anthonyle-ql/Salinas/docs/Salinas.JPG

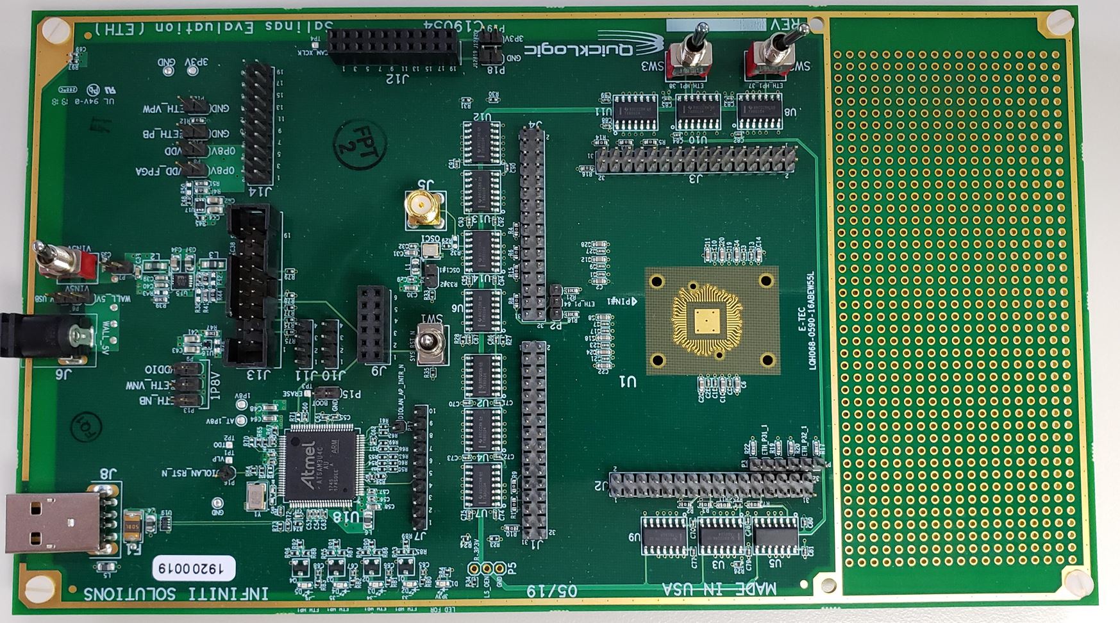
docs/Salinas.JPG
