anthonyle-ql/Salinas/docs/Update to Salinas Design.docx

Last Update: September 4, 2020

Version: 1.1

Subject: Salinas v1.1 Update

Summary of Update by page #

Page 1: no change; version # only

Page 2:

a. Change resistor value from 10KOhm to 1KOhm for R17, R20, R18, R21, R19 and R22 (BOM change)

Page 3:

a. Change R23, R24, R25, R26, R27 and R28 to 0 Ohm (BOM change)
b. Replace TXB0104DR with TXS0104EDR (BOM change)

Page 4:

a. Change R30, R31 and R34 to 0 Ohm (BOM change)
b. Change R35, R36 and R37 from 10KOhm to 1KOhm (BOM change)
c. Change TXB0104DR to TXS0104EDR (BOM change)

Page 5:

a. Add ground connection for J6 pin 2 (layout update)

Page 6:

a. Replace J8 with microUSB connector (layout update)
b. U18 is DNP (BOM change)

Page 7:

a. Add P20, a 1x2 header; connection as shown in schematic (layout update)

Page 8: No change

Page 9: No change
