anthonyle-ql/Salinas/docs/Salinasv1.1.pptx

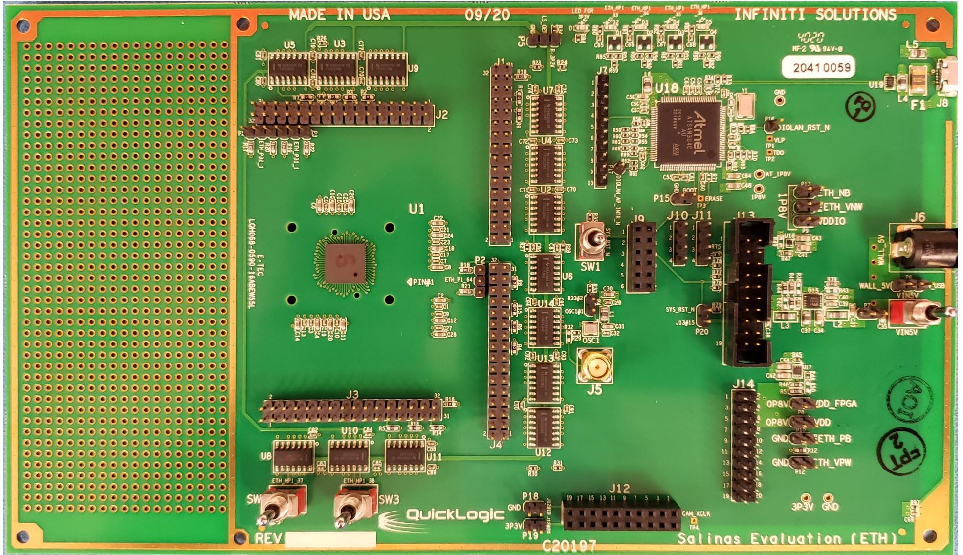
[picture p2: figure]

## Slide 2

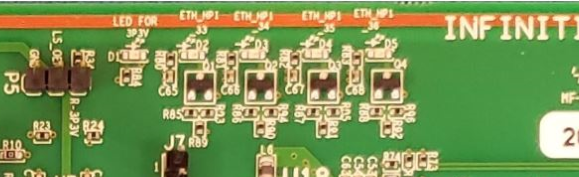
[picture p3: figure]

## Slide 3

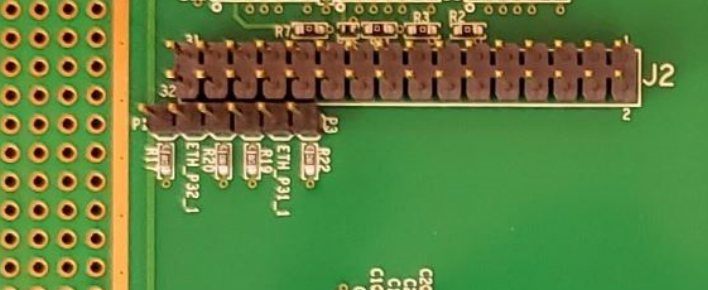
[picture p4: figure]
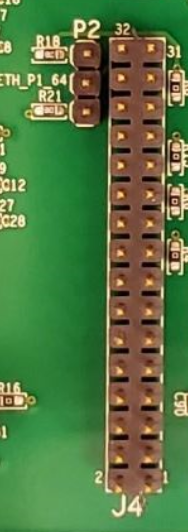
[picture p5: figure]

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
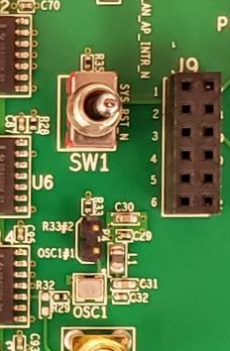
[picture p6: figure]

PU

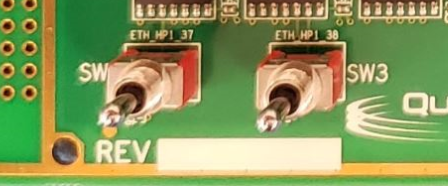
[picture p7: figure]

PU

GND

PU

GND

GND

## Slide 4

## Slide 5

## Slide 6
