anthonyle-ql/Salinas/docs/Salinas1.0 Bring Up Report.xlsx

Last Update: August 18, 2020
Subject: Salinas 1.0 bring up report
Index | Description | Action | Comment
1 | J8 foot print leaves no room for connecting an external USB externsion cable to the USB connector. | There are several possible fixes: 1. Stripped off the end of the expansion and use only the assertion cable. 2. Find straight connector to mount vertically. This may interferes with Fuse F1. 3. Move the foot print to the edge of the board. | Current solution is (2).
2 | Missing 3x1 male header at location P5 | To inform Infiniti solutions to update BOM assembly.
3 | Part Number for U18 is wrong. A generic Atmel device is not the correct part #. It must be the Diolan programmed part number. | To update BOM and inform Infiniti Solutions of BOM update.
4 | ETH_P28_1 signal is pull-up thru a zero ohm resistor . | This is wrong. Possible solutions: 1. change resistor to 10K (for pull-up) 2. Remove the resistor if not need. | Current solution is (2).
5 | J6 is missing GND | Update schematic
6 | The TXB0104DR requires stronger pull to get it to work for bidirectional control | Talk to Greg to understand the fixes | TBD
