anthonyle-ql/Salinas/from Infiniti Solutions/C20197-SALINAS_V1_1-CR.PDF

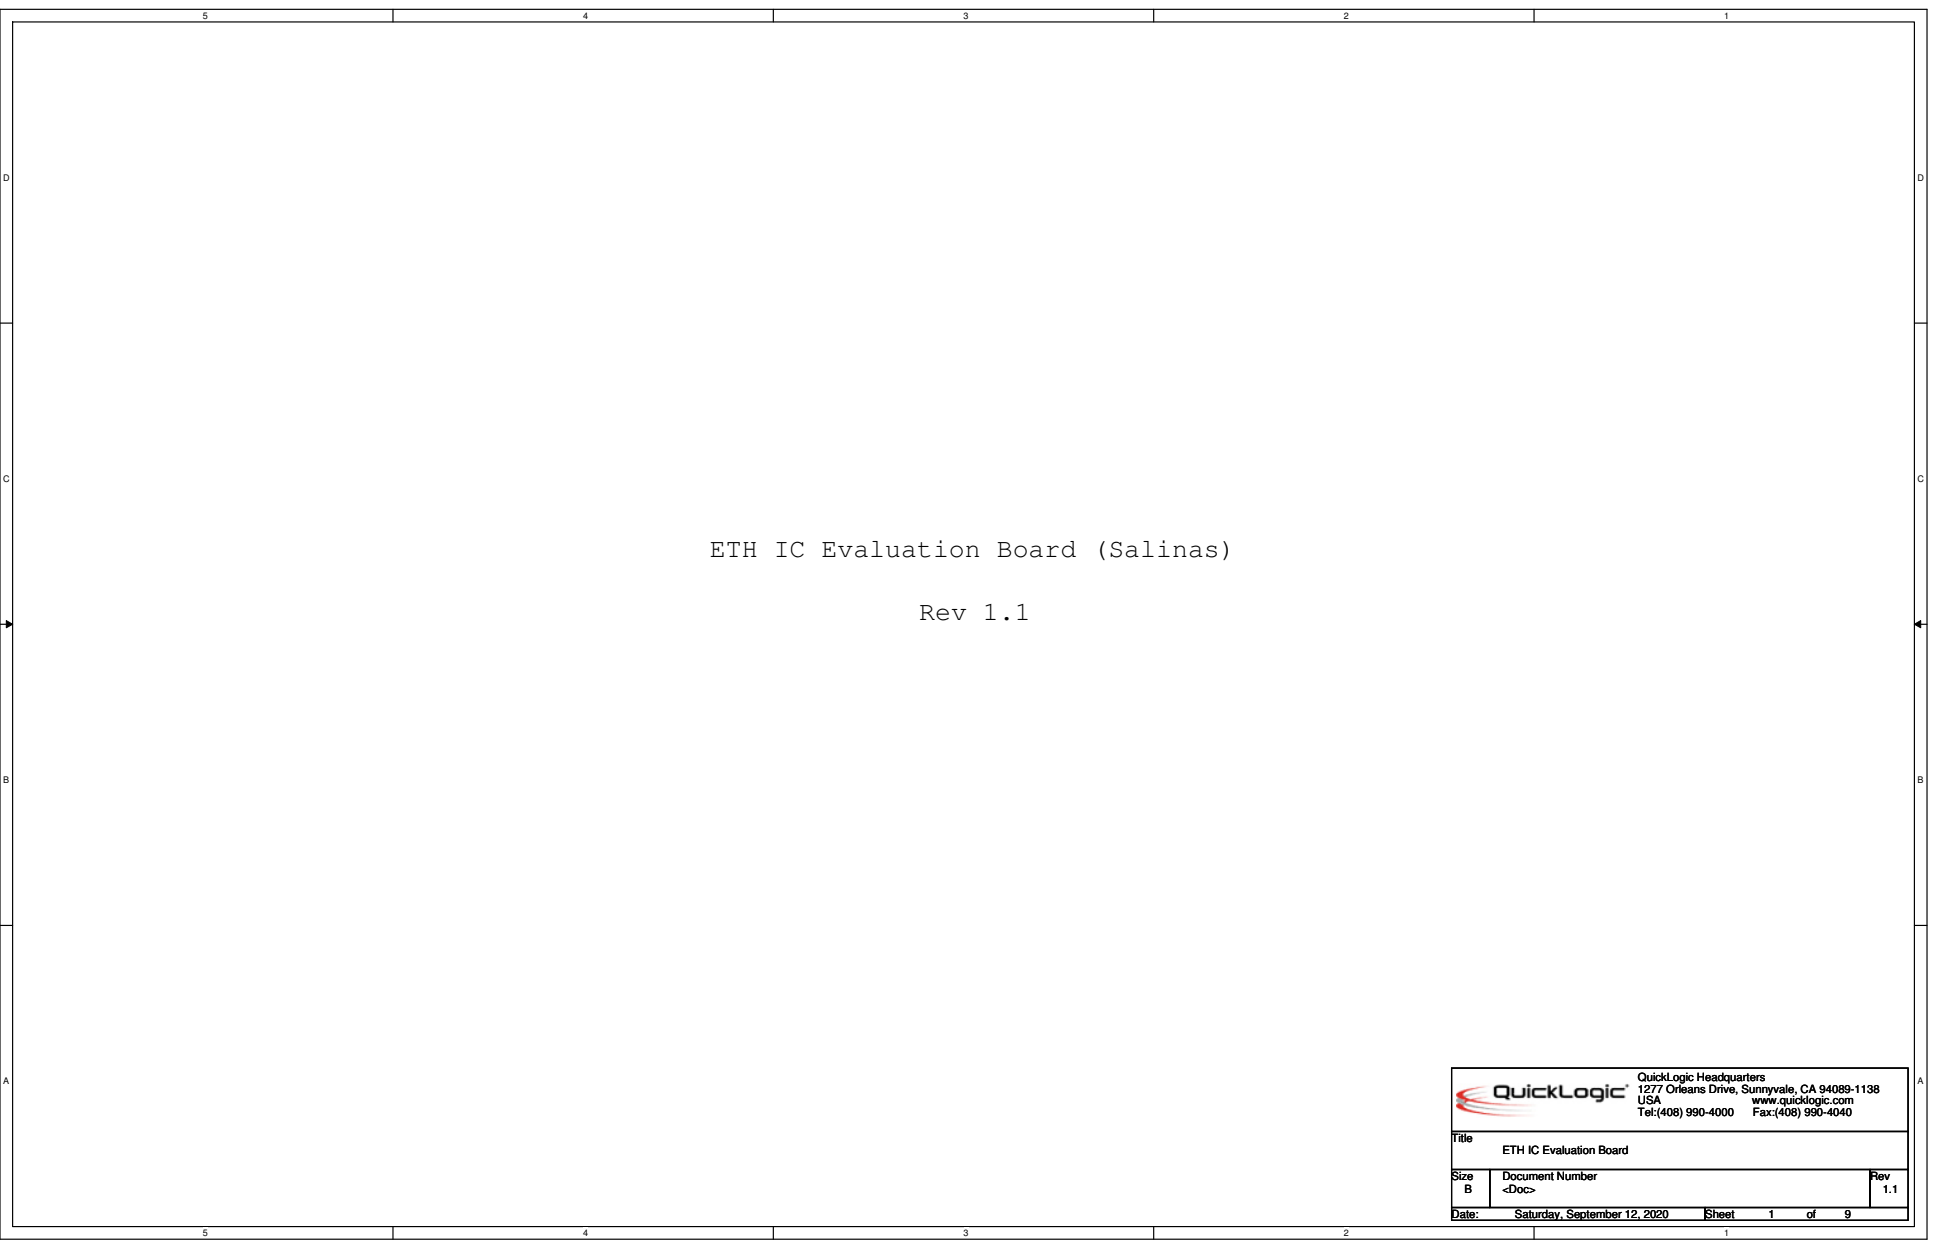
[picture p8: page 1]
Rev 1.1; Title; USA; www.quicklogic.com; Tel:(408) 990-4000; Fax:(408) 990-4040

ETH IC Evaluation Board (Salinas)

QuickLogic Headquarters
1277 Orleans Drive, Sunnyvale, CA 94089-1138

ETH IC Evaluation Board

Size Size Size B B B | Document Number Document Number Document Number <Doc> <Doc> <Doc> | Rev Rev Rev 1.1 1.1 1.1

Date: Date: Date: Saturday, September 12, 2020 Saturday, September 12, 2020 Saturday, September 12, 2020 | Sheet Sheet Sheet 1 1 1 of of of 9 9 9

# 68602-132HLF 13579

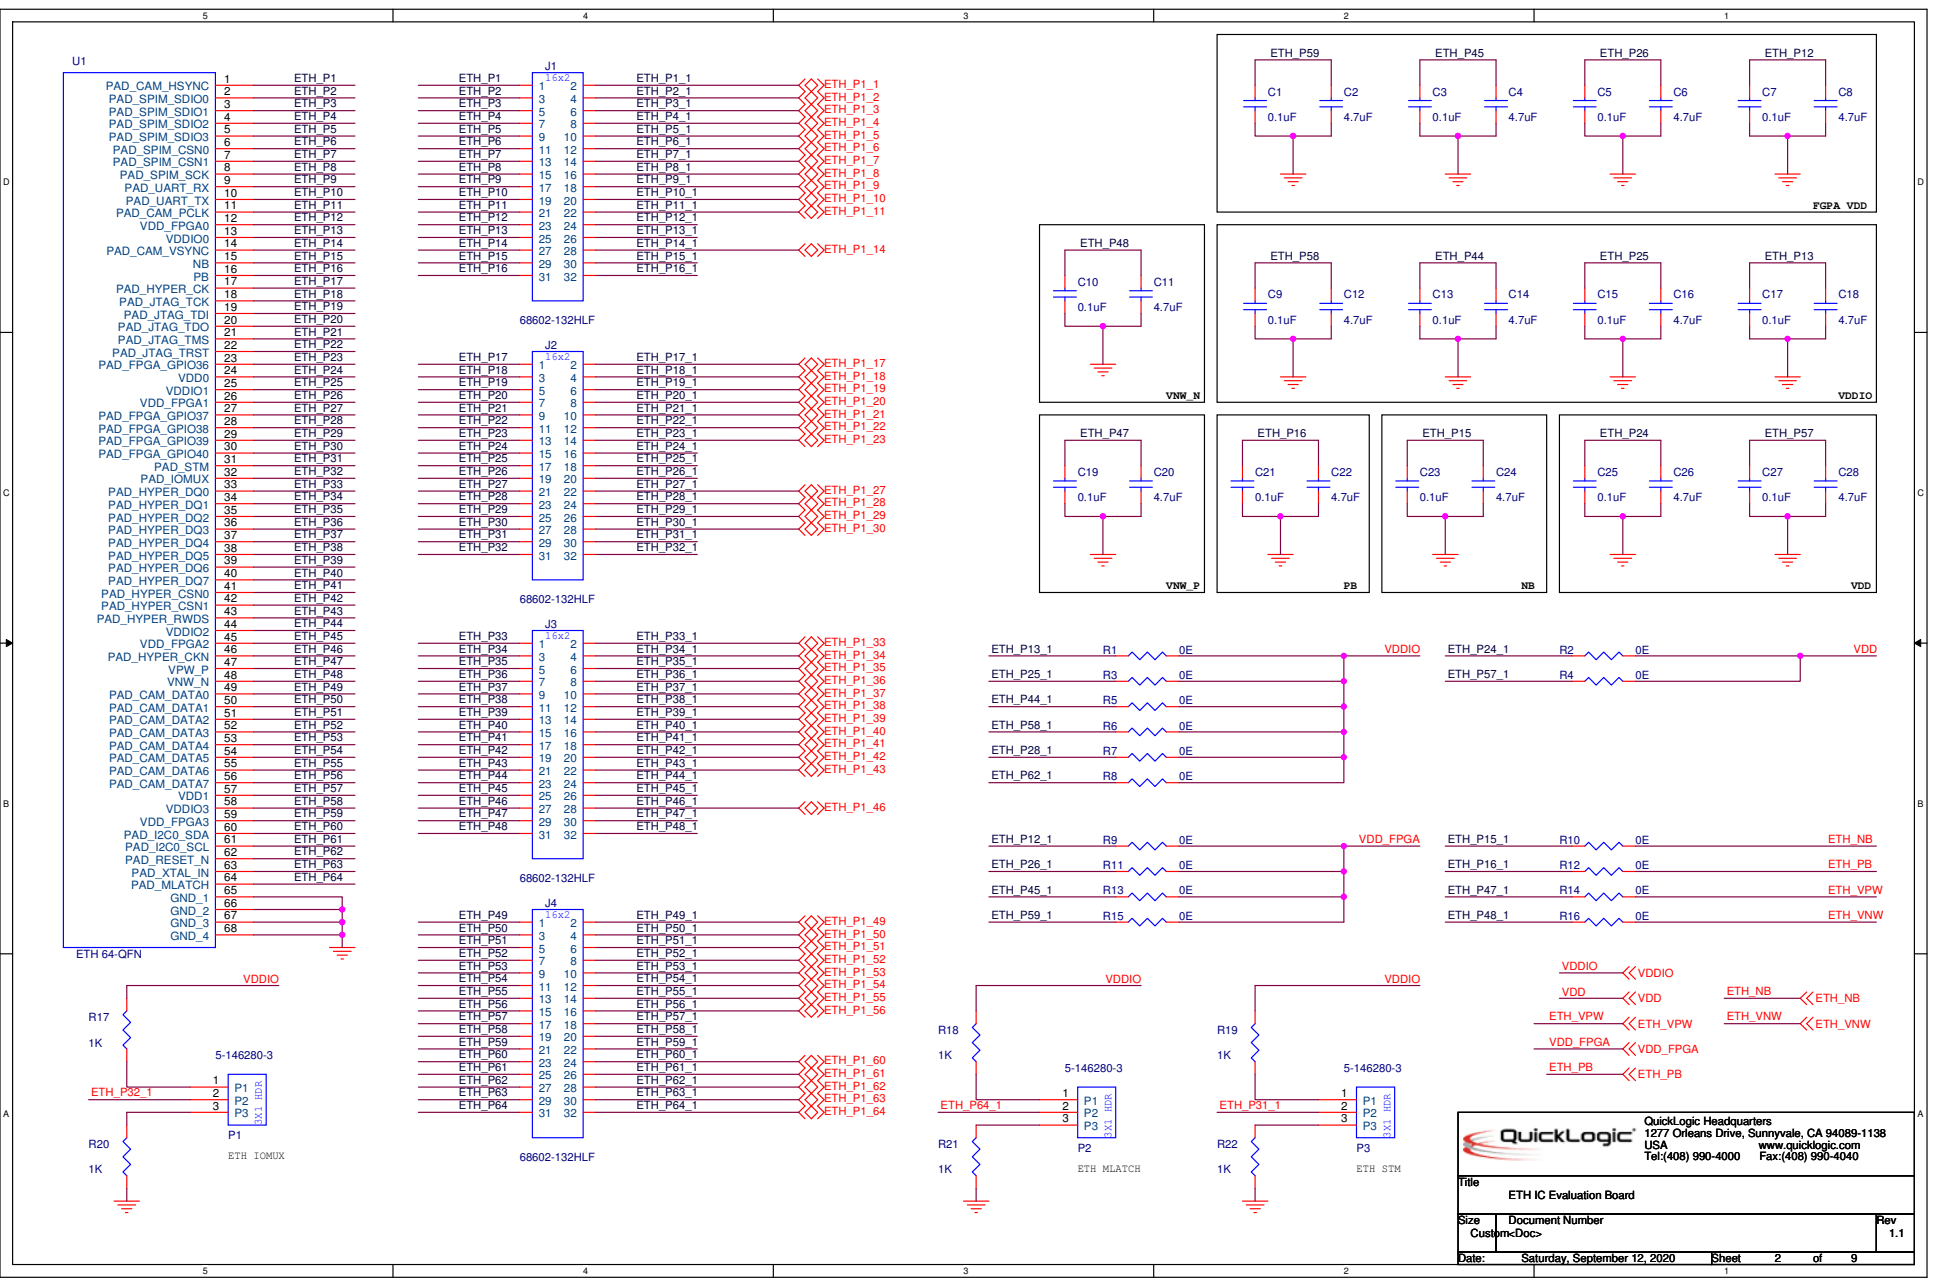
[picture p9: page 2]

QuickLogic Headquarters
1277 Orleans Drive, Sunnyvale, CA 94089-1138

ETH IC Evaluation Board

Size Size Size Custom Custom Custom | Document Number Document Number Document Number <Doc> <Doc> <Doc> | Rev Rev Rev 1.1 1.1 1.1

Date: Date: Date: Saturday, September 12, 2020 Saturday, September 12, 2020 Saturday, September 12, 2020 | Sheet Sheet Sheet 2 2 2 of of of 9 9 9

3P3V | 3P3V | LEVEL SHIFTERS

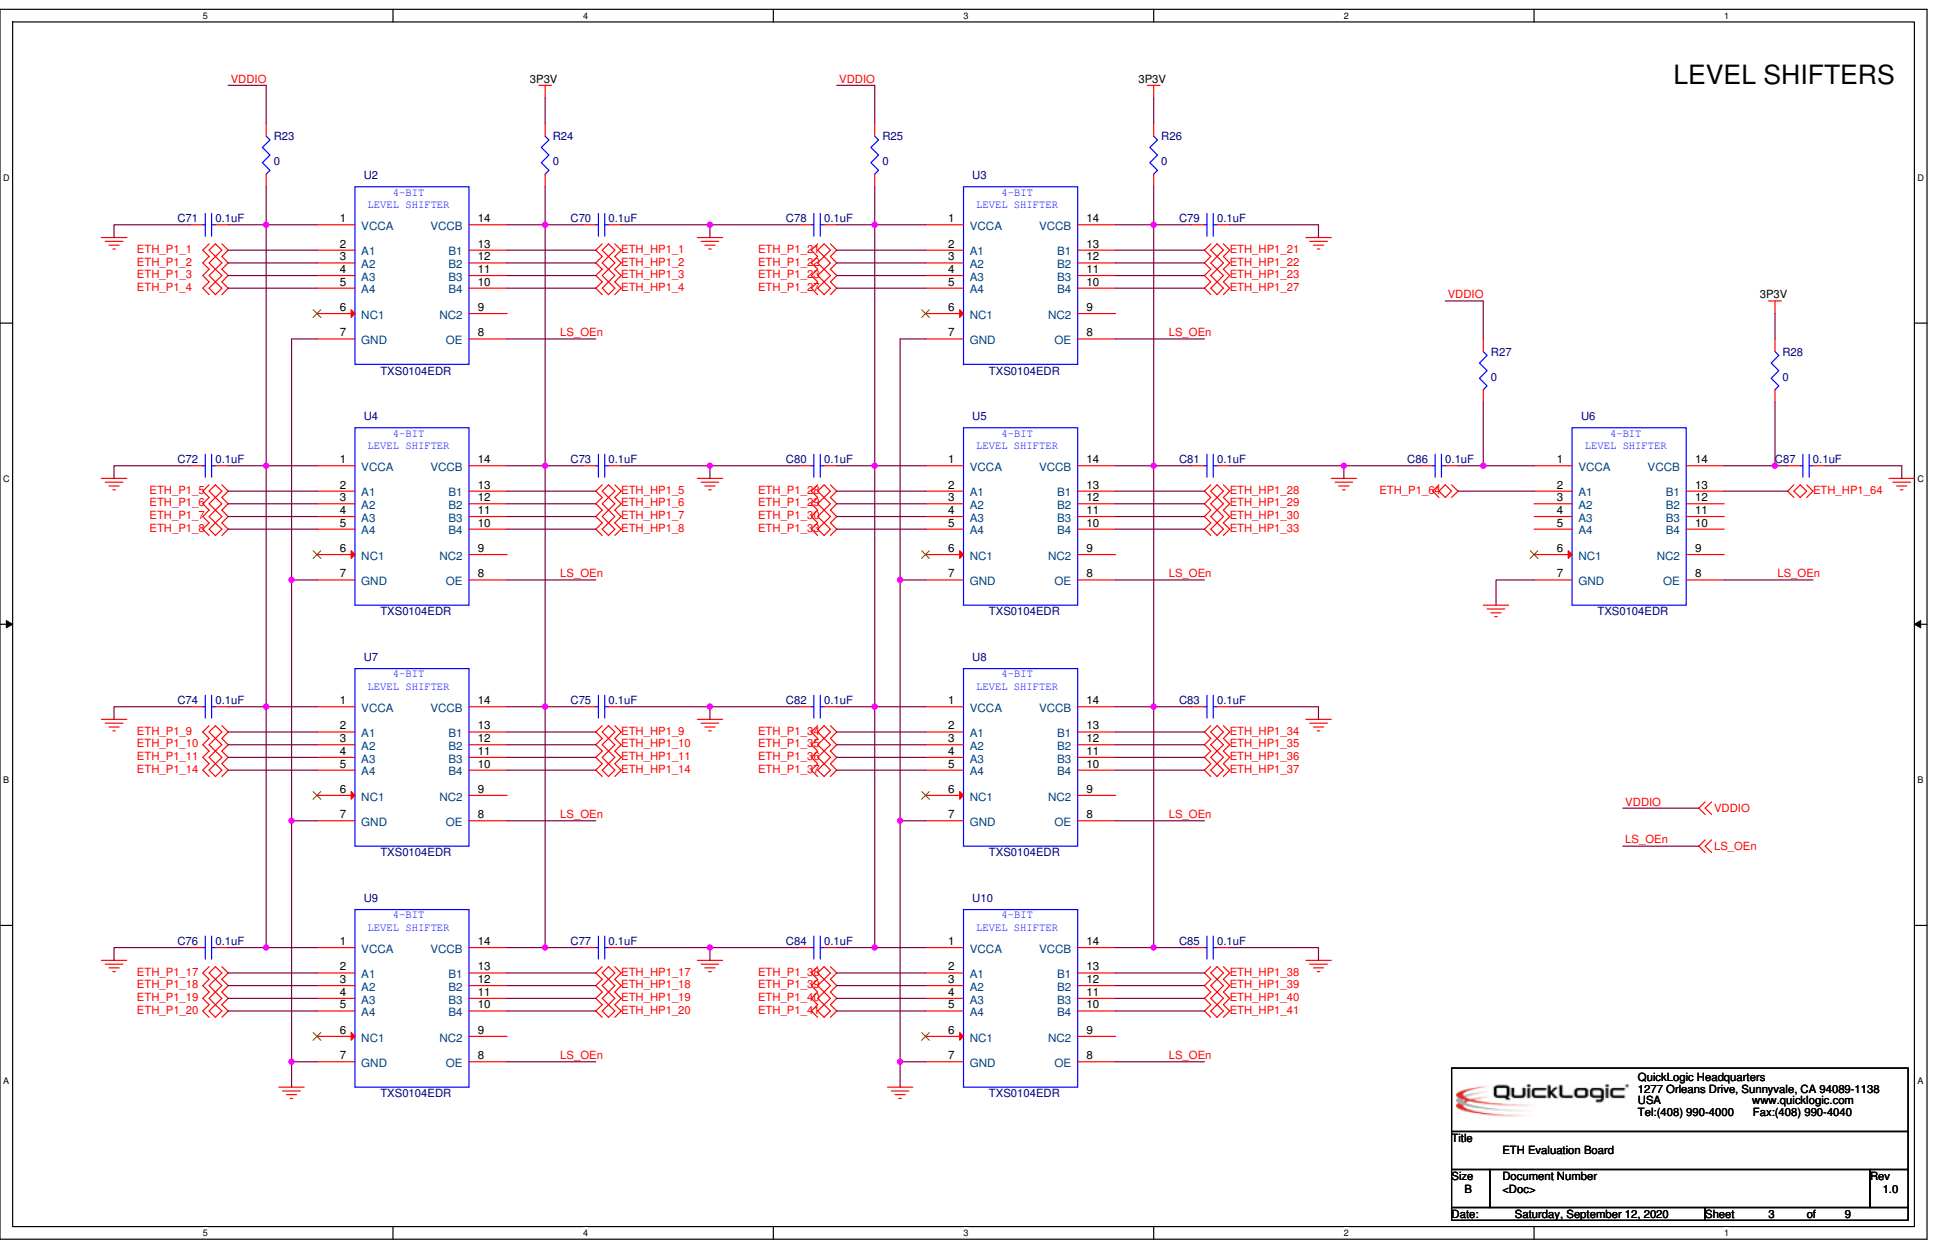
[picture p10: page 3]

QuickLogic Headquarters
1277 Orleans Drive, Sunnyvale, CA 94089-1138

Size Size Size B B B | Document Number Document Number Document Number <Doc> <Doc> <Doc> | Rev Rev Rev 1.0 1.0 1.0

Date: Date: Date: Saturday, September 12, 2020 Saturday, September 12, 2020 Saturday, September 12, 2020 | Sheet Sheet Sheet 3 3 3 of of of 9 9 9

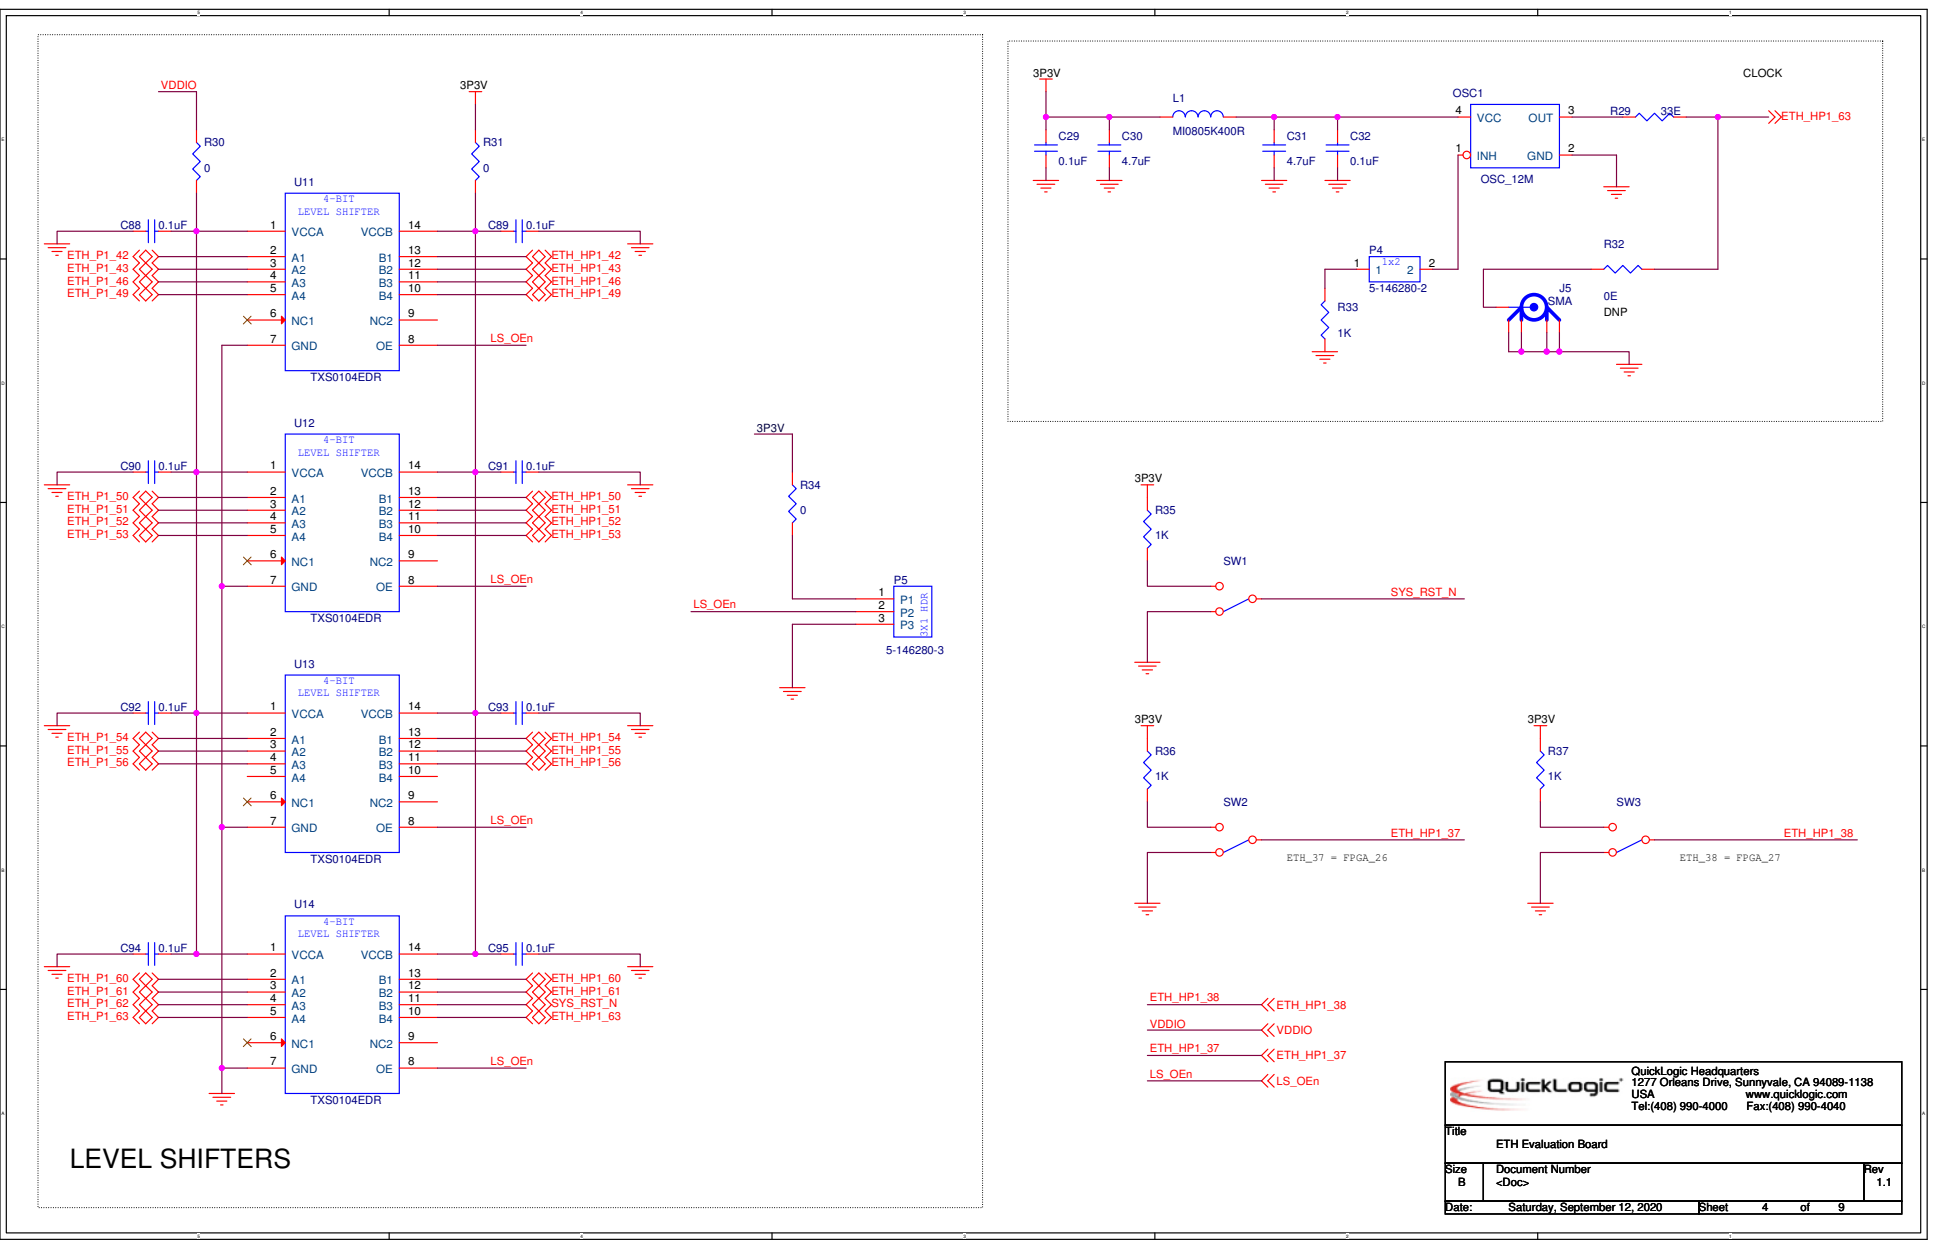
[picture p11: page 4]

QuickLogic Headquarters
1277 Orleans Drive, Sunnyvale, CA 94089-1138

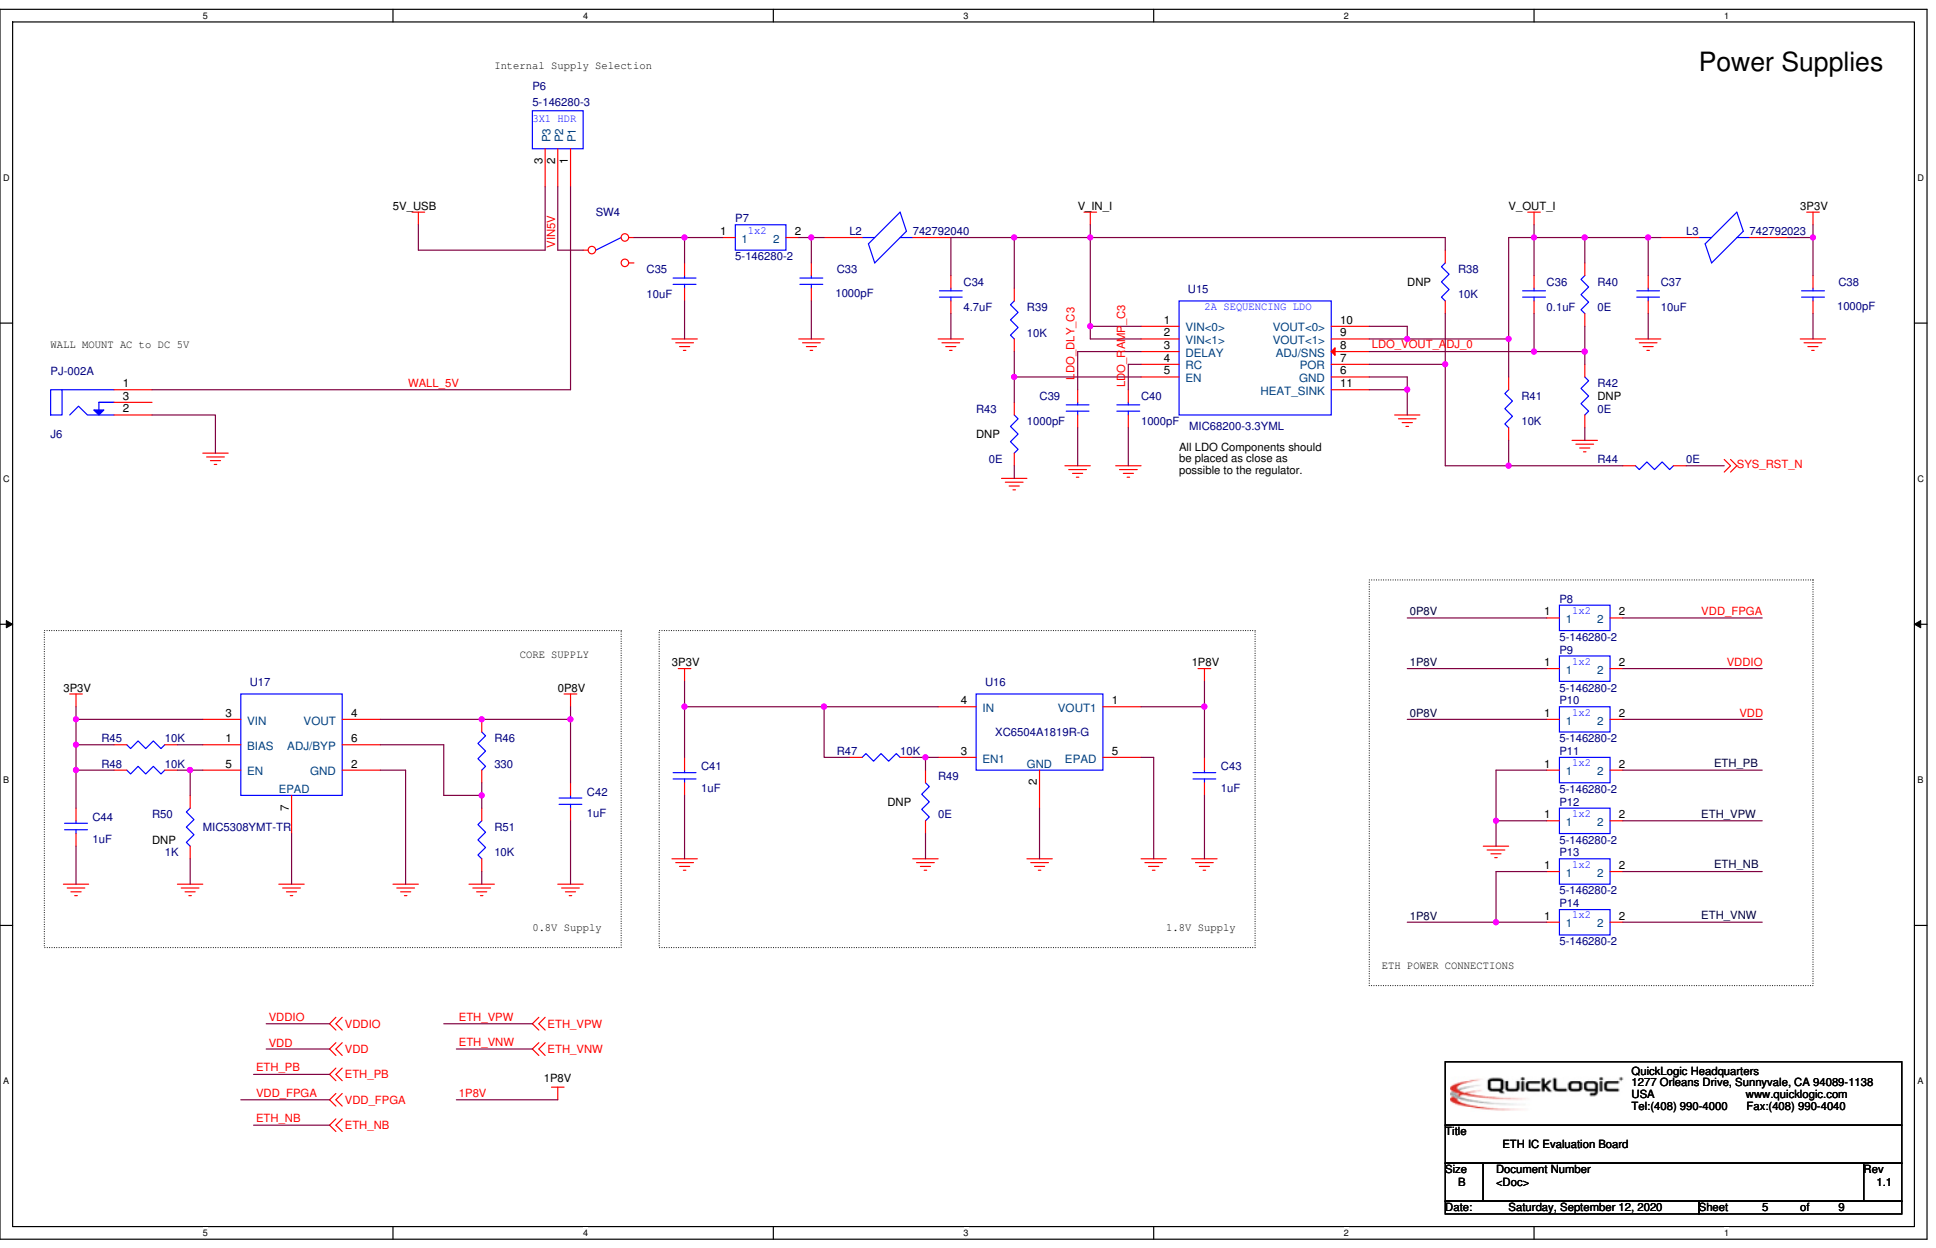
[picture p12: page 5]

WALL MOUNT AC to DC 5V

MIC68200-3.3YML
All LDO Components should
be placed as close as
possible to the regulator.

QuickLogic Headquarters
1277 Orleans Drive, Sunnyvale, CA 94089-1138

ETH IC Evaluation Board

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

Date: Date: Date: Saturday, September 12, 2020 Saturday, September 12, 2020 Saturday, September 12, 2020 | Sheet Sheet Sheet 5 5 5 of of of 9 9 9

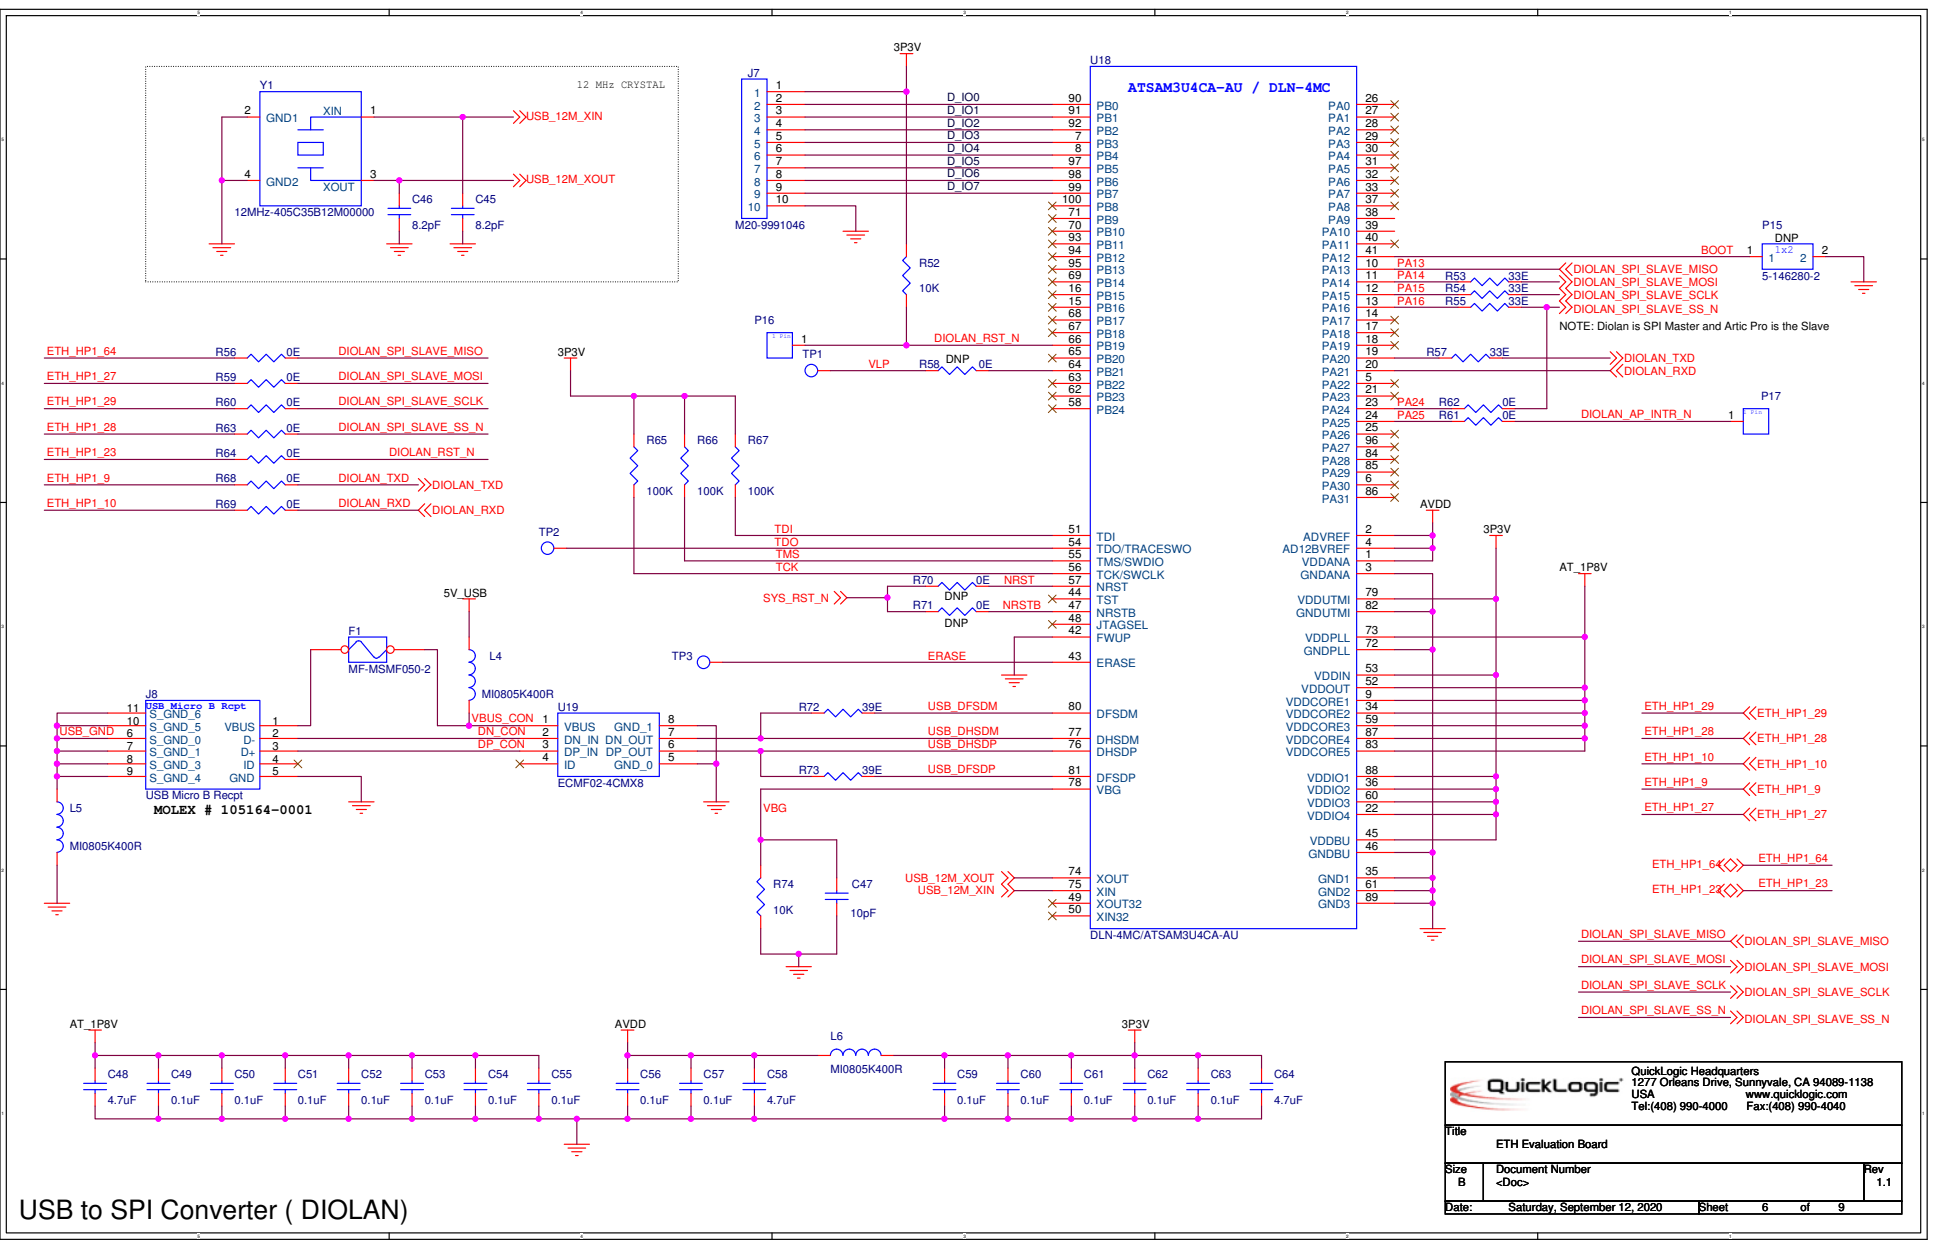
[picture p13: page 6]

5 | D_IO3 | PB3 7
6 | D_IO4 | PB4 8
7 | D_IO5 | PB5 97
8 | D_IO6 | PB6 98
9 | D_IO7 | PB7 99

DIOLAN_SPI_SLAVE_MISO
DIOLAN_SPI_SLAVE_MOSI
DIOLAN_SPI_SLAVE_SCLK
DIOLAN_SPI_SLAVE_SS_N
NOTE: Diolan is SPI Master and Artic Pro is the Slave

QuickLogic Headquarters
1277 Orleans Drive, Sunnyvale, CA 94089-1138

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

USB to SPI Converter ( DIOLAN)

Date: Date: Date: Saturday, September 12, 2020 Saturday, September 12, 2020 Saturday, September 12, 2020 | Sheet Sheet Sheet 6 6 6 of of of 9 9 9

# EXPANSION HEADERS

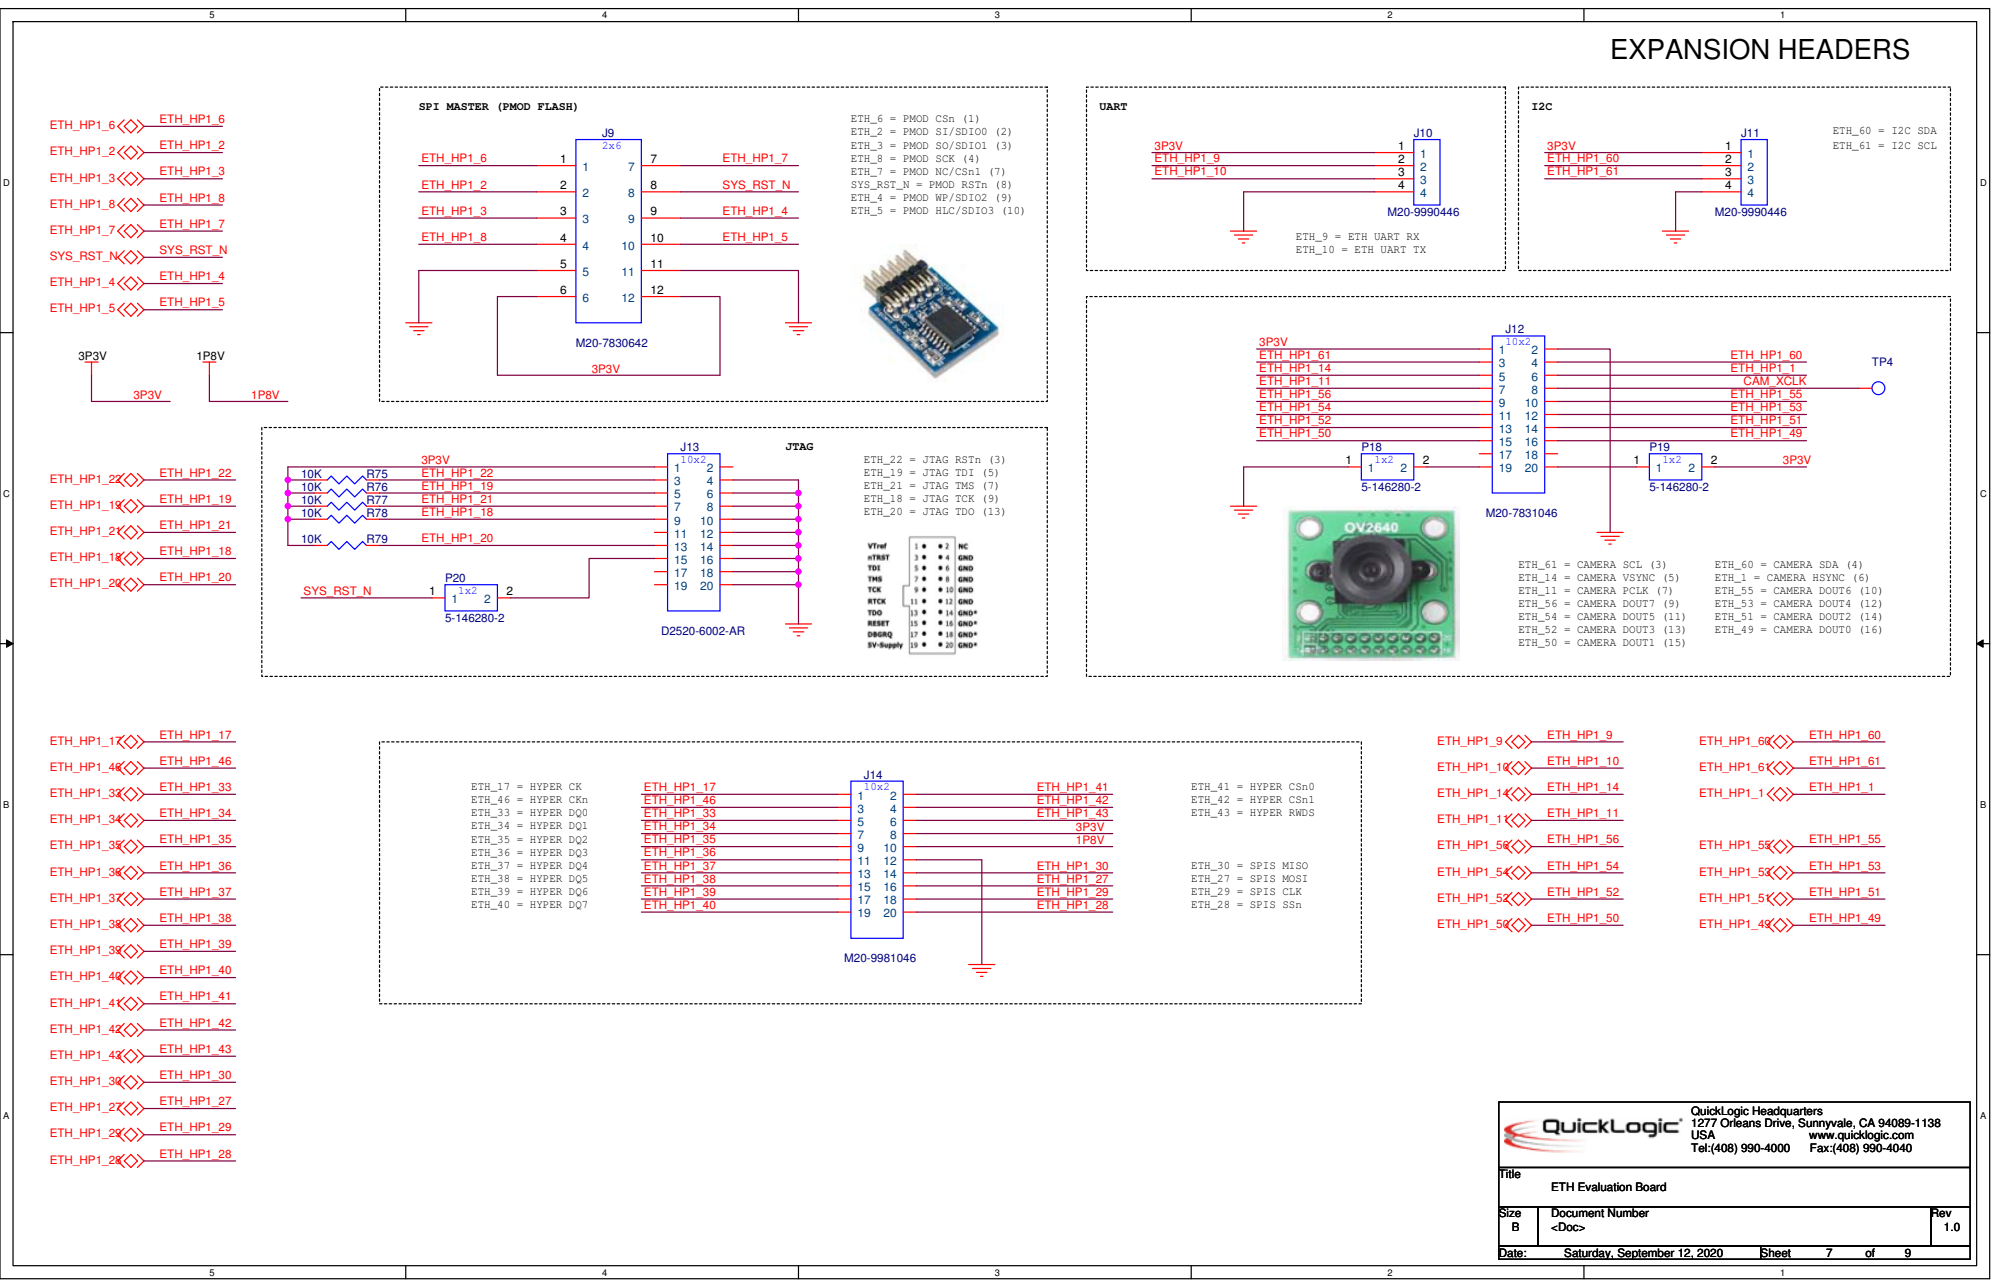
[picture p14: page 7]

QuickLogic Headquarters
1277 Orleans Drive, Sunnyvale, CA 94089-1138

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

Date: Date: Date: Saturday, September 12, 2020 Saturday, September 12, 2020 Saturday, September 12, 2020 | Sheet Sheet Sheet 7 7 7 of of of 9 9 9

# LEDs

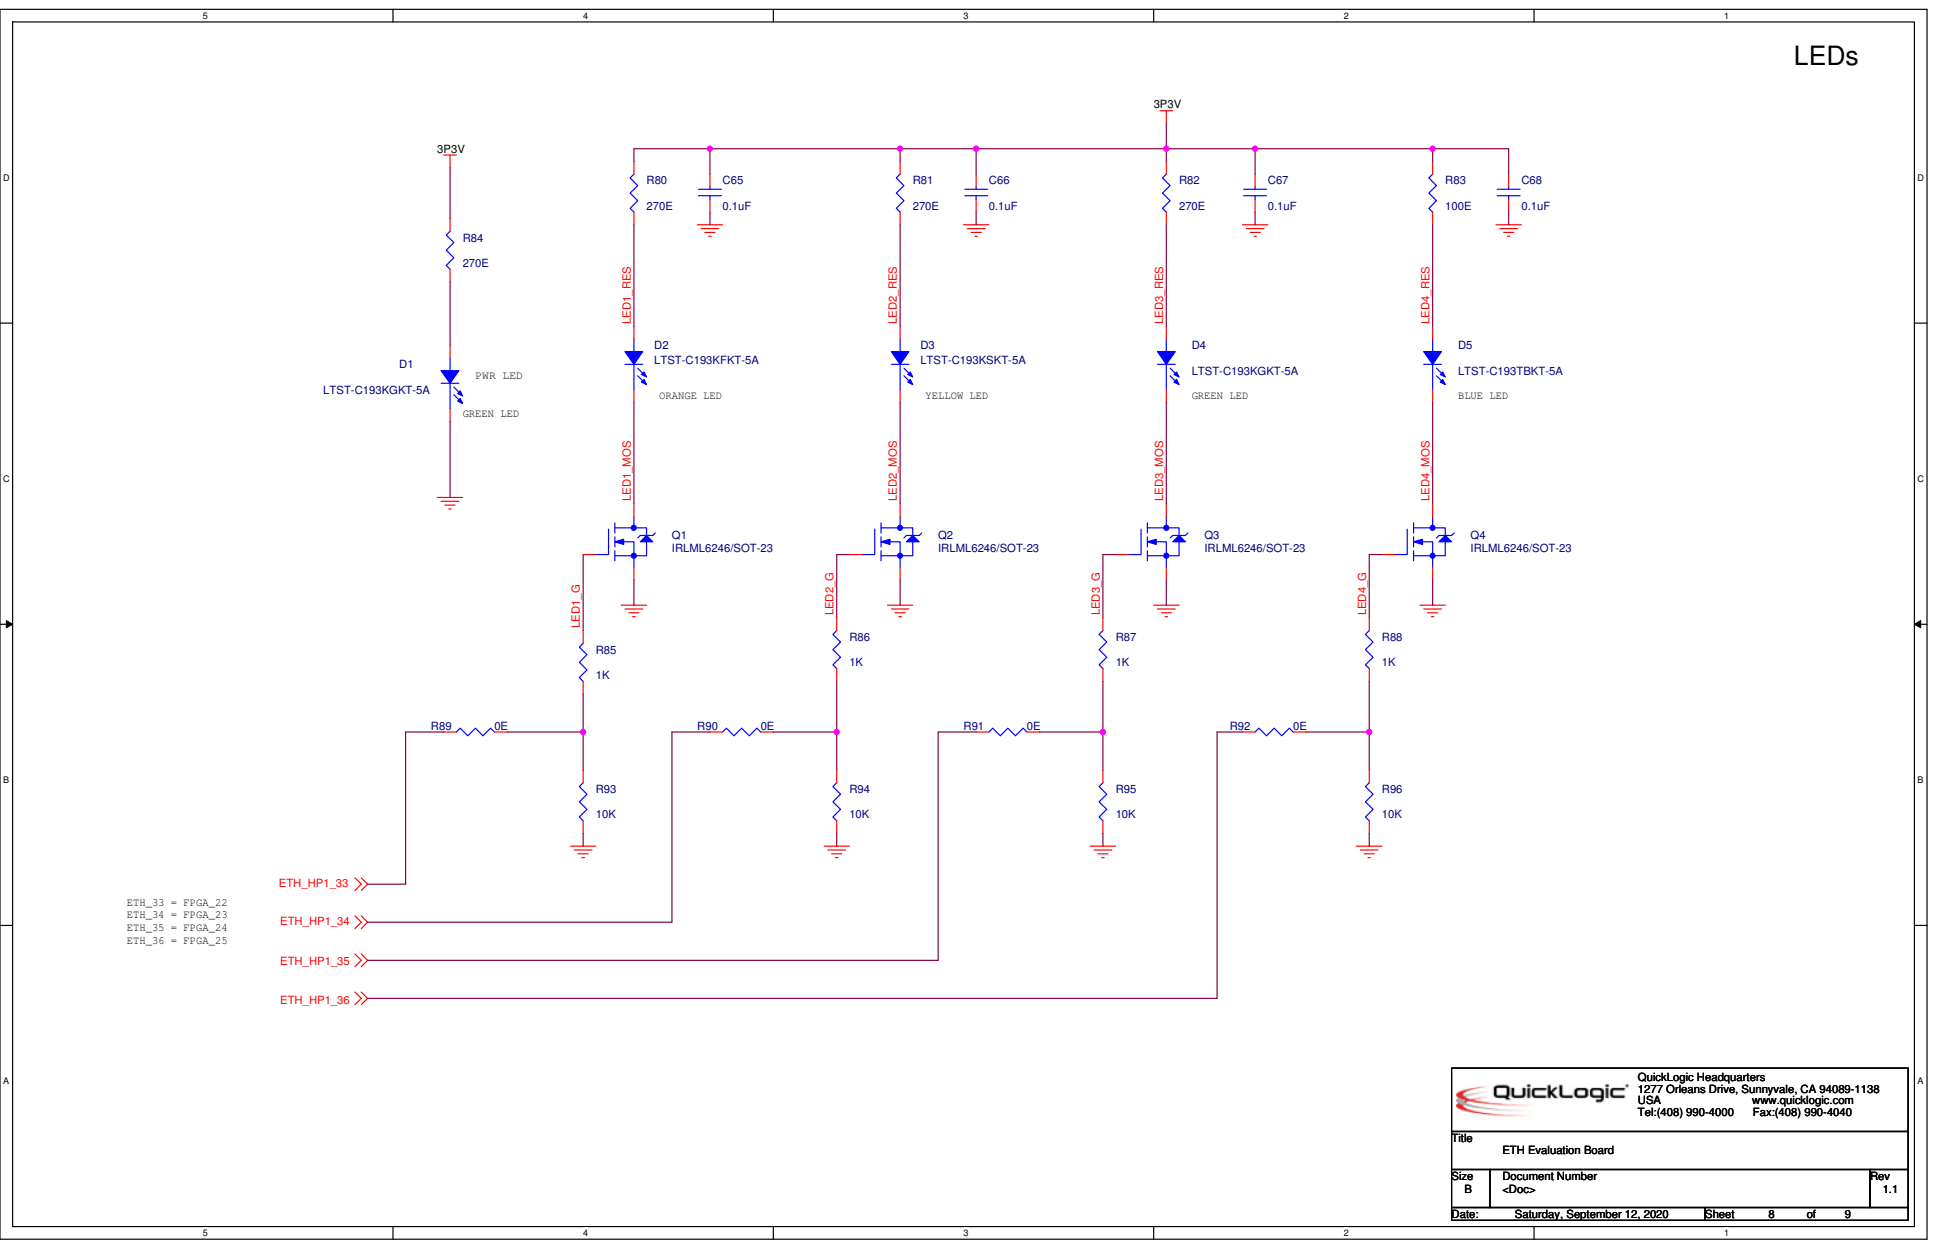
[picture p15: page 8]

QuickLogic Headquarters
1277 Orleans Drive, Sunnyvale, CA 94089-1138

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

Date: Date: Date: Saturday, September 12, 2020 Saturday, September 12, 2020 Saturday, September 12, 2020 | Sheet Sheet Sheet 8 8 8 of of of 9 9 9

# Mounting Holes and ESD Strip

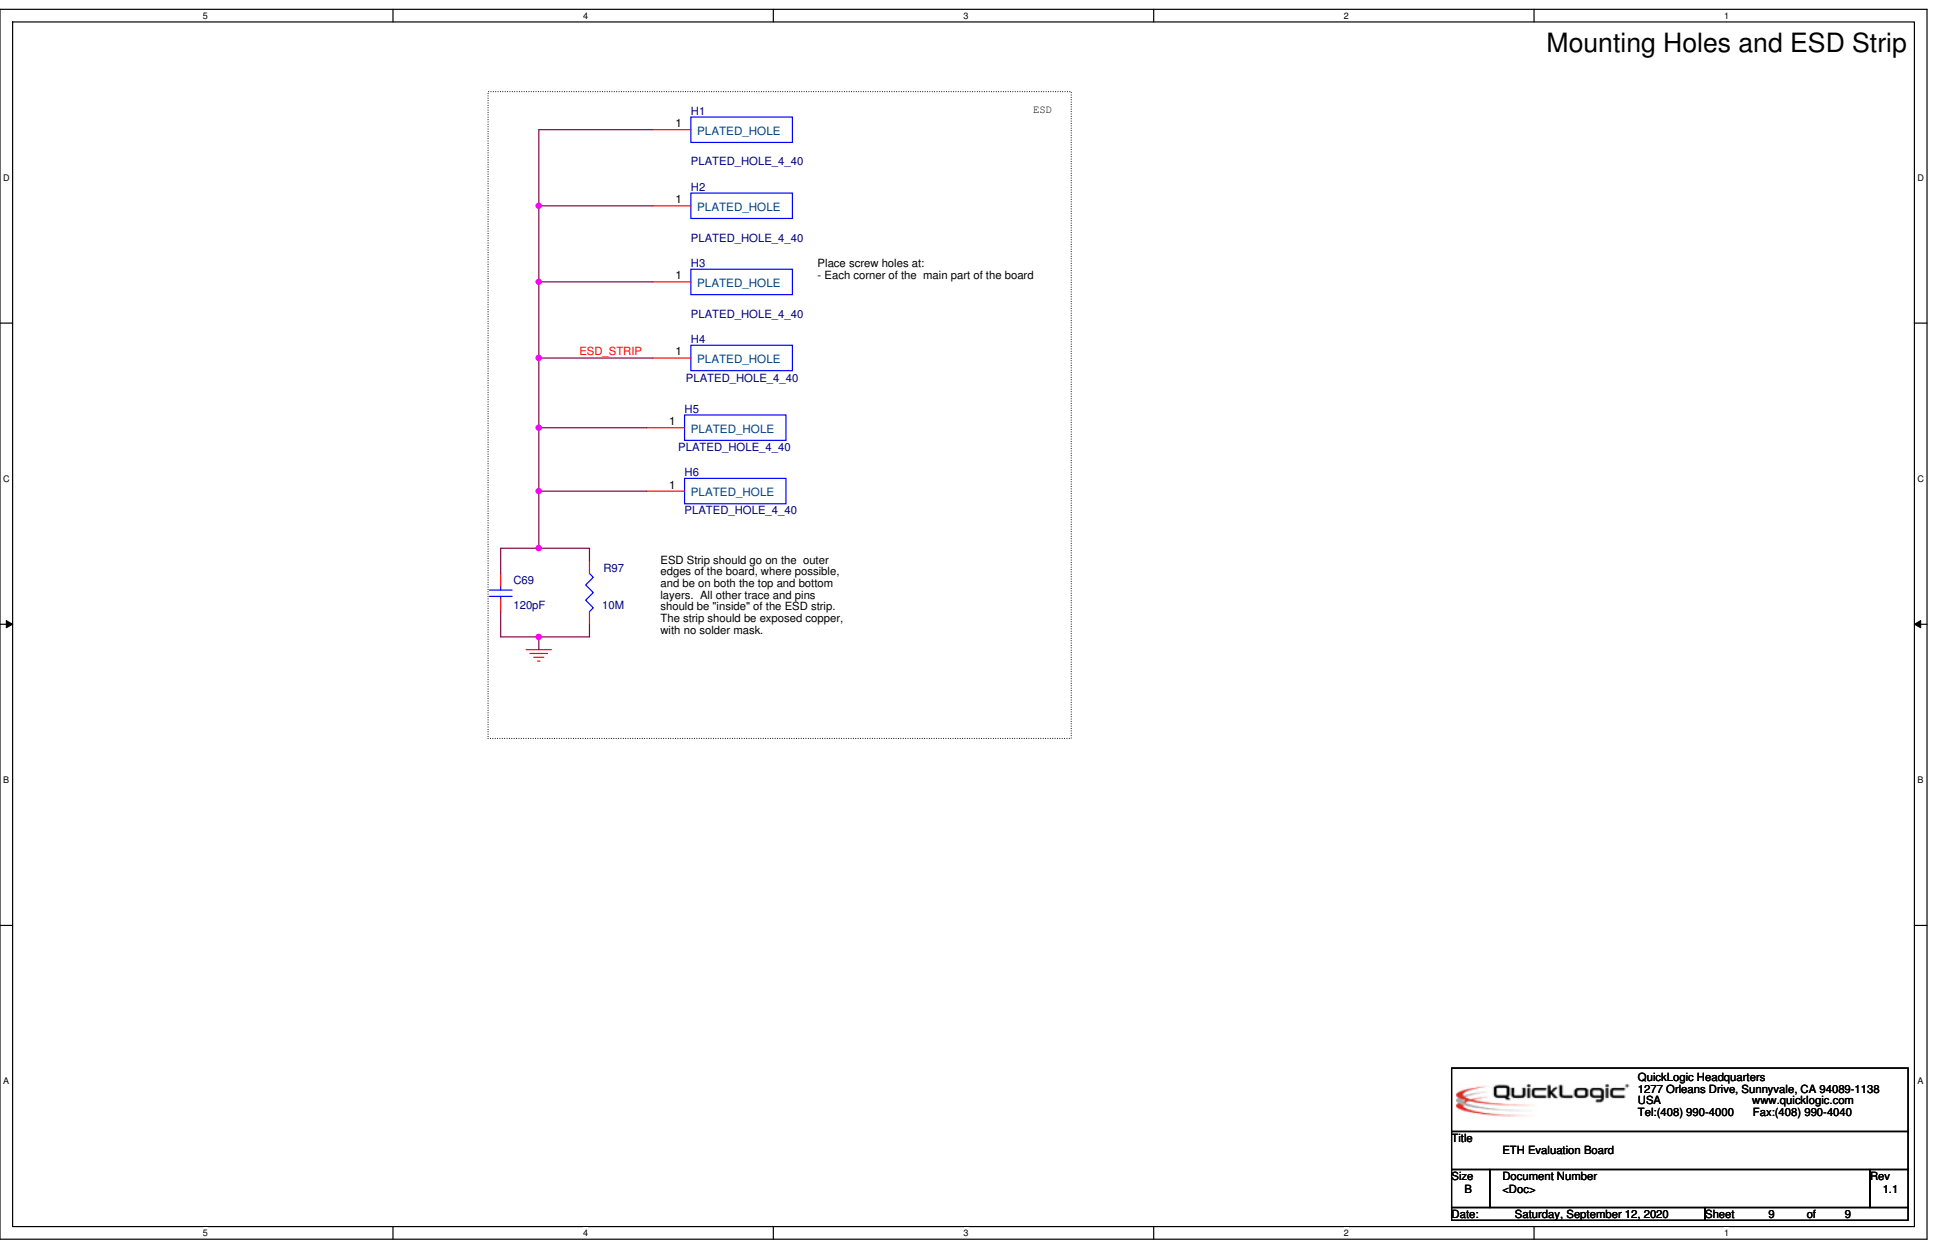
[picture p16: page 9]
ESD; Title; USA; www.quicklogic.com; Tel:(408) 990-4000; Fax:(408) 990-4040; PLATED_HOLE_4_40; PLATED_HOLE 1; ESD_STRIP

Place screw holes at:
- Each corner of the main part of the board

ESD Strip should go on the outer
edges of the board, where possible,
and be on both the top and bottom
layers. All other trace and pins
should be "inside" of the ESD strip.
The strip should be exposed copper,
with no solder mask.

QuickLogic Headquarters
1277 Orleans Drive, Sunnyvale, CA 94089-1138

ETH Evaluation Board

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

Date: Date: Date: Saturday, September 12, 2020 Saturday, September 12, 2020 Saturday, September 12, 2020 | Sheet Sheet Sheet 9 9 9 of of of 9 9 9

# N2887188 GND N2887188 ETH_HP1_8

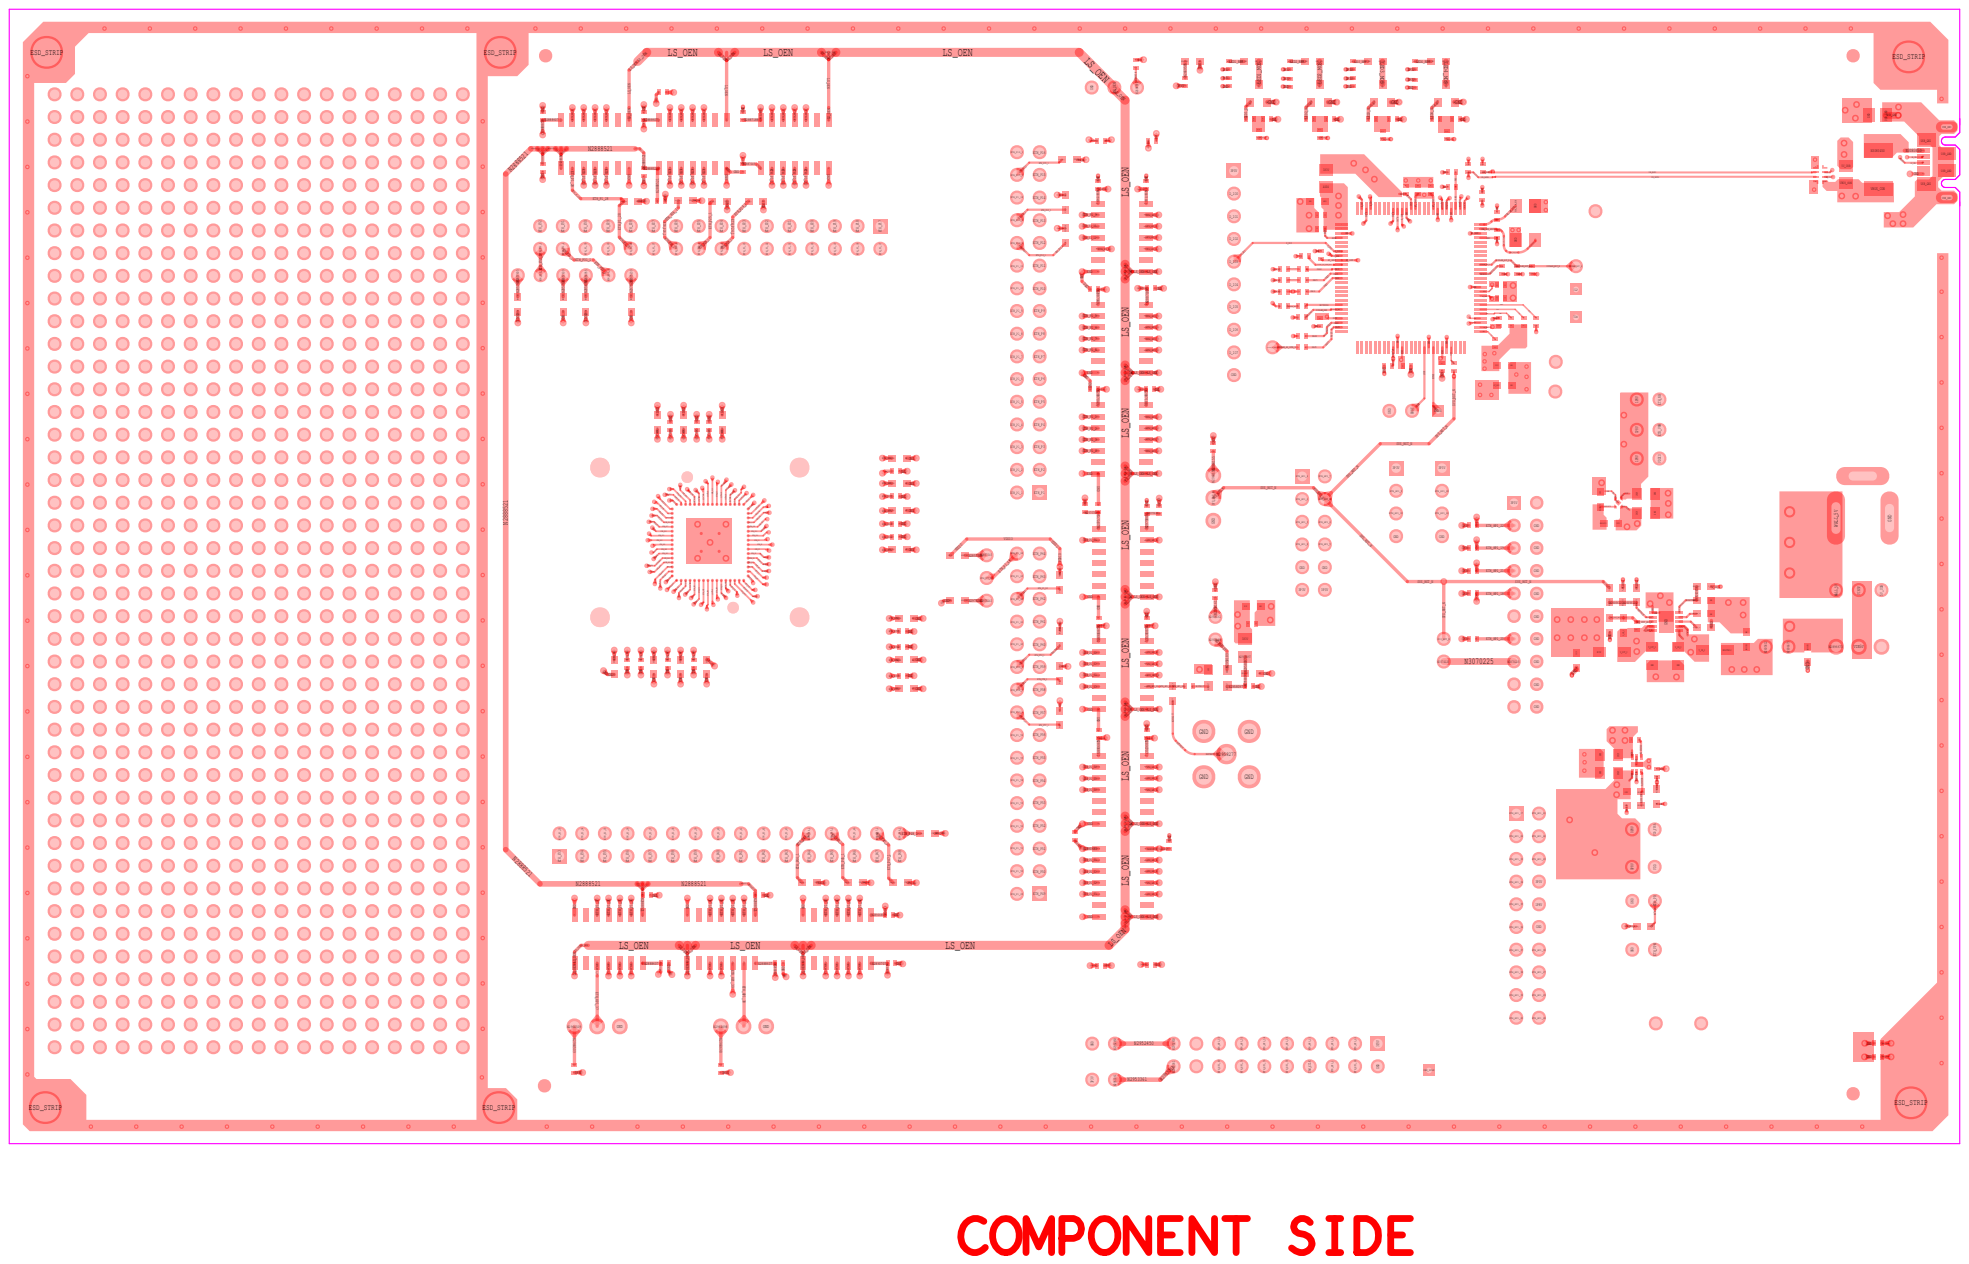
[picture p17: page 10]
DN_CON; USB_GND; DP_CON; DP_CON GND; GND; ESD_STRIP; DN_CONDP_CON DP_CON; N2605584 LDO_DLY_C3; LDO_RAMP_C3; 3P3V N2606378N2606378 GND; ETH_PB ETH_PB; GND GND; V_OUT_I; V_OUT_I V_OUT_I; LDO_VOUT_ADJ_0; LDO_VOUT_ADJ_0 LDO_VOUT_ADJ_0; N2605612 N2605612 GND; GND ETH_P16_1; ETH_HP1_23; DIOLAN_RST_N; LED4_MOS; ETH_HP1_36; VBGVBG; USB_DFSDP; USB_DHSDM; USB_DHSDM USB_DHSDM USB_DHSDM USB_DHSDM; USB_12M_XIN; USB_DHSDP USB_DHSDP; USB_DHSDP; USB_DFSDM; USB_DFSDM USB_DFSDM; DIOLAN_RST_N DIOLAN_RST_N; VLP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

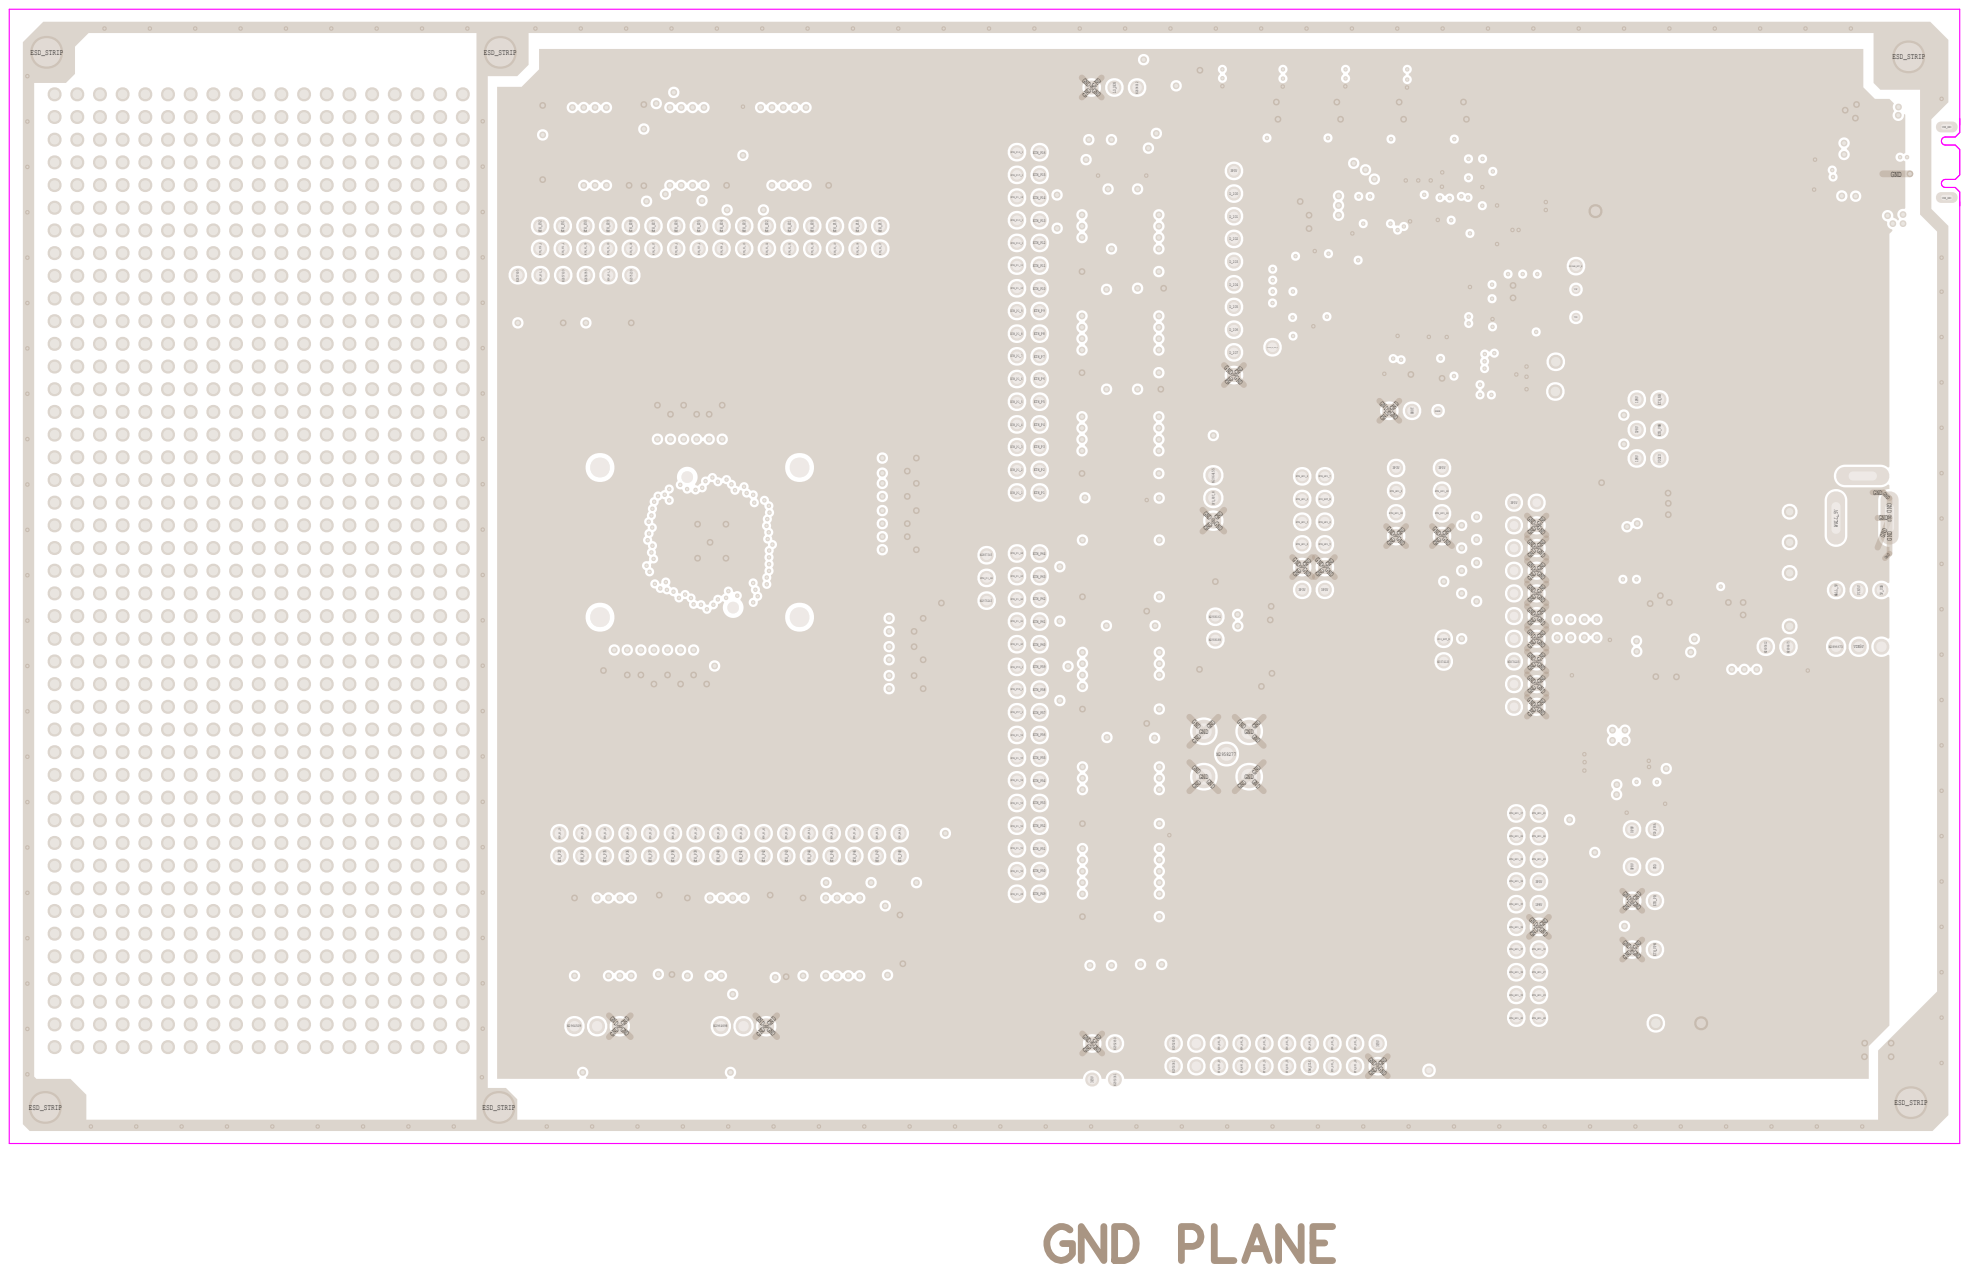
[picture p18: page 11]
GND; GND GND GND GNDGNDGNDGND; GNDGNDGNDGND; GNDGND GNDGND; GNDGND; GND GNDGND; GNDGND GND; GND GND; USB_GND; ESD_STRIP; 5V_USB; WALL_5V; VIN5V; ETH_NB VDDIO ETH_VNW; VDD_FPGA; VDD ETH_VPW; ETH_PB; DIOLAN_RST_N; VLP; TDO; ETH_HP1_41; ETH_HP1_42; ETH_HP1_43; ETH_HP1_30; ETH_HP1_28; ETH_HP1_29; ETH_HP1_27; ETH_HP1_17; ETH_HP1_46; ETH_HP1_33; ETH_HP1_34; ETH_HP1_35; ETH_HP1_36; ETH_HP1_37; ETH_HP1_38; ETH_HP1_39; ETH_HP1_40; BOOT; ERASE; ETH_HP1_10; ETH_HP1_9; ETH_HP1_61; ETH_HP1_60; SYS_RST_N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

GND
GNDGND GND GND GND

GNDGND GNDGND GND GND

GNDGND GNDGND GNDGND GNDGND GNDGND GNDGND GNDGND GNDGND GNDGND GNDGND

GND GND

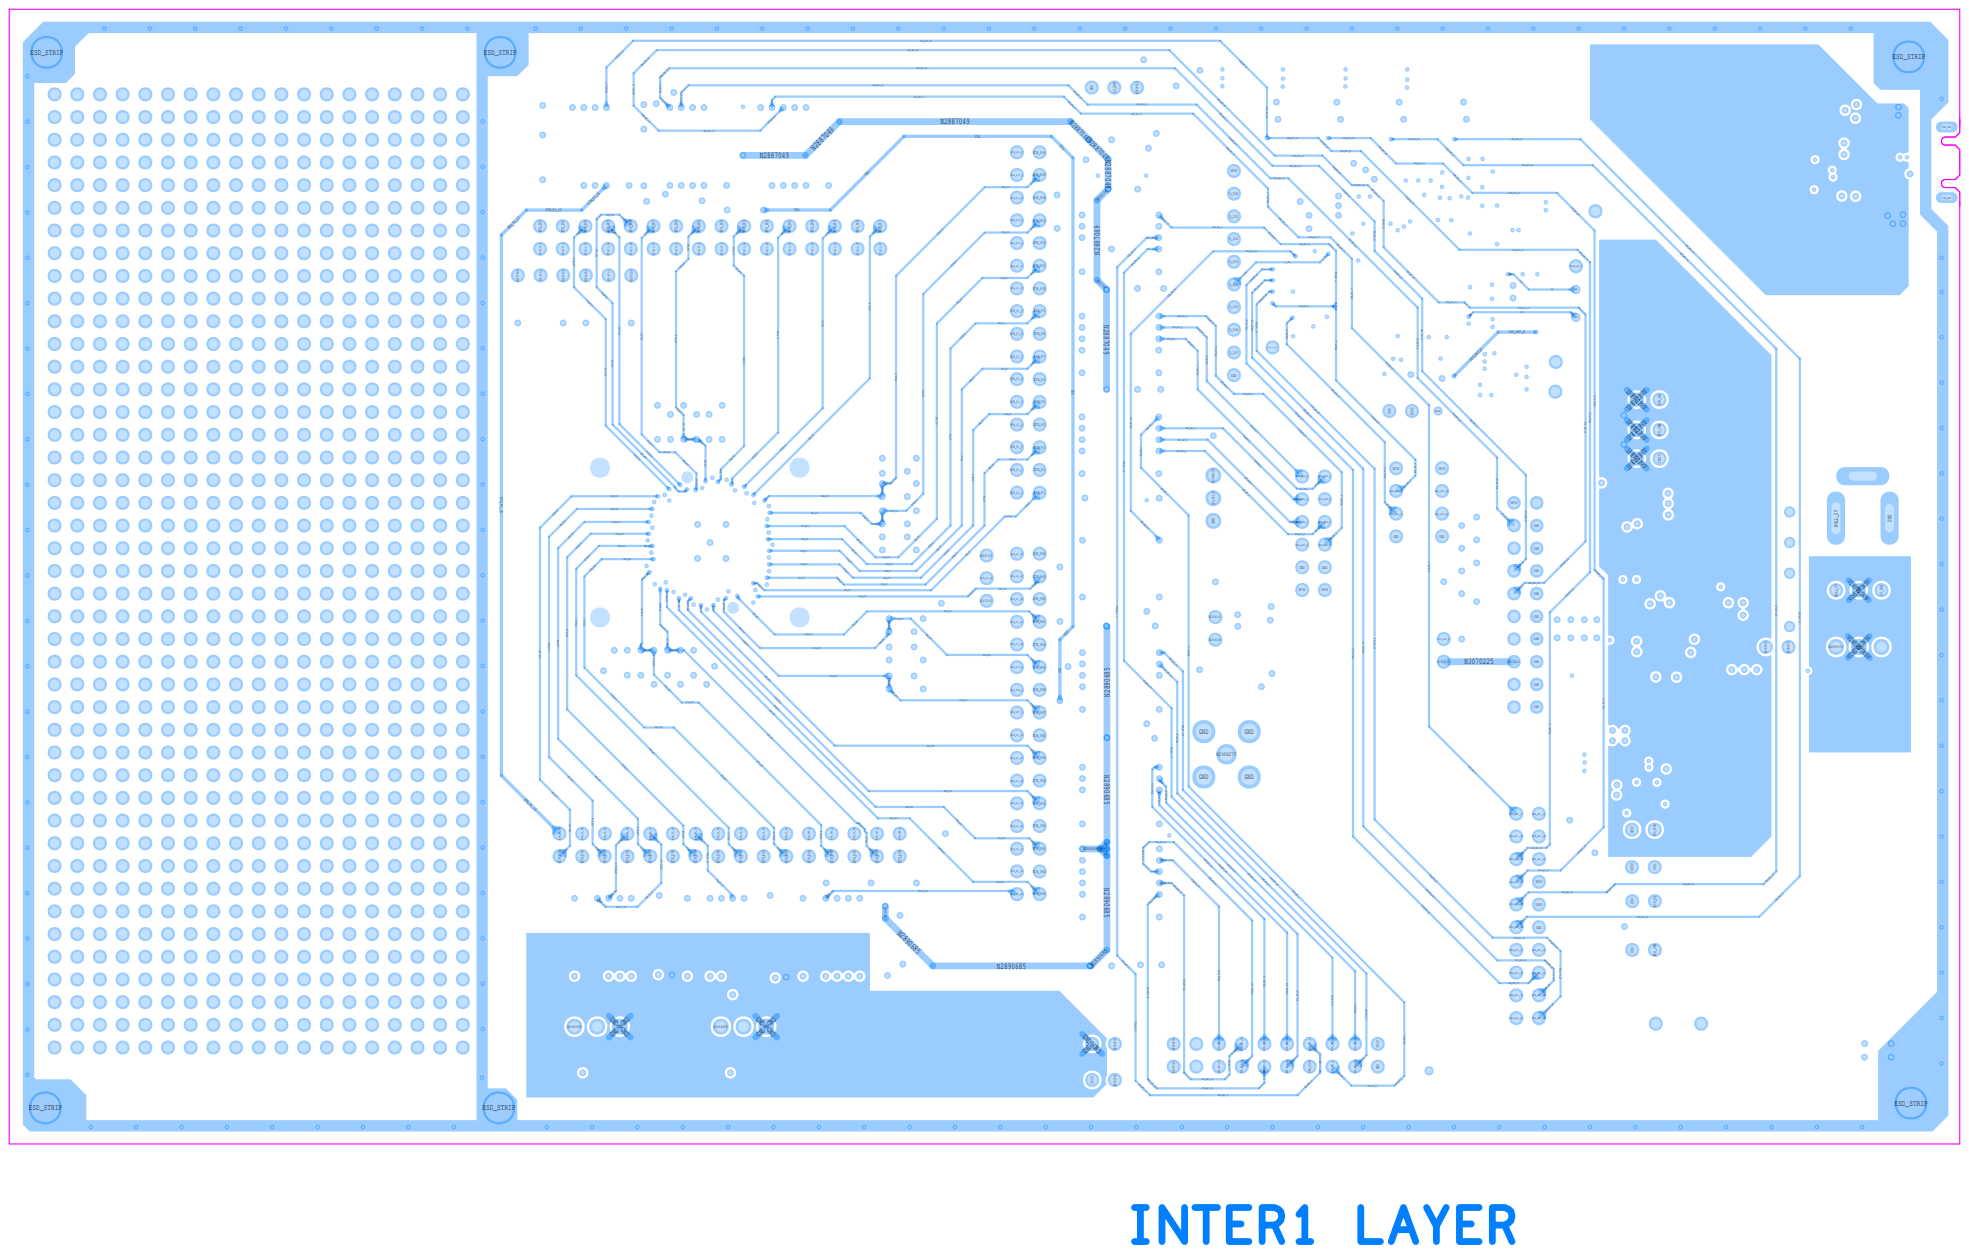
[picture p19: page 12]
VIN5V VIN5V VIN5VVIN5V VIN5V VIN5V; ETH_HP1_36; VLP; TDO; TDO SYS_RST_N; SYS_RST_N; ETH_HP1_35; ETH_HP1_34; ETH_HP1_34 ETH_HP1_34 ETH_HP1_34; ETH_HP1_9; ETH_HP1_9 ETH_HP1_9 ETH_HP1_9; ETH_HP1_9 ETH_HP1_9; ETH_HP1_33; ETH_HP1_33 ETH_HP1_33; ETH_HP1_10 ETH_HP1_10; ETH_HP1_10; ETH_HP1_29; ETH_HP1_29 ETH_HP1_29 ETH_HP1_29 ETH_HP1_28; ETH_HP1_28; ETH_HP1_28 ETH_HP1_28; ETH_HP1_27; ETH_HP1_7; ETH_HP1_7 ETH_HP1_7; ETH_HP1_6; ETH_HP1_5; ETH_HP1_2; ETH_HP1_2 ETH_HP1_2; ETH_HP1_3; ETH_HP1_3 ETH_HP1_3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

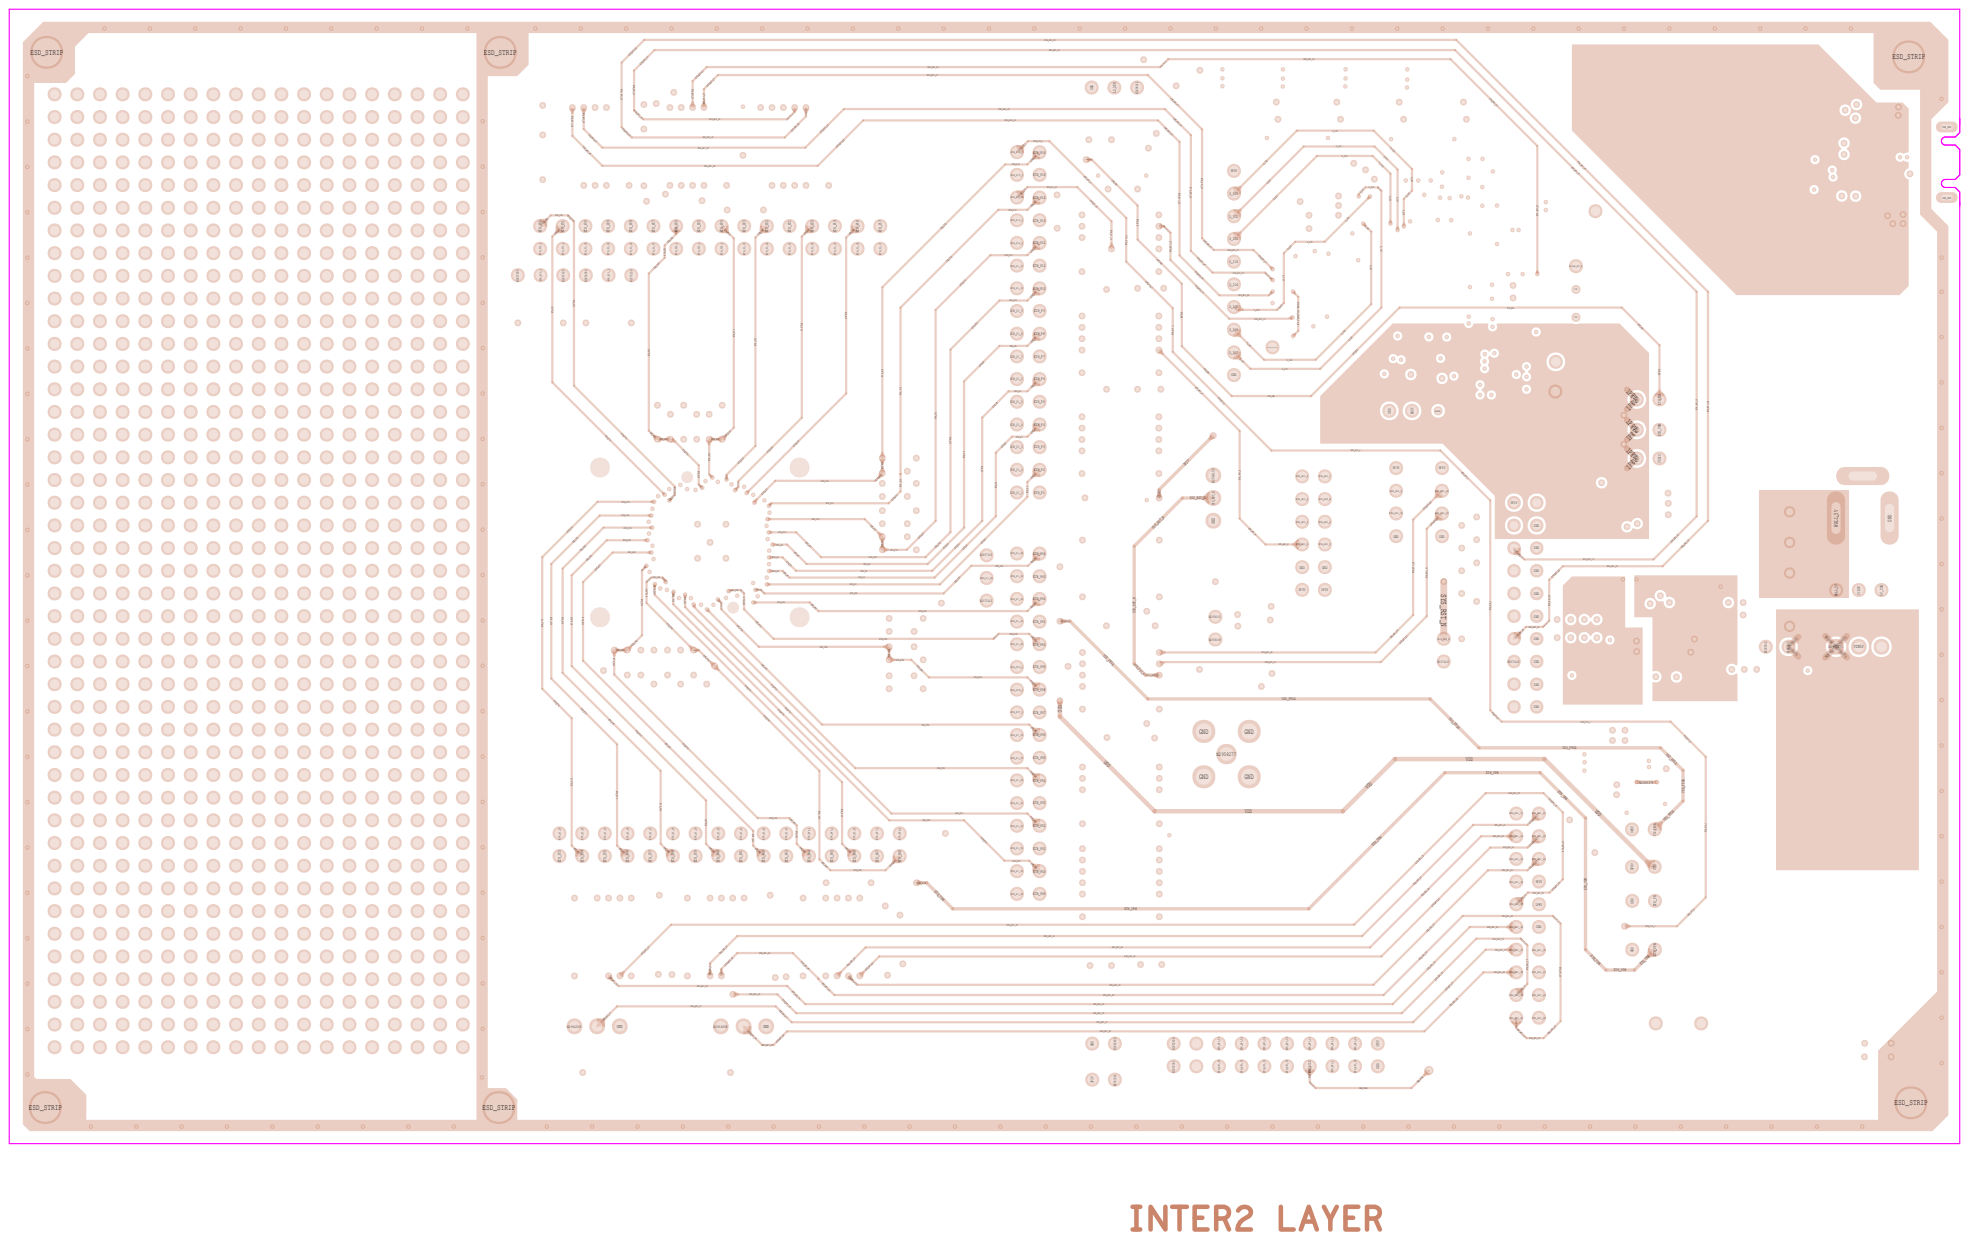
[picture p20: page 13]
SYS_RST_N; CAM_XCLK; CAM_XCLK CAM_XCLK; DIOLAN_SPI_SLAVE_SS_N; ETH_HP1_10; ETH_HP1_10 ETH_HP1_10; ETH_HP1_8; ETH_HP1_60; ETH_HP1_61; SYS_RST_N SYS_RST_N SYS_RST_N; ETH_NB; VDD_FPGA; VDD; ETH_P16_1; ETH_P16_1 ETH_P16_1; ETH_P1_14; ETH_VPW; ETH_P16; ETH_P16 ETH_P16; ETH_P12; ETH_P58; ETH_HP1_42; ETH_HP1_46; ETH_HP1_43; ETH_P14; ETH_P14 ETH_P14; ETH_P10; ETH_P10 ETH_P8; ETH_P8; ETH_P6; ETH_P6 ETH_P4; ETH_P4; ETH_P2; ETH_HP1_27; ETH_P24; ETH_P24 ETH_P24; ETH_P22; ETH_P20 ETH_P20; ETH_P20; ETH_P18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

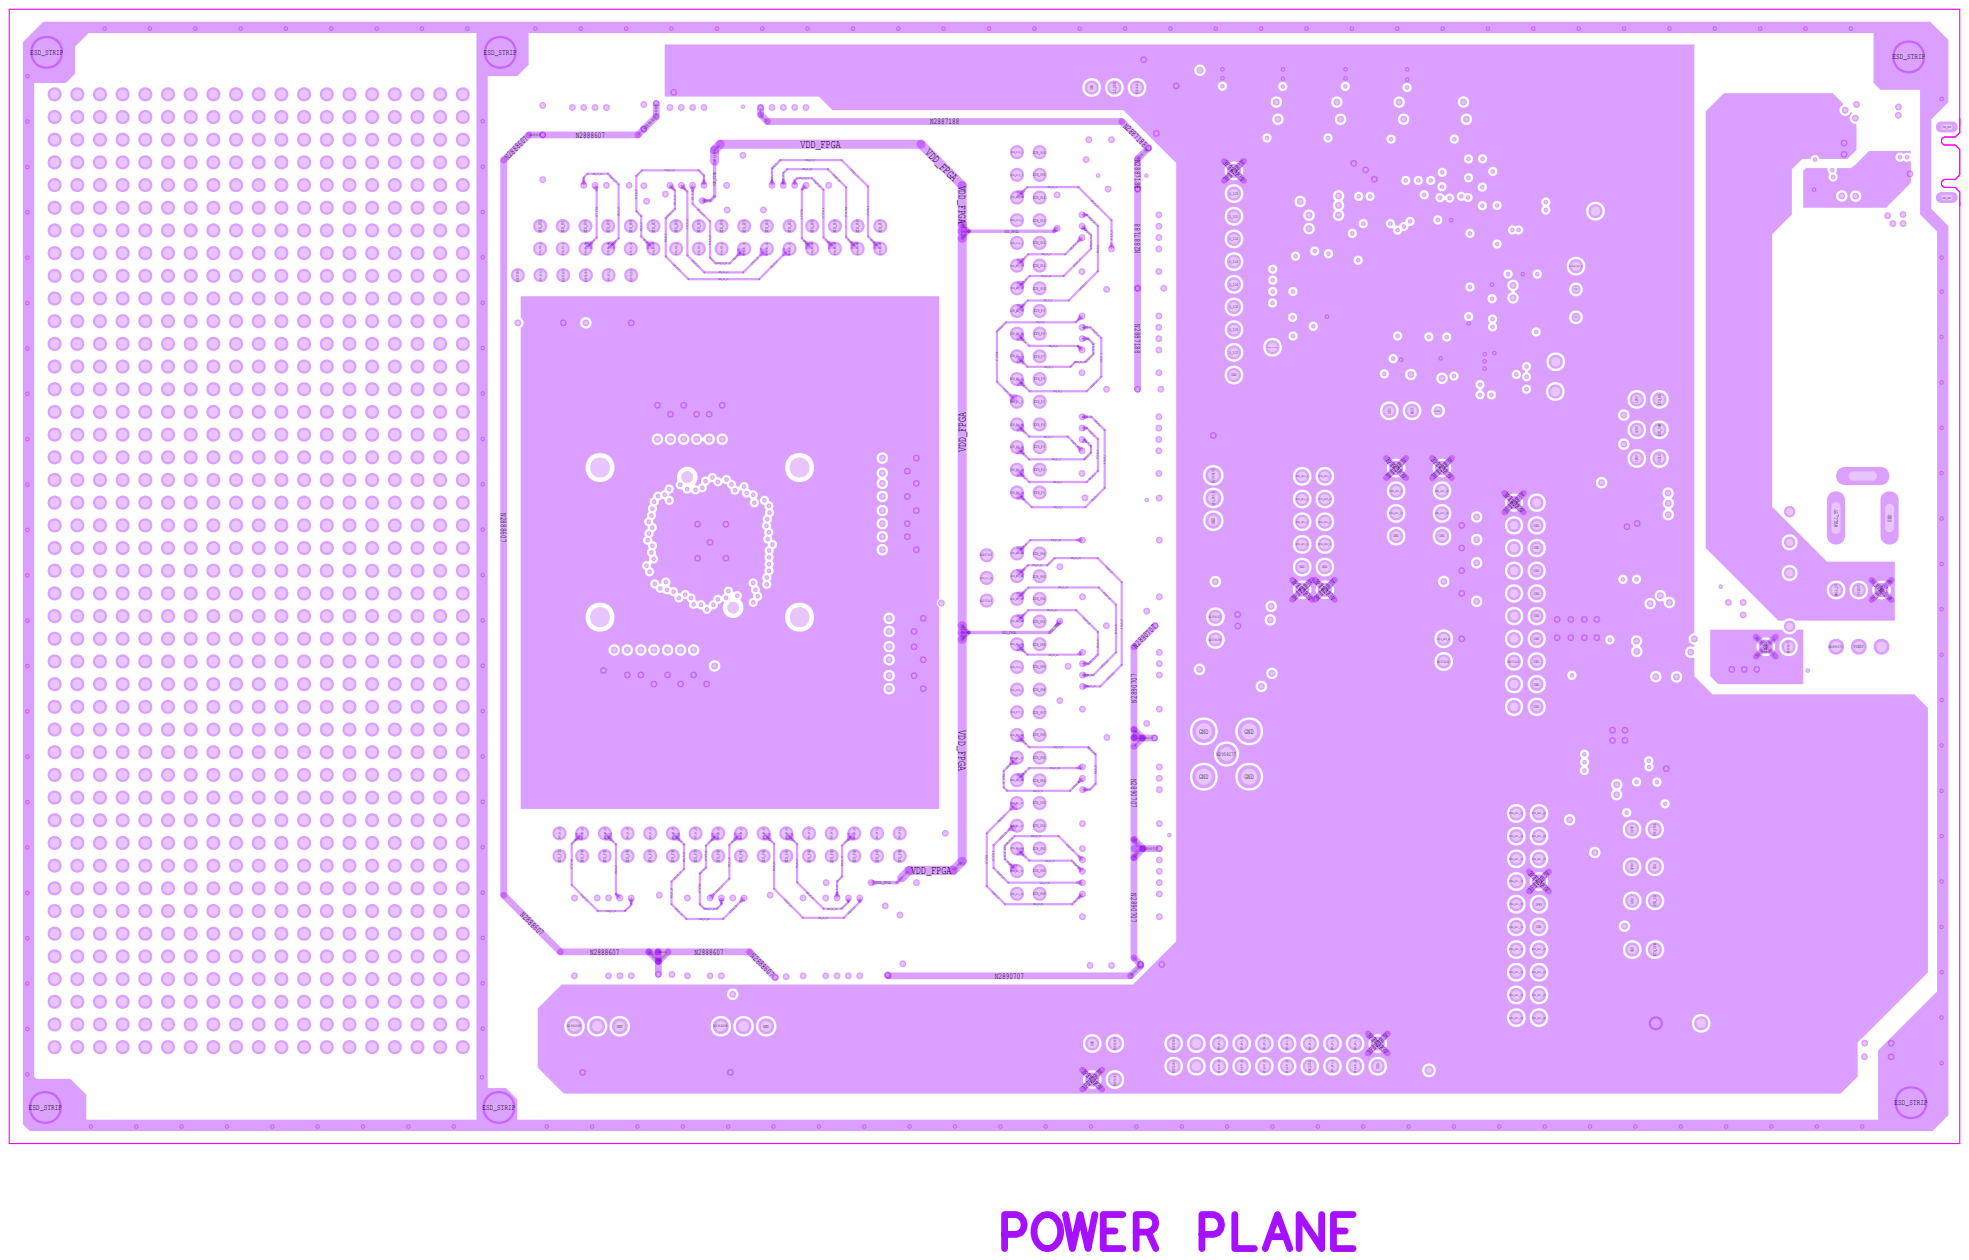
[picture p21: page 14]
5V_USB5V_USB; ETH_P1_14; VDD_FPGA; VDD_FPGA ETH_P1_11; ETH_P1_11; ETH_P1_10 ETH_P1_10; ETH_P1_10; ETH_P1_9; ETH_P1_9 ETH_P1_8; ETH_P1_8; ETH_P1_7; ETH_P1_7 ETH_P1_7; ETH_P1_6; ETH_P1_5; ETH_P1_5 ETH_P1_5; ETH_P1_4; ETH_P1_3; ETH_P1_3 ETH_P1_3; ETH_P1_2; ETH_P1_2 ETH_P1_2; ETH_P1_1; ETH_P1_1 ETH_P1_64; ETH_P1_64 VDD_FPGA; ETH_P1_63 ETH_P1_63; ETH_P1_63; ETH_P1_62; ETH_P1_61; ETH_P1_61 ETH_P1_61; ETH_P1_60; ETH_P1_56; ETH_P1_56 ETH_P1_56 ETH_P1_56; ETH_P1_55; ETH_P1_55 ETH_P1_55 ETH_P1_55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

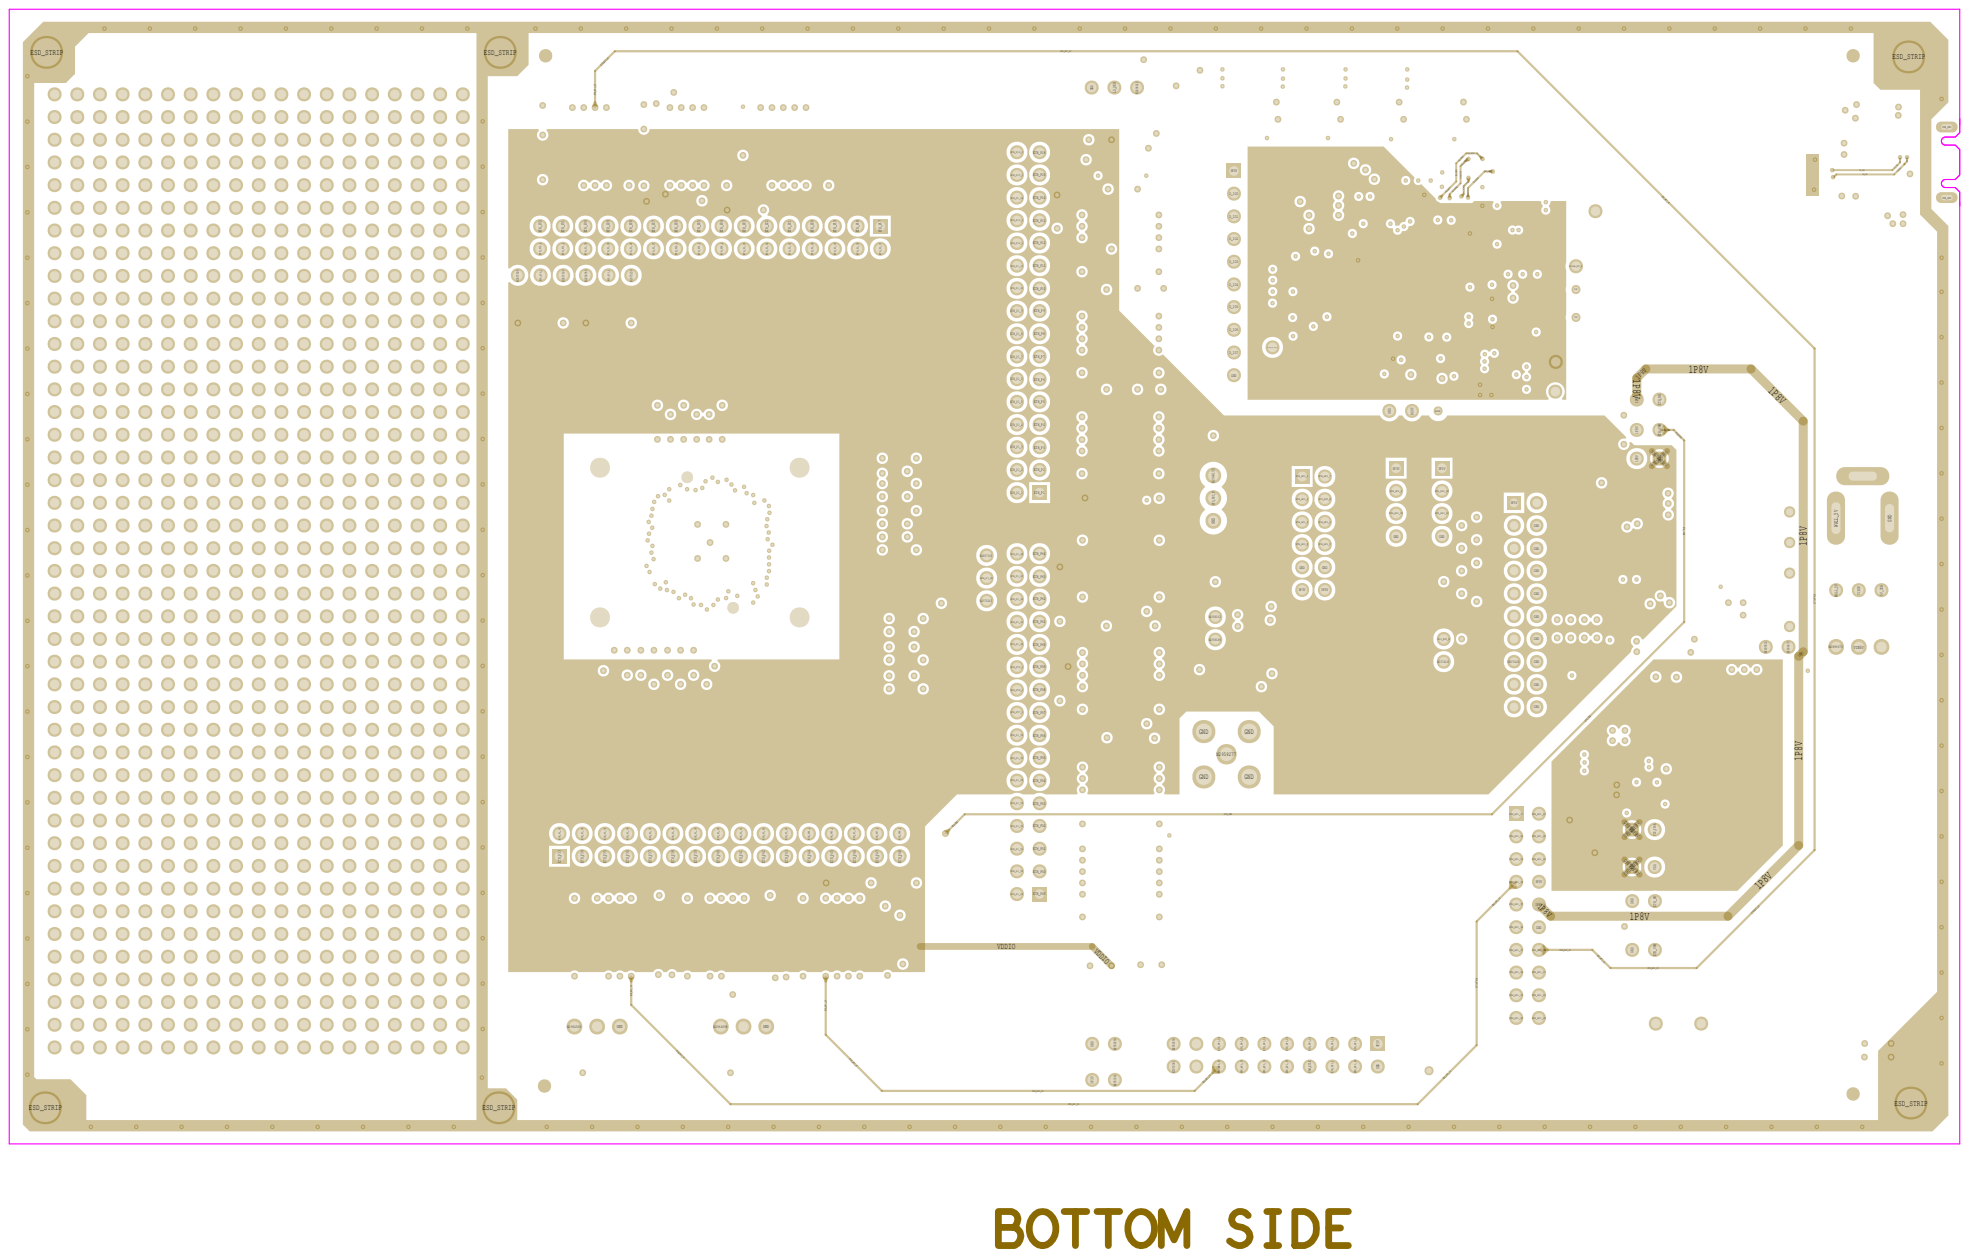
[picture p22: page 15]
DN_CON; DP_CON; VDDIOVDDIO; USB_DHSDM USB_DHSDM USB_DHSDM; USB_DHSDM USB_DHSDP USB_DHSDP USB_DHSDP USB_DFSDM USB_DFSDM; USB_DFSDM; USB_DFSDP; ETH_VNW; VDDIO; ETH_HP1_49; ETH_HP1_34; ETH_HP1_30; USB_GND; ESD_STRIP; GND; 5V_USB; WALL_5V; VIN5V; ETH_NB VDDIO ETH_VNW; VDD_FPGA; VDD ETH_VPW; ETH_PB; DIOLAN_RST_N; VLP; TDO; ETH_HP1_41; ETH_HP1_42; ETH_HP1_43; ETH_HP1_28; ETH_HP1_29; ETH_HP1_27; ETH_HP1_17; ETH_HP1_46; ETH_HP1_33; ETH_HP1_35; ETH_HP1_36; ETH_HP1_37; ETH_HP1_38; ETH_HP1_39; ETH_HP1_40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

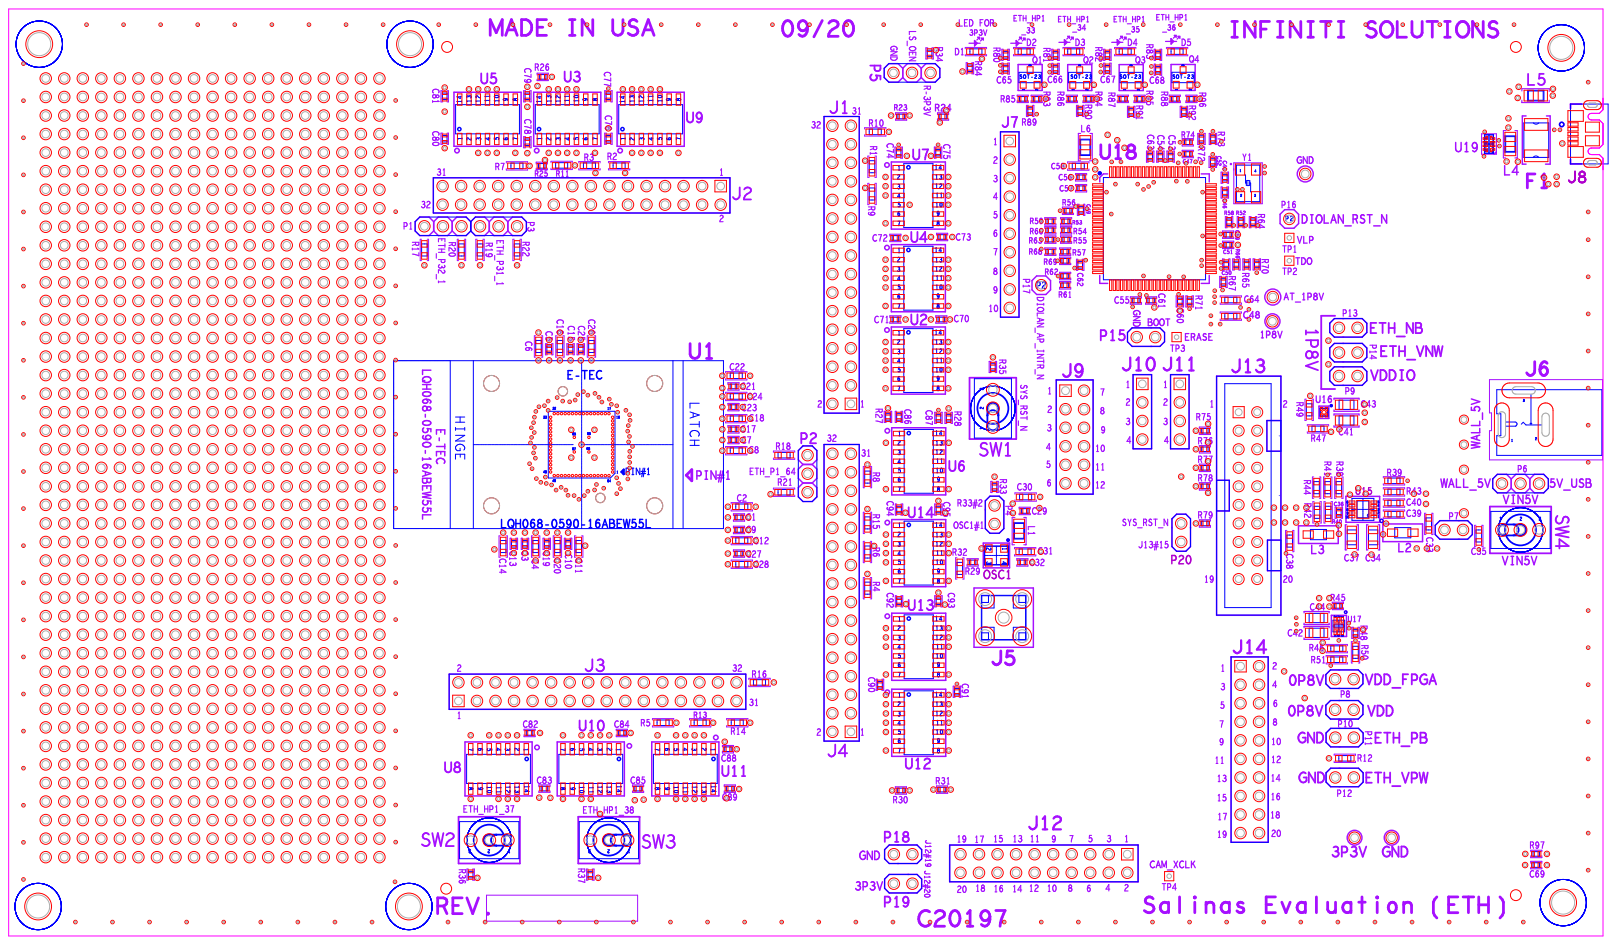
[picture p23: page 16]

PASSED | BY
REVISED | BY

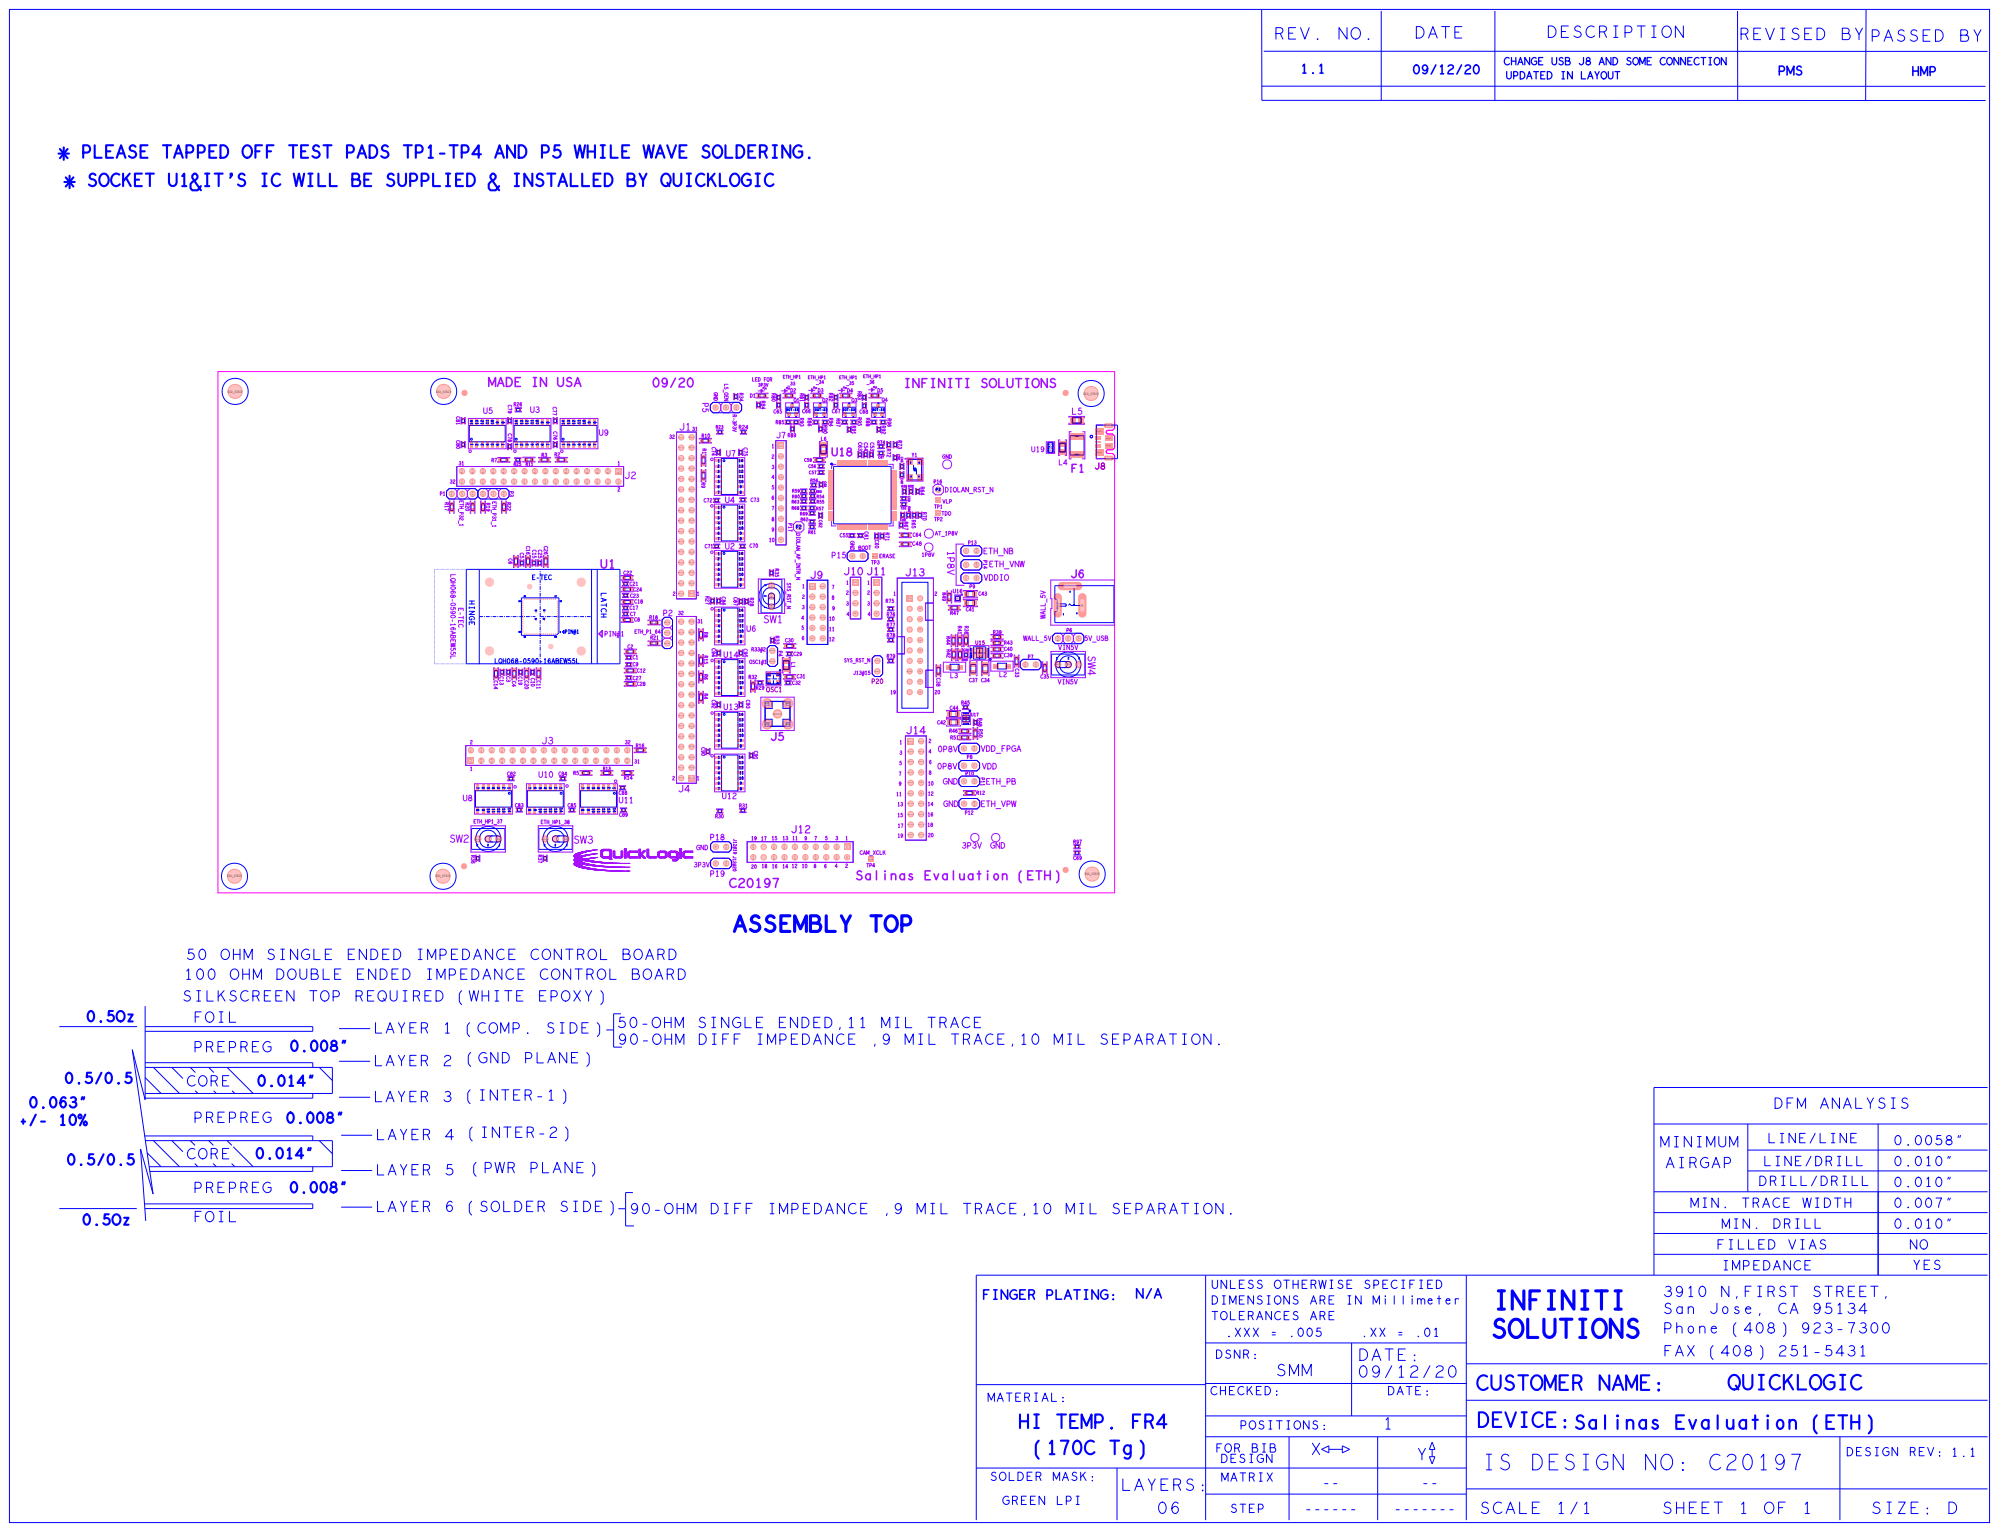
[picture p24: page 17]

CHANGE USB J8 AND SOME CONNECTION

* PLEASE TAPPED OFF TEST PADS TP1-TP4 AND P5 WHILE WAVE SOLDERING.

* SOCKET U1&IT'S IC WILL BE SUPPLIED & INSTALLED BY QUICKLOGIC

DSNR: SMM | 09/12/20

MATERIAL: | | (170C Tg) | CHECKED: | DATE:

POSITIONS:

MATRIX | -- | --
