anthonyle-ql/Salinas/docs/c19054_salinasV1.1.pdf

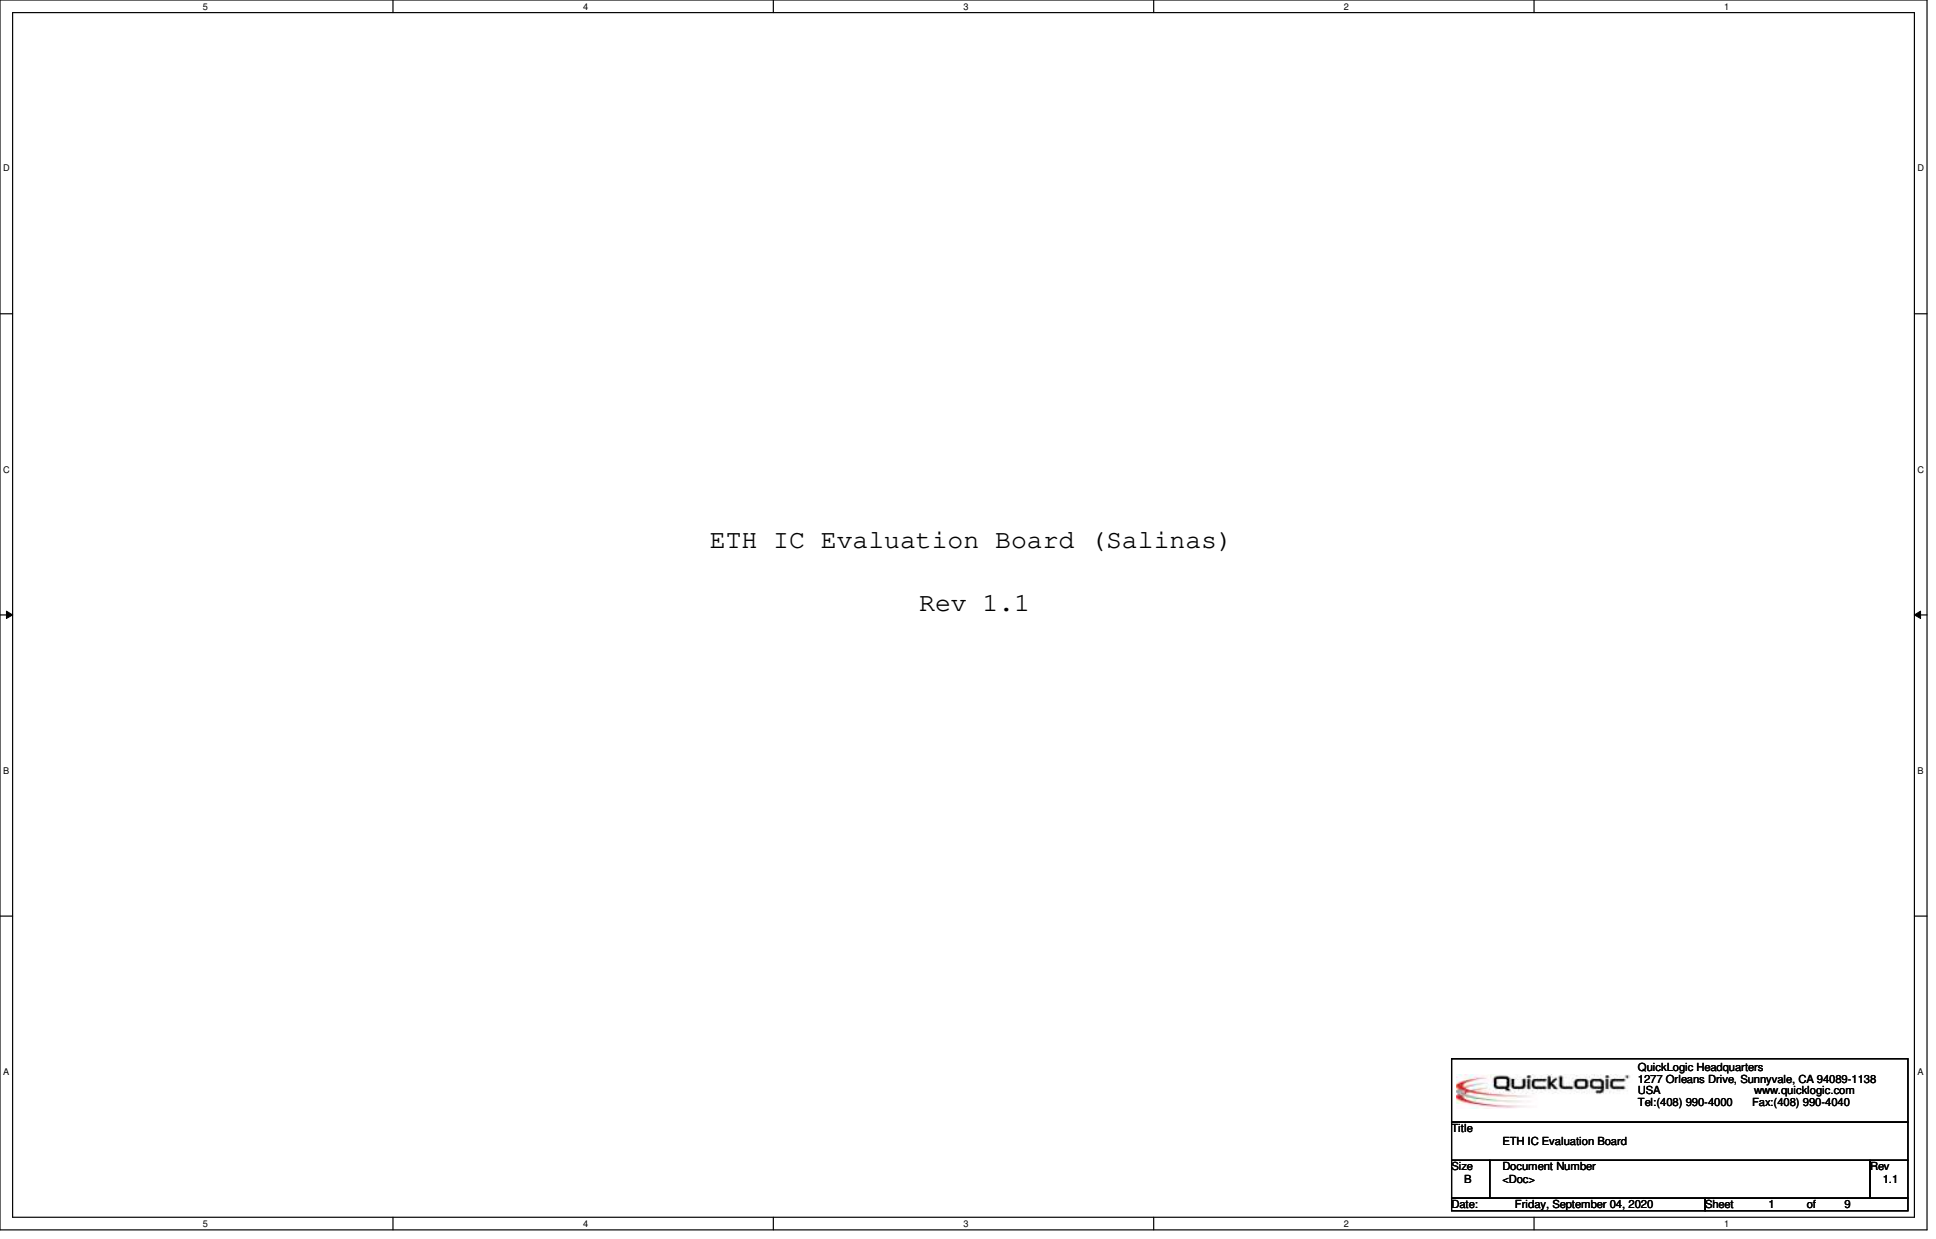
[picture p25: page 1]
Rev 1.1; Title; Size; Document Number; Rev; Date:; Sheet; USA; www.quicklogic.com; Tel:(408) 990-4000; Fax:(408) 990-4040; <Doc>; Friday, September 04, 2020

ETH IC Evaluation Board (Salinas)

QuickLogic Headquarters
1277 Orleans Drive, Sunnyvale, CA 94089-1138

ETH IC Evaluation Board

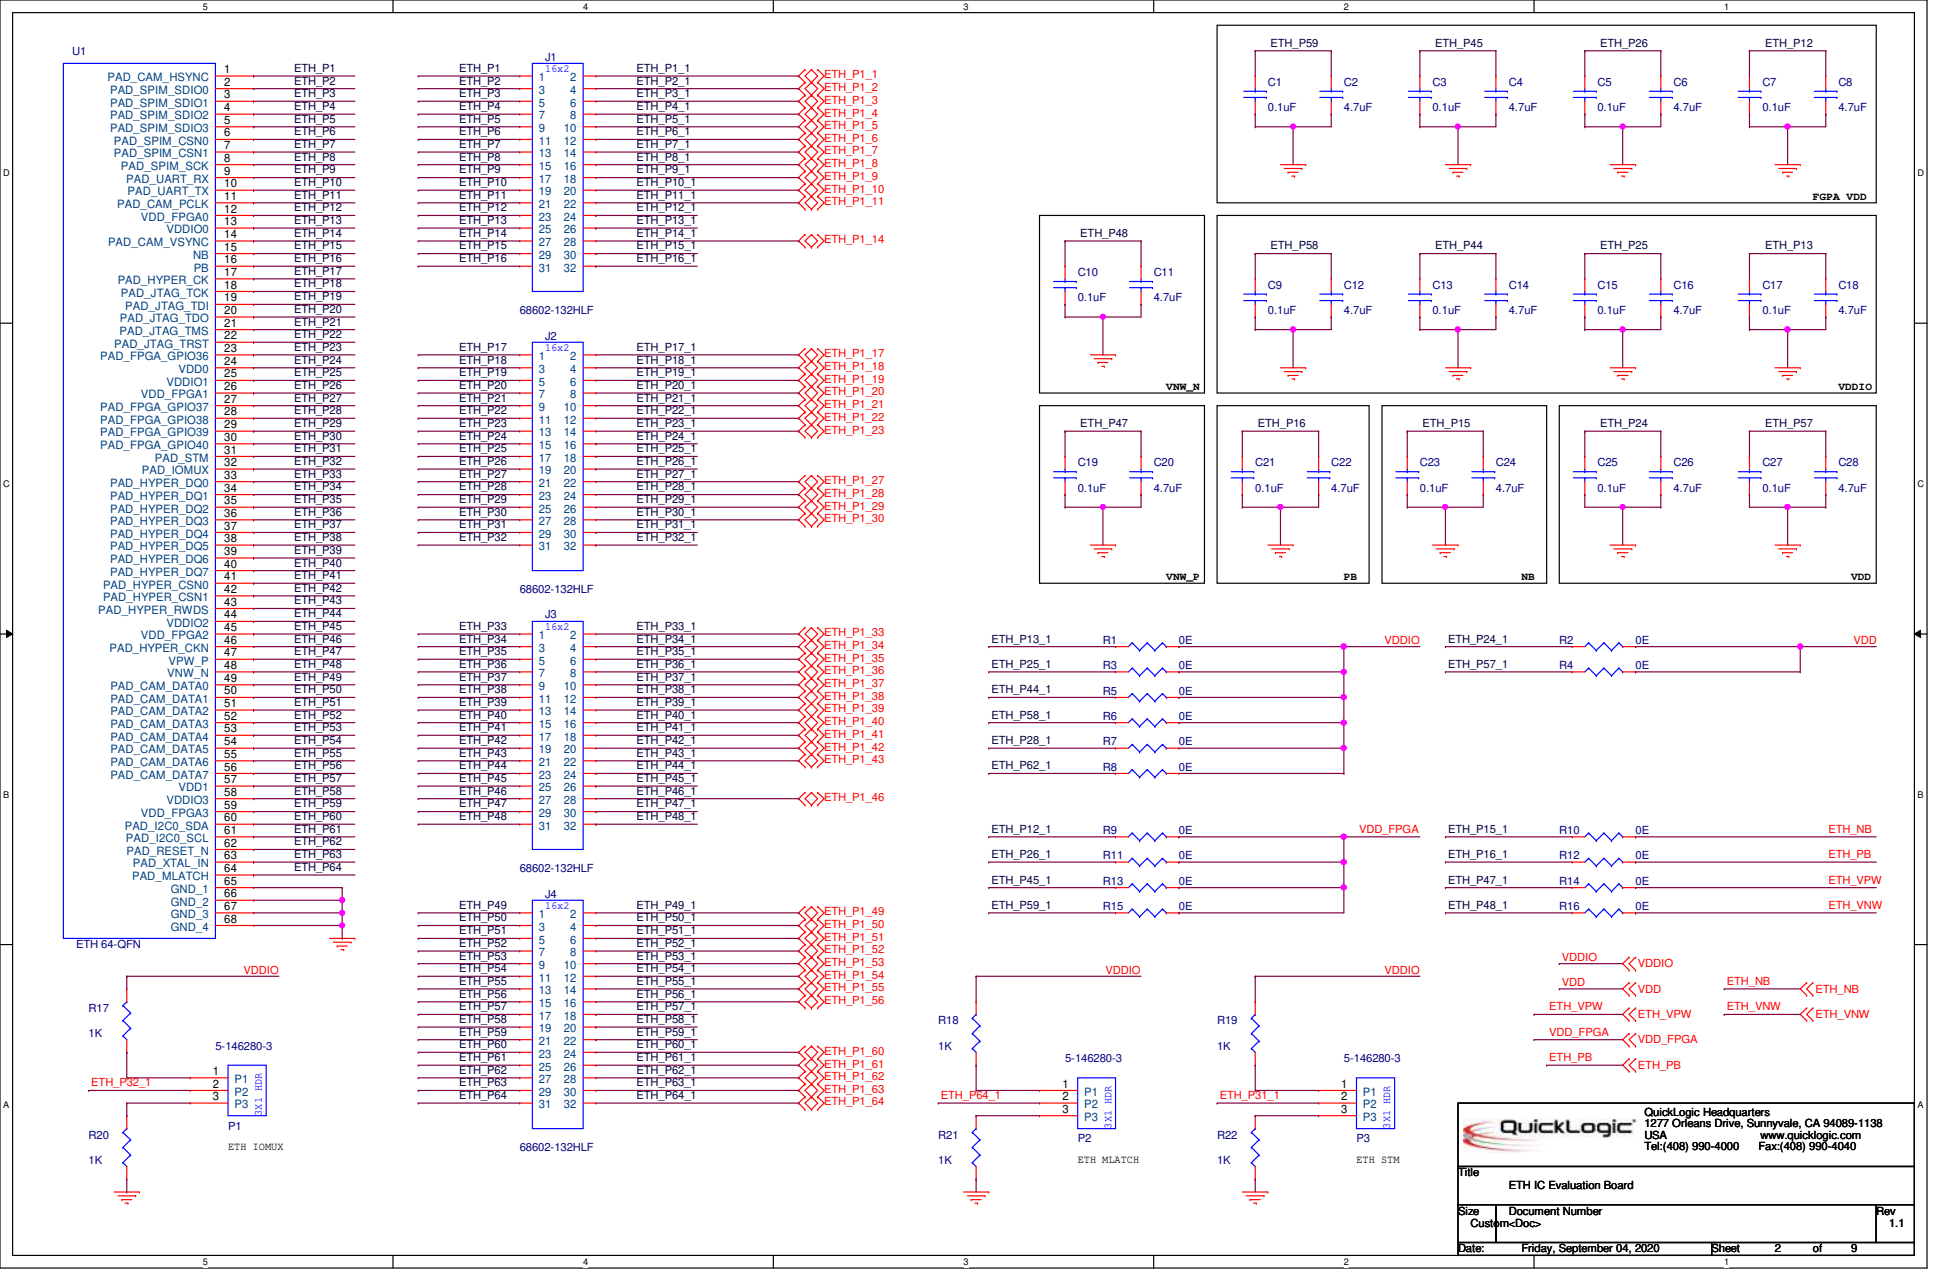
[picture p26: page 2]

QuickLogic Headquarters
1277 Orleans Drive, Sunnyvale, CA 94089-1138

ETH IC Evaluation Board

3P3V | 3P3V | LEVEL SHIFTERS

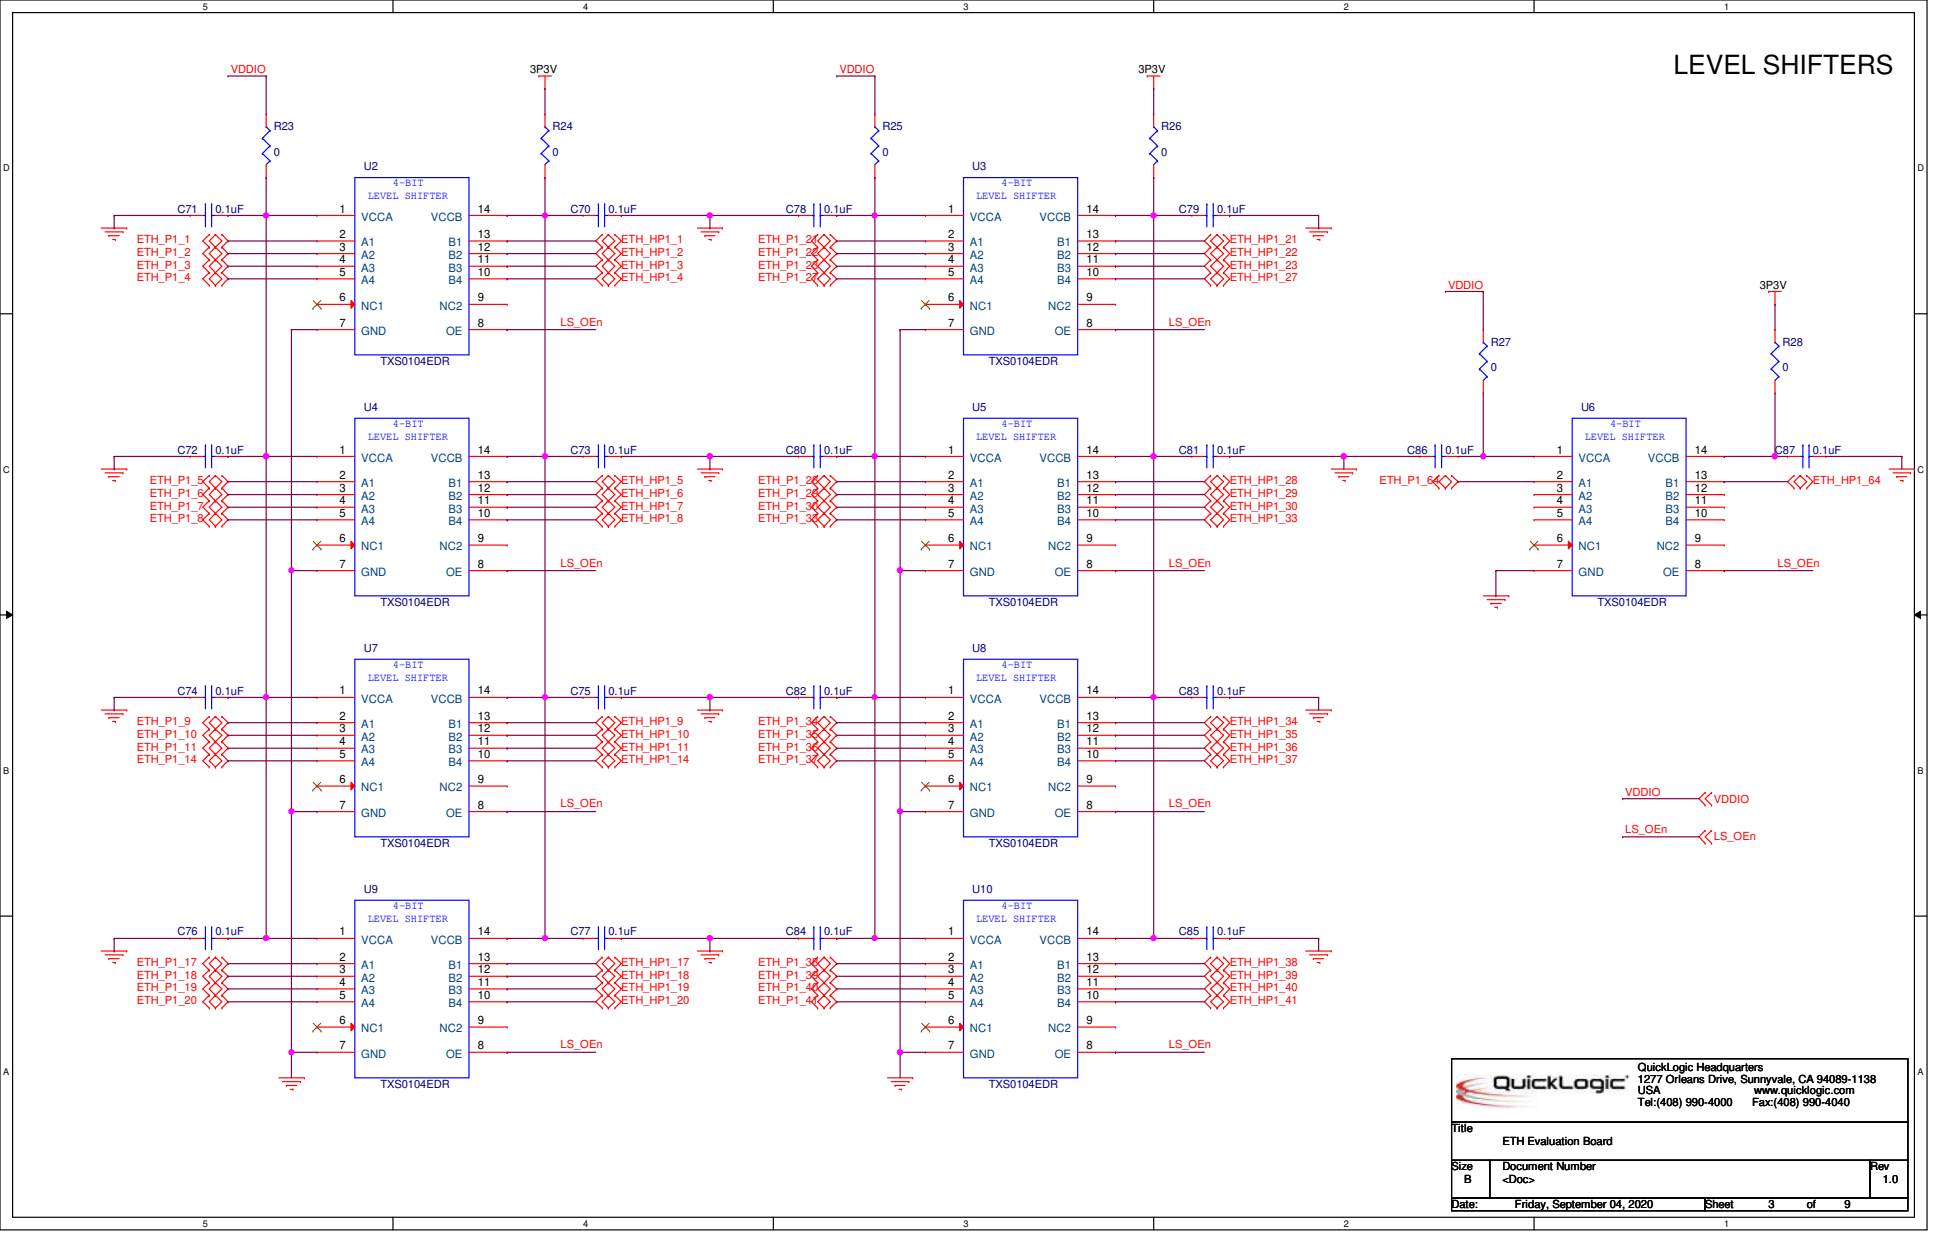
[picture p27: page 3]

QuickLogic Headquarters
1277 Orleans Drive, Sunnyvale, CA 94089-1138

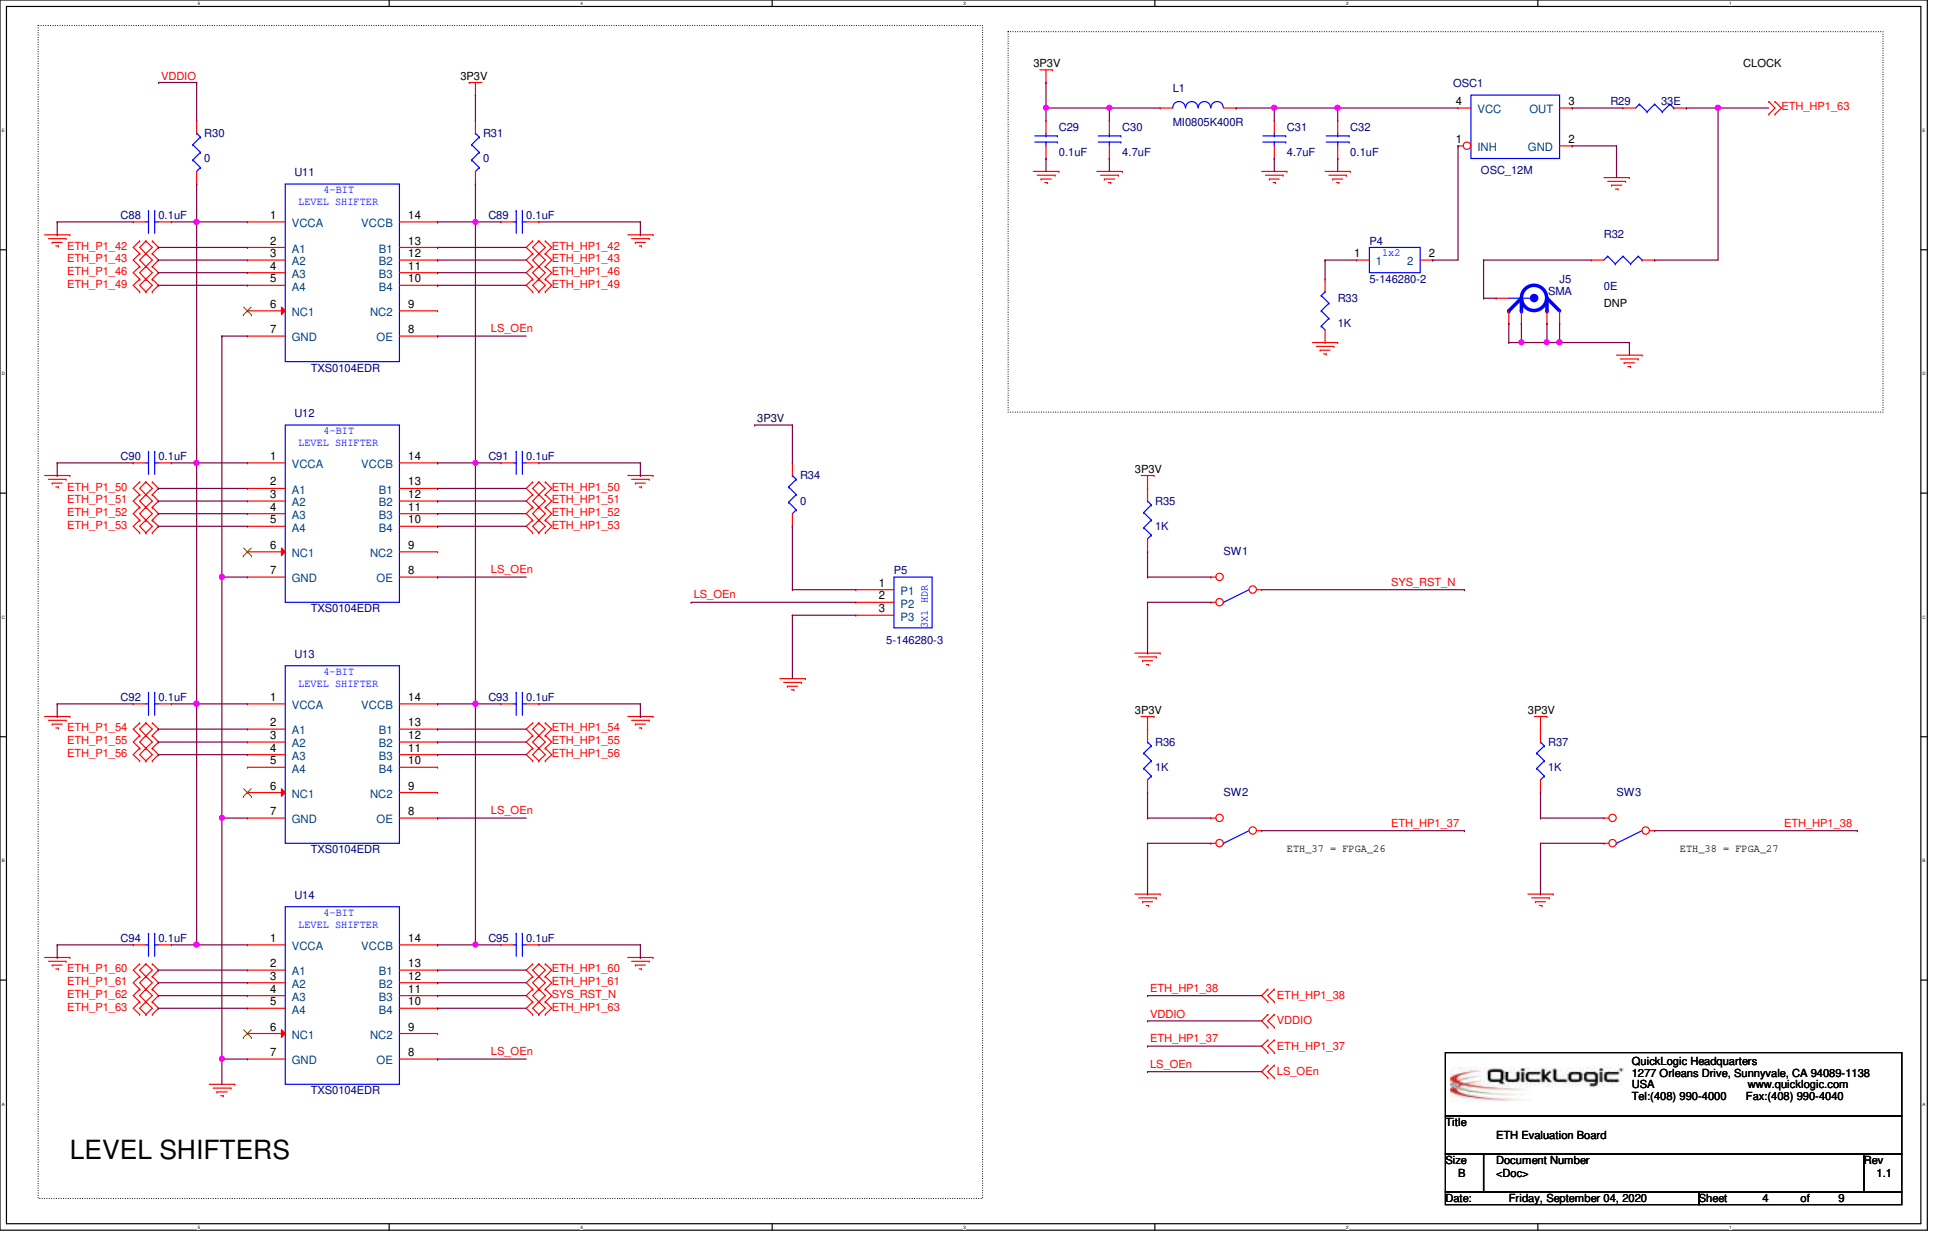
[picture p28: page 4]

QuickLogic Headquarters
1277 Orleans Drive, Sunnyvale, CA 94089-1138

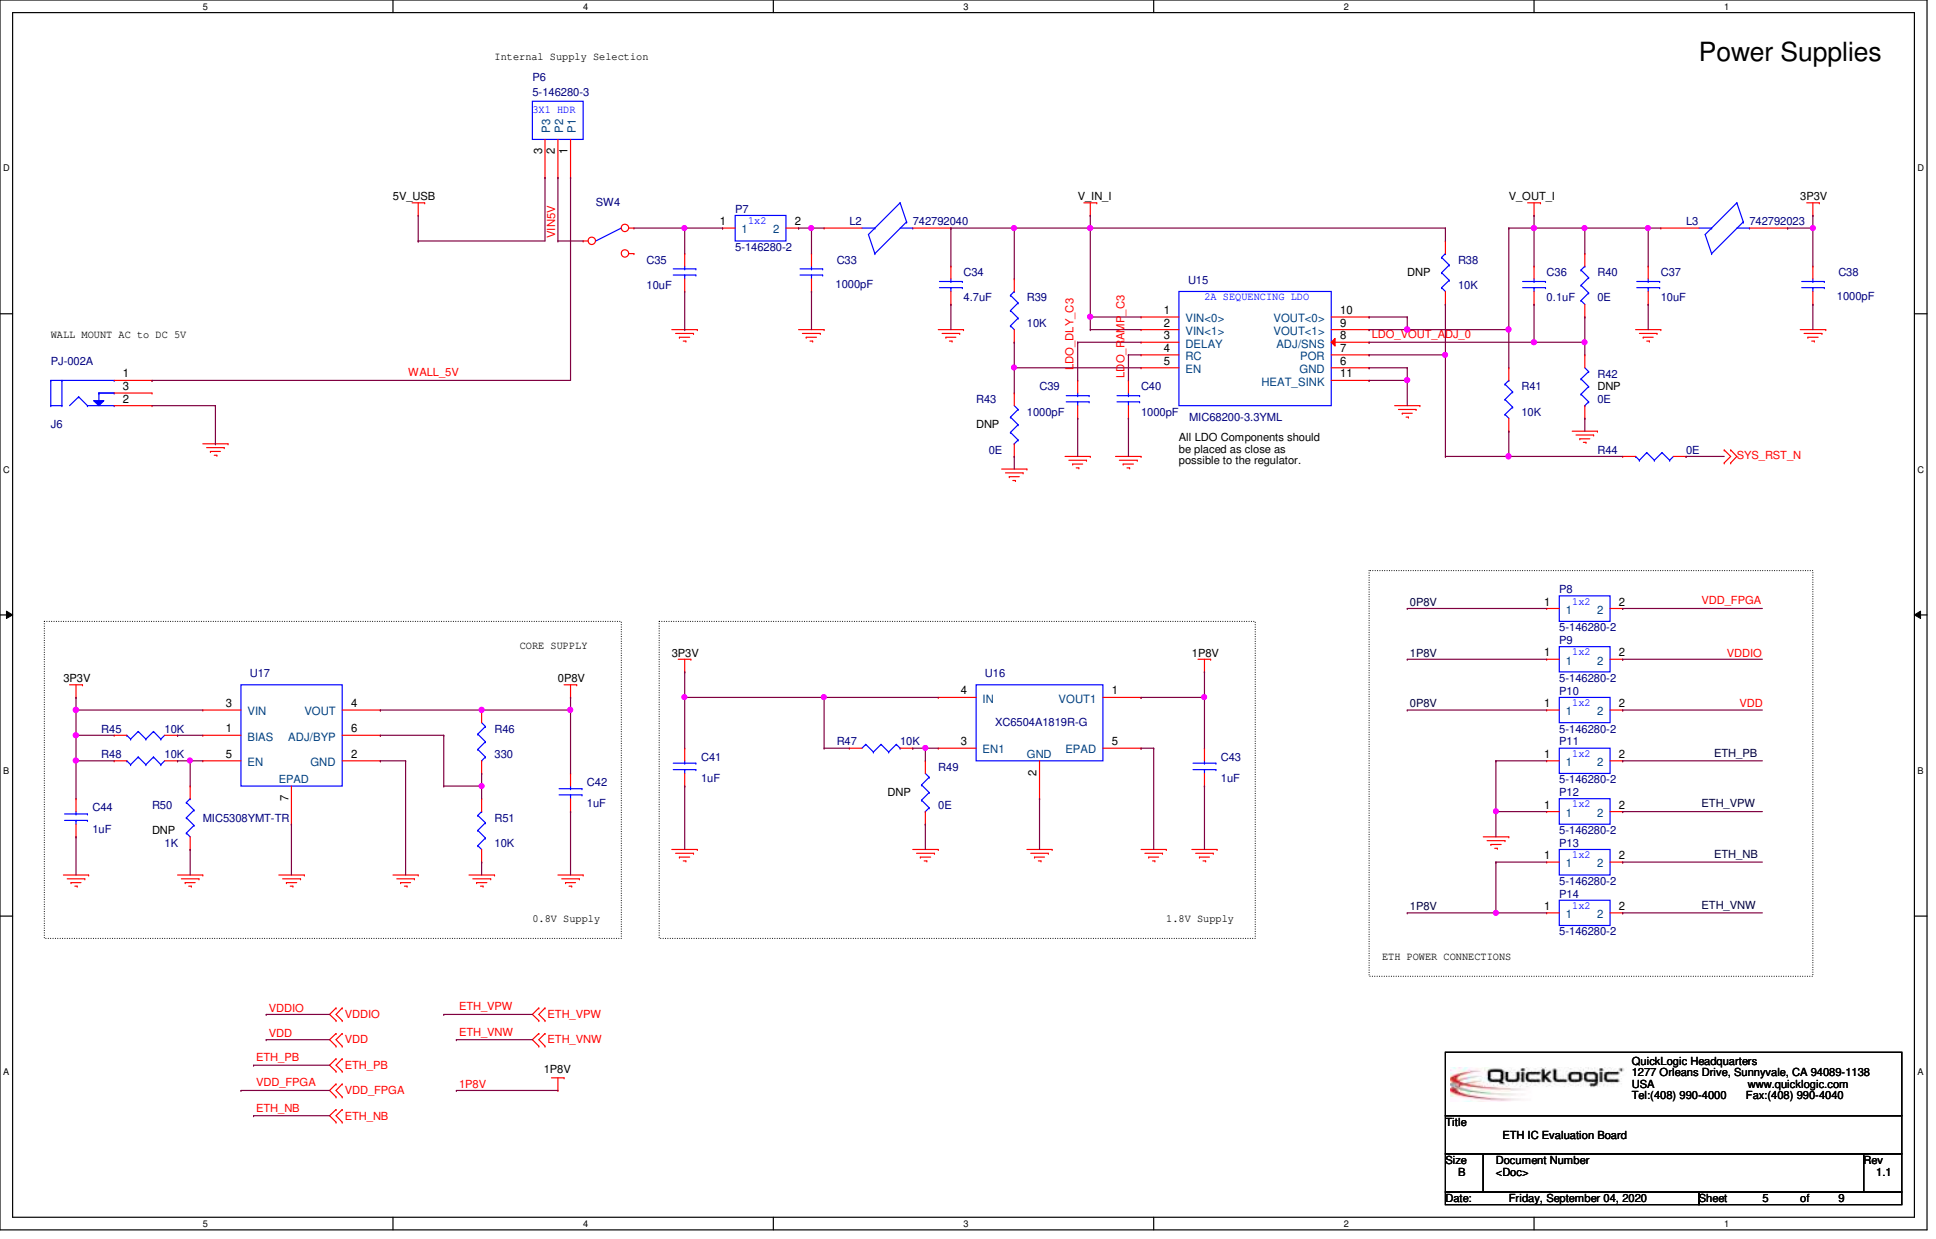
[picture p29: page 5]

WALL MOUNT AC to DC 5V

MIC68200-3.3YML
All LDO Components should
be placed as close as
possible to the regulator.

QuickLogic Headquarters
1277 Orleans Drive, Sunnyvale, CA 94089-1138

ETH IC Evaluation Board

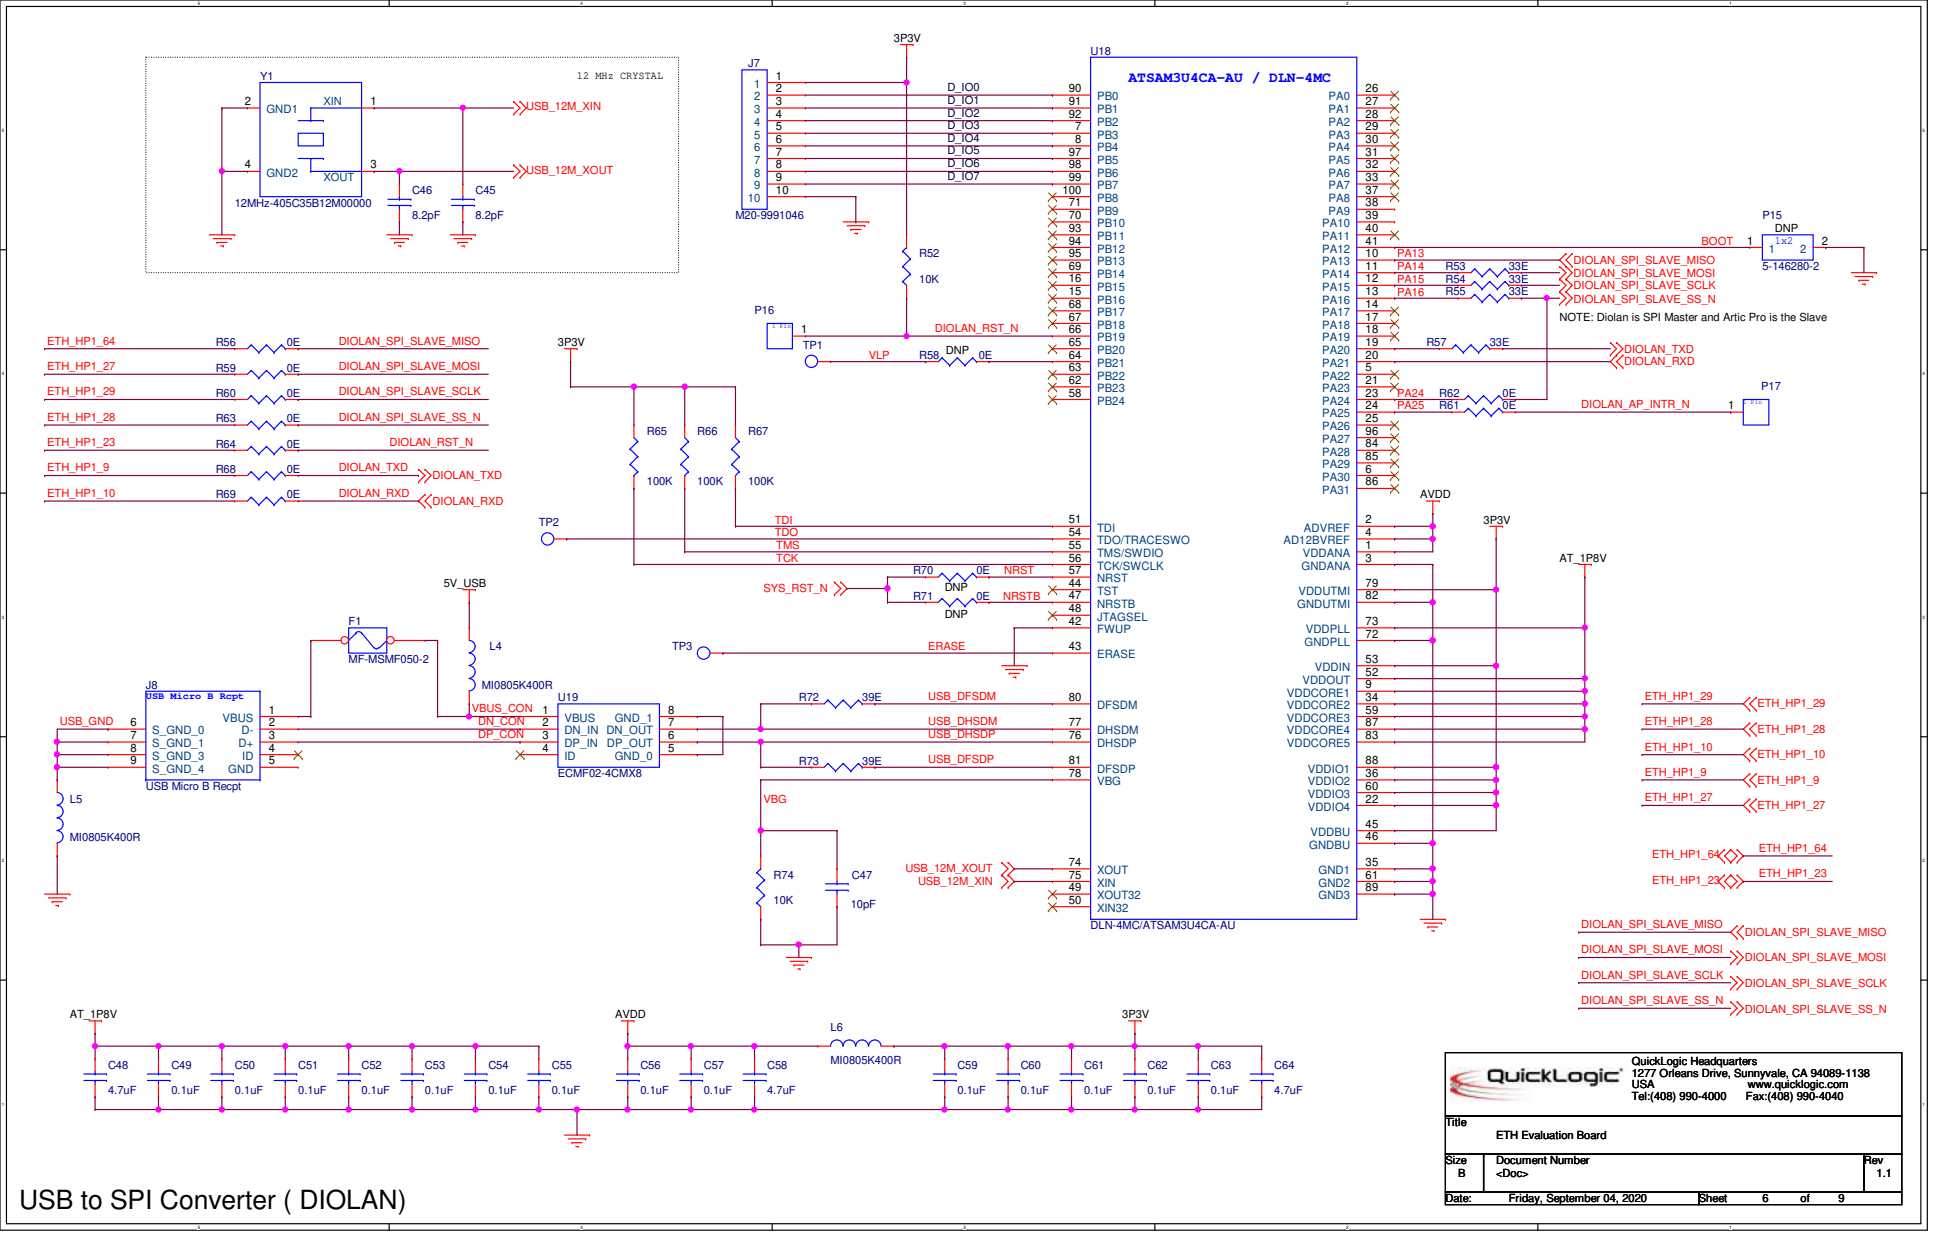
[picture p30: page 6]

DIOLAN_SPI_SLAVE_MISO
DIOLAN_SPI_SLAVE_MOSI
DIOLAN_SPI_SLAVE_SCLK
DIOLAN_SPI_SLAVE_SS_N
NOTE: Diolan is SPI Master and Artic Pro is the Slave

QuickLogic Headquarters
1277 Orleans Drive, Sunnyvale, CA 94089-1138

USB to SPI Converter ( DIOLAN)

# EXPANSION HEADERS

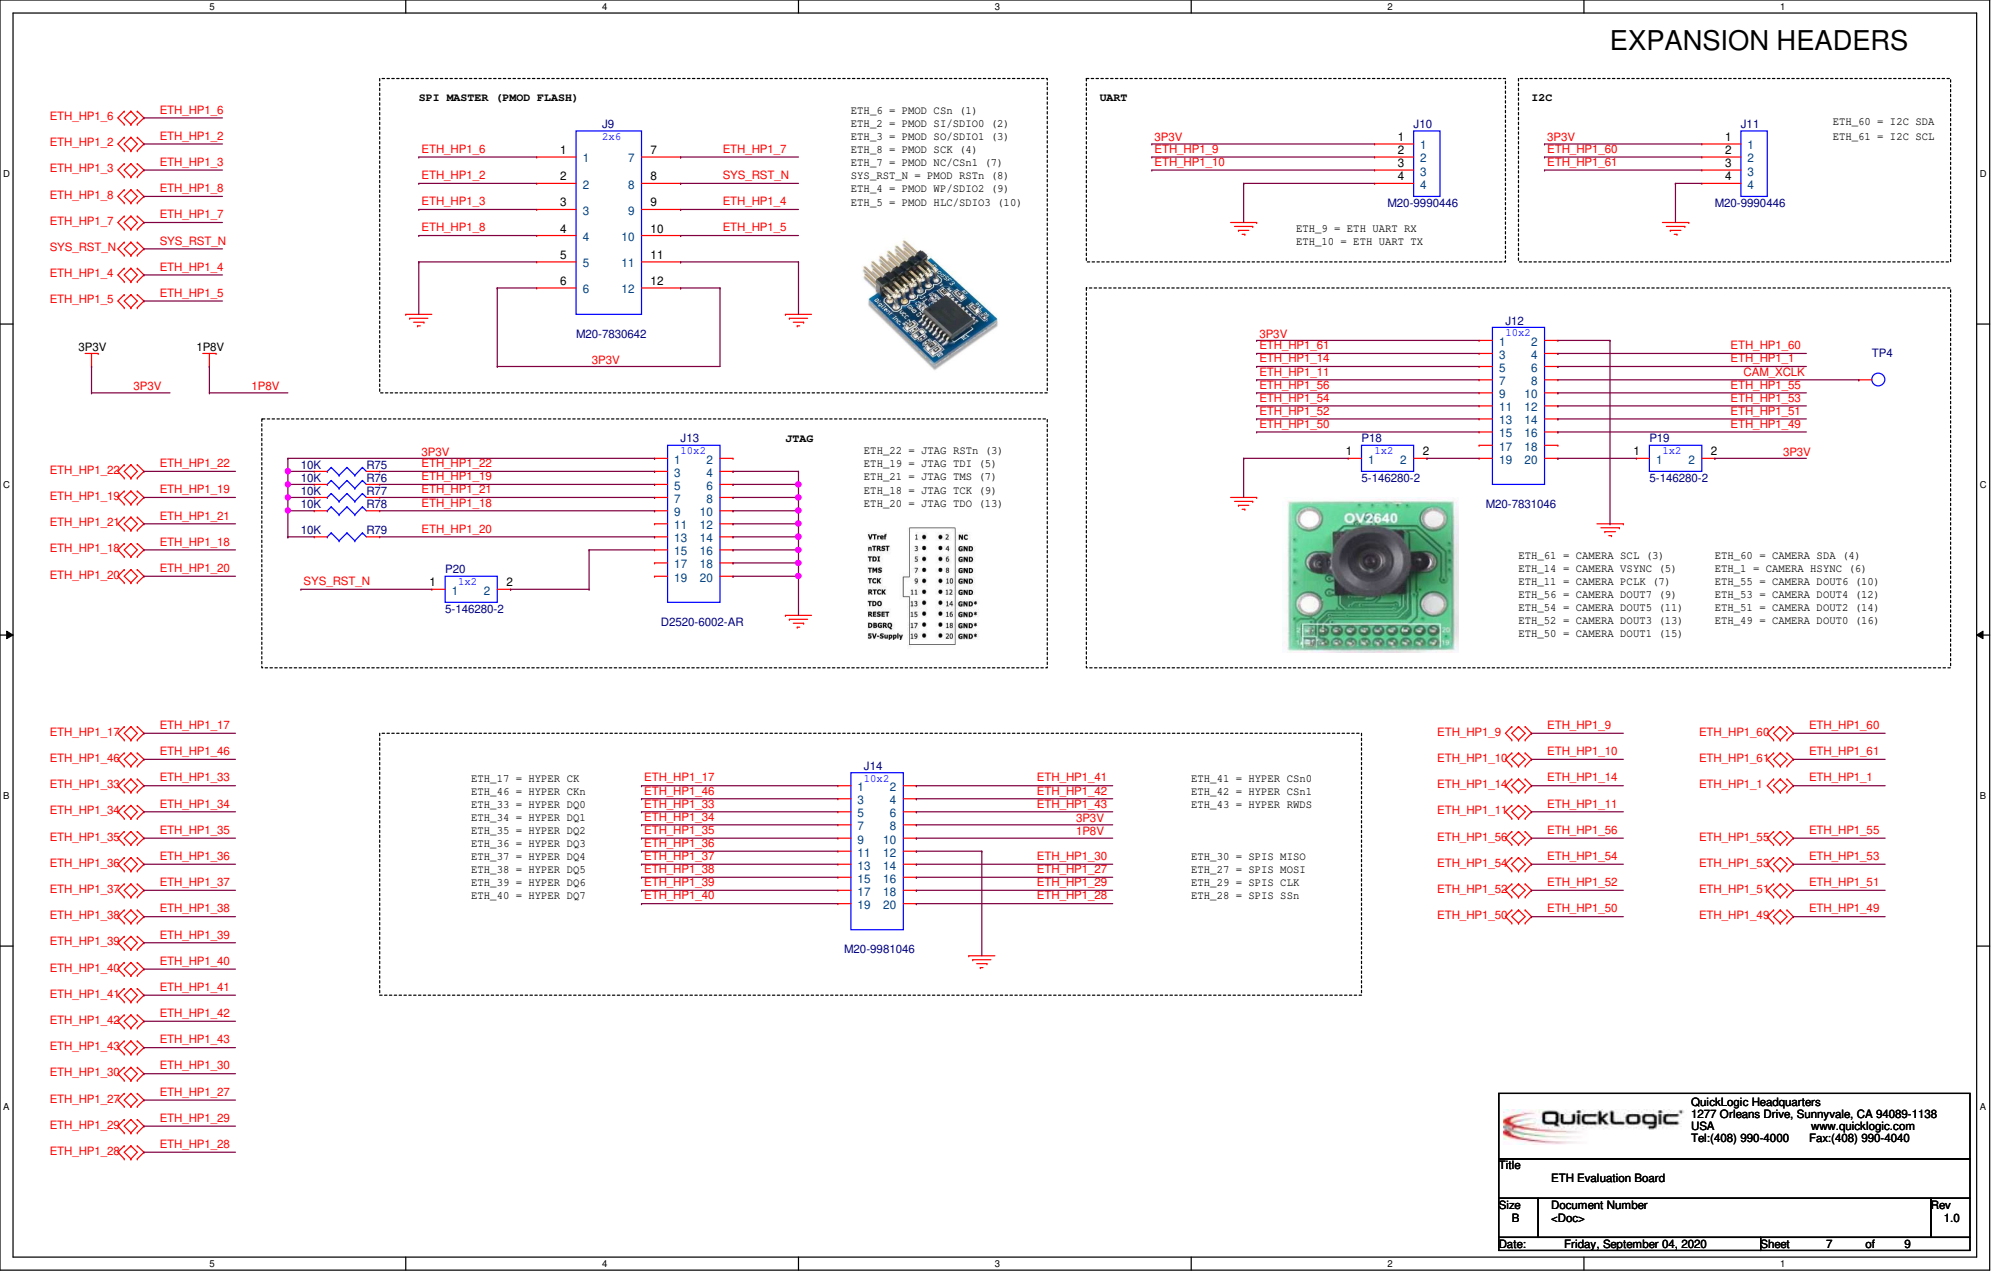
[picture p31: page 7]

QuickLogic Headquarters
1277 Orleans Drive, Sunnyvale, CA 94089-1138

# LEDs

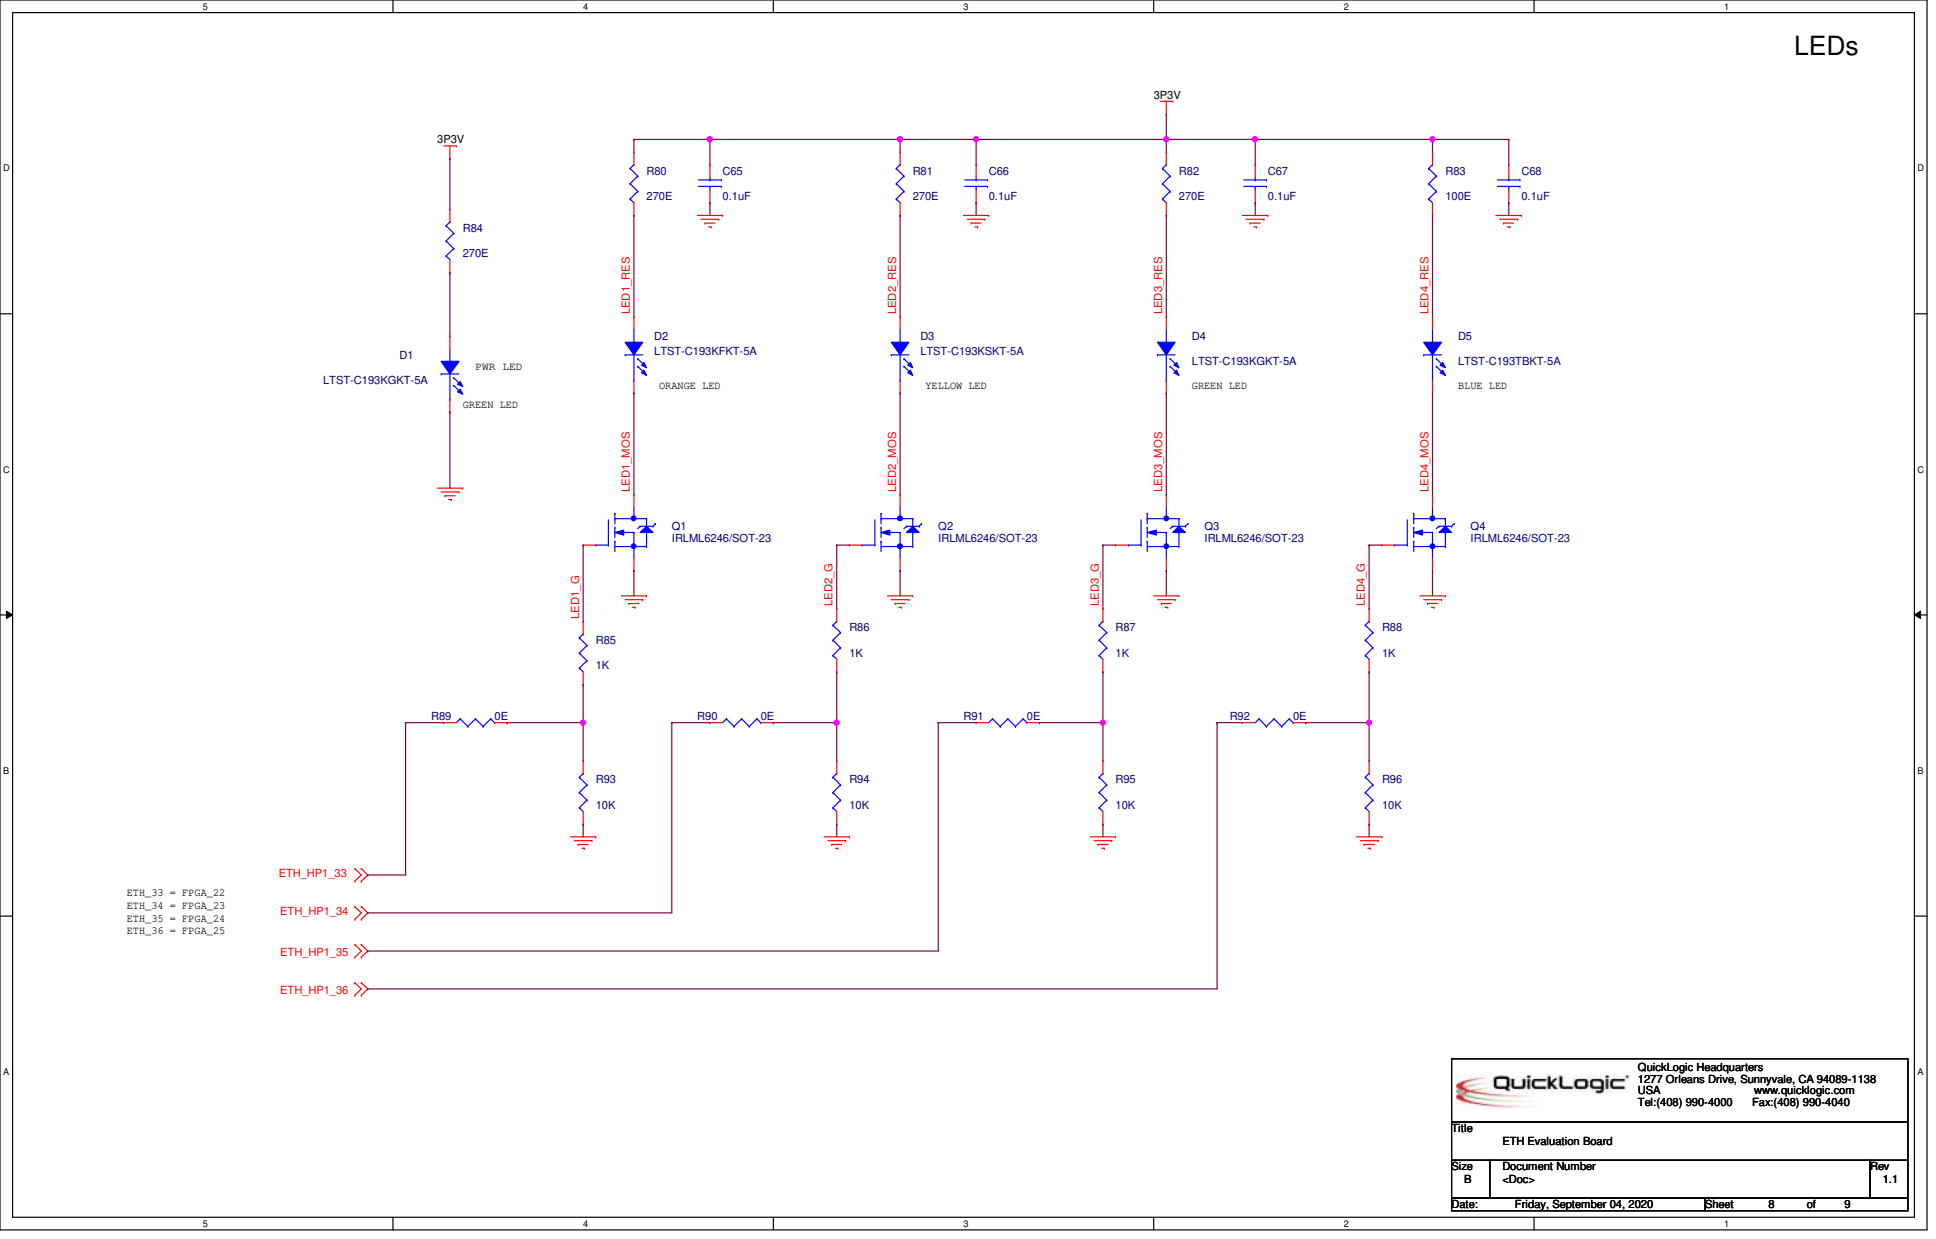
[picture p32: page 8]

QuickLogic Headquarters
1277 Orleans Drive, Sunnyvale, CA 94089-1138

# Mounting Holes and ESD Strip

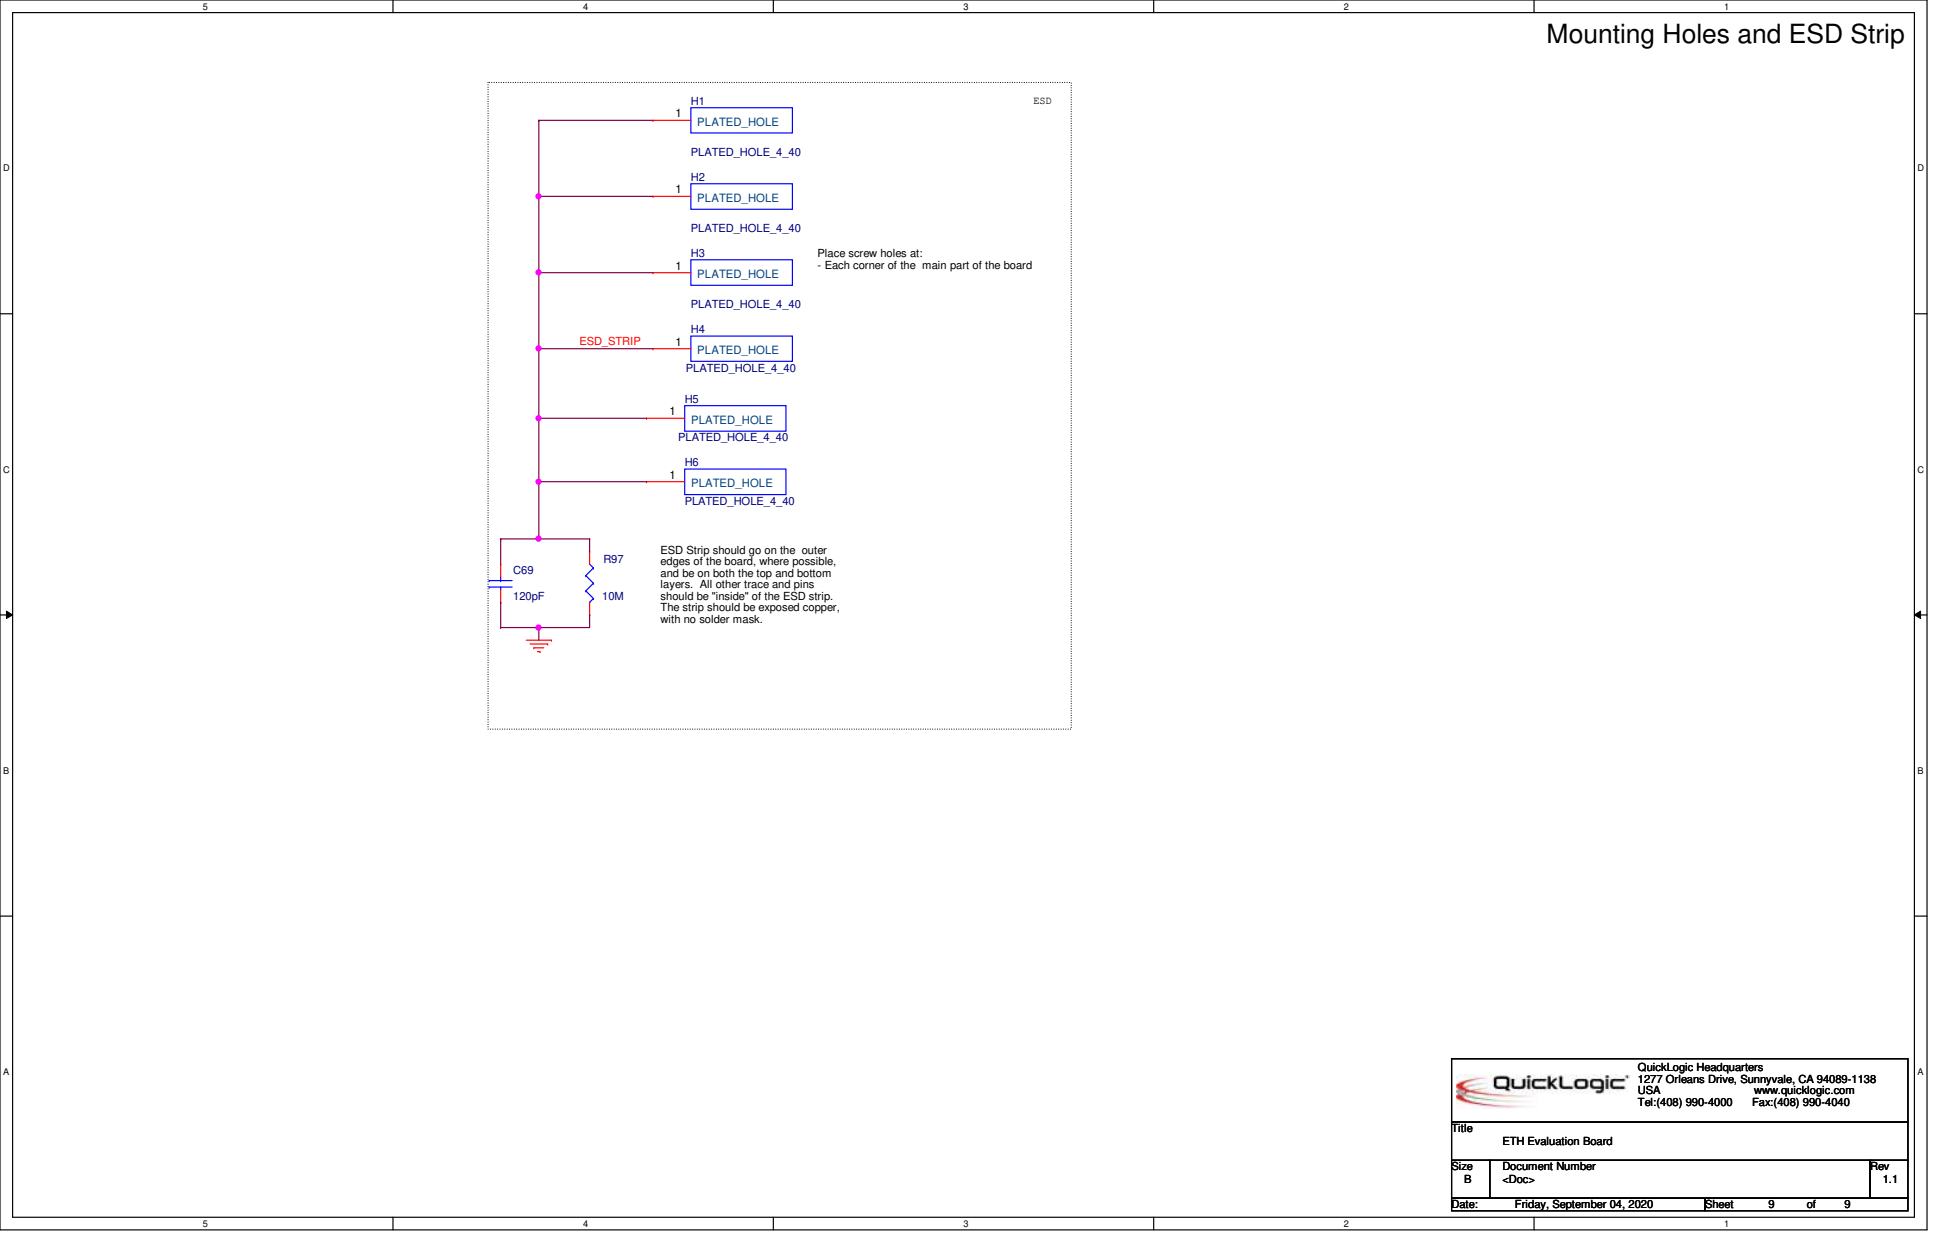
[picture p33: page 9]
ESD; Title; Size; Document Number; Rev; Date:; Sheet; USA; www.quicklogic.com; Tel:(408) 990-4000; Fax:(408) 990-4040; <Doc>; Friday, September 04, 2020; PLATED_HOLE_4_40; PLATED_HOLE 1; ESD_STRIP

Place screw holes at:
- Each corner of the main part of the board

ESD Strip should go on the outer
edges of the board, where possible,
and be on both the top and bottom
layers. All other trace and pins
should be "inside" of the ESD strip.
The strip should be exposed copper,
with no solder mask.

QuickLogic Headquarters
1277 Orleans Drive, Sunnyvale, CA 94089-1138

ETH Evaluation Board
