anthonyle-ql/Salinas/docs/QFN64_9x9_sempac.pdf

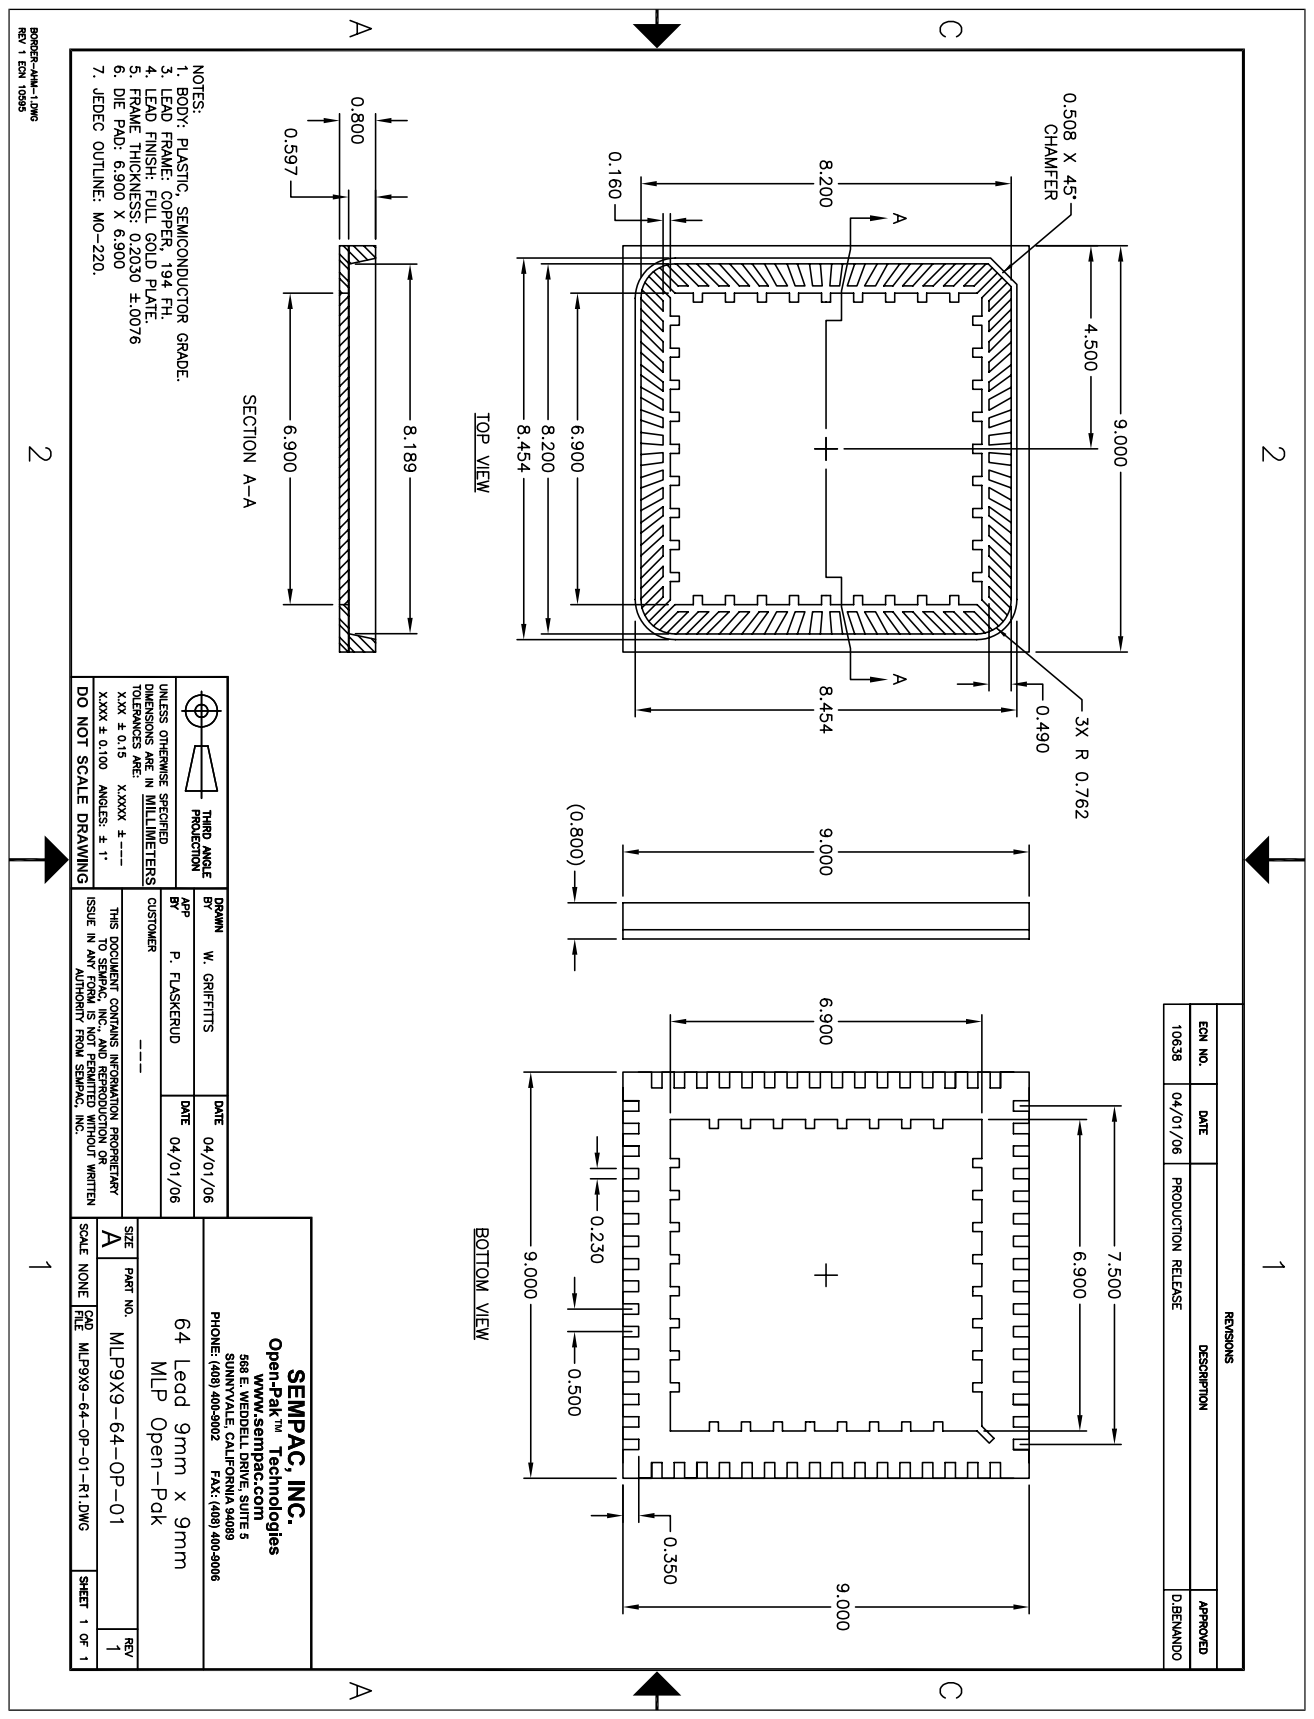
[picture p34: page 1]
