anthonyle-ql/Salinas/(list of files, drawings)

Other design files:
C19054_SALINAS.DSN
