anthonyle-ql/Salinas/(commit log)

2020-09-03 Complete Salinas version 1.1 schematic Update to Salinas Design.docxStill need to update the BOM
    [Arnold_QL_ETHZ.xlsx, C19054_SALINAS.DSN, Salinas1.0 Bring Up Report.xlsx]
2020-09-05 Update schematic based on review with Infiniti Solutions.
    [C19054_SALINAS.DSN]
2020-09-08 Salinas V1.1 BOM
    [c19054_SALINAS_BOM.XLSX]
2020-09-14 1. Update schematic to match with changes from Infiniti Solutions 2. Update BOM to remove socket and point to assemble P5
    [C19054_SALINAS.DSN, c19054_SALINAS_BOM.XLSX]
2020-09-14 Update BOM
    [c19054_SALINAS_BOM.XLSX]
2020-10-12 Submit Salinas layout and schematic for version 1.1
